cchengoran525/Shadow-Carrier/shadow_carrier_on_rockchip/world/README.md

# world_lab — [世界] 线实验记录与设计决策

> 独立实验区，不依赖/不修改工程任何现有代码。
> 收编进仓库时整体迁移为 `world/` 模块。

## 定位

世界模型 = 让决策端(HRI)知道"周围有什么、哪里能走"。
**不只是认门**——门会开、场景会变，门只是区域(region)的一个填充者。
所有接口按通用语义设计，预留扩展。

## 架构定稿：三层各管各的（2026-08-24）

| 层 | 模型/方法 | 频率 | 职责 |
|---|---|---|---|
| 快语义 | yolov8n INT8（现有 yolo_daemon） | 10-15Hz | 追人、COCO 类物体 |
| 慢语义 | **YOLO-World v2s INT8**（待部署） | **1Hz** | 开放词汇：门/冰箱/饮水机/障碍类别 |
| 几何 | OpenCV（本目录 v3 管线） | 1-2Hz | 可通行性/墙地交界/门框几何验证 |

依据（2026-08 网络调研）：
- RK3566 NPU 只有 INT8 可用（12-18FPS），FP16 掉到 3-5FPS 且 CPU 回退
- yolov8n INT8 ≈ 18FPS；YOLO-World v2s 估 4-8FPS → 只能当慢环
- NPU 预算：yolov8n 55ms×10Hz + YW 200ms×1Hz ≈ 75% 峰值，可行但 YW 不得超 1Hz
- "检测器+几何地图=语义网格"是 2025 机器人主流架构（DIV-Nav/OpenVox/OneMap），方向验证无误

### YOLO-World 部署路径（未完成）
1. PC 装 rknn-toolkit2 **2.0.0**（1.3/1.6 有报错前科）
2. 词汇表**导出时定死**（prompt-then-detect 重参数化进权重），建议词表：
   `door, doorway, refrigerator, vending machine, water dispenser, couch, chair, table, potted plant, tv, staircase, person`
3. `model_zoo/examples/yolo_world/python/convert.py` 转 v2s INT8 (rk3566)；clip_text 只支持 FP16，**离线跑一次**存文本嵌入即可
4. sftp 上板 → 先离线测速（验收线 ≥3FPS）→ 接入融合架构当慢语义环
5. 板上无外网，模型文件 PC 下载后传输

## 实验记录

### B1 门检测三轮（2026-08-24，全部板上实测）

| 轮 | 方案 | 结果 |
|---|---|---|
| v1 | 固定阈值 Canny 50/150 + Hough | ❌ 低对比度门框 0 候选 |
| v2 | 自适应 Canny(median±) + 膨胀 + 共线段合并 + 内部边缘密度 | ✅ demo 门正对/斜对均检出，但有无门槛误报 |
| v3 | + 几何先验（宽高比 0.25~1.3、门框底边须达画面 60% 高） | ✅ **回归基准 3/3 命中、0 误报，参数冻结** |

- 基准集：正对门 / 斜对门 / 走廊门（必须检出）+ 宿舍 / 卫生间（必须零误报）
- 验收脚本 `regression.py`；**改 `params.py` 任何参数必须重跑基准**
- 单帧耗时（带负载）：340~1570ms → 几何环定档 1-2Hz
- 已知边界：消失点仅走廊等强结构场景可靠（不进 grid.json）；杂乱场景 Hough 会飙到 3.5s，需限线数/降分辨率/早退（待做）
- 门检测最终角色：给 YOLO-World 的 door 检出做**几何验证**与兜底，不单独当主力

### 融合第零步（2026-08-24）

`fusion/fusion_test.py`：MJPEG 抓帧(只读) + `/api/detections`(只读) + v3 几何 → 单帧网格快照
- ✅ 机制全通：YOLO bbox 落格正确（obj:tv 对准显示器）
- 标签体系（通用槽位，预留扩展）：`free / blocked / region:<name> / obj:<class>`
- 优先级：obj > region > blocked > free
- 待做：60s 连续压测；帧与 detections 有几十毫秒错位，需量化偏差

### grid.json v1 字段草案（[世界]→[HRI] 冻结接口）

```json
{
  "ts": 0.0,
  "frame_size": [640, 480],
  "objects":  [ {"cls": "person|door|refrigerator|...", "conf": 0.0,
                 "bbox": [x1,y1,x2,y2], "cell": [r,c], "source": "yolo_world|yolov8n|hough"} ],
  "grid":     [ [{"label": "free|blocked|region:*|obj:*", "sources": [], "conf": 0.0}, ...8], ...3 ],
  "timing_ms": {"geometry": 0, "total": 0}
}
```
- `objects[]` 完全开放类别，HRI 按 cls 查询，不写死业务语义
- 待加：地面单应映射后的极坐标（8扇区×3距离环），当前 grid 是图像空间占位版

## 文件清单

| 文件 | 说明 |
|---|---|
| `params.py` | 冻结参数（改动须过回归） |
| `door_v3.py` | 门检测/几何管线（终版） |
| `regression.py` | 验收脚本（基准 8 张照片） |
| `offline_door_test.py / _v2.py` | v1/v2 历史版本（留档） |
| `fusion/fusion_test.py` | YOLO+OpenCV 单帧融合 |
| `fusion/geometry_daemon.py` | 世界快照生成（once/loop/scan，三源融合，grid.json 生产者）|
| `fusion/geometry_map.py` | 滚动地图（HIDE 数据供给，TTL 30s）|
| `fusion/polar_mapper.py` | 像素↔极坐标（射线-地面求交，显式 tilt_deg）|
| `fusion/auto_calib_pose.py` | PnP 扫掠一键标定（H(tilt)/俯角拟合）|
| `fusion/solve_desk_pose.py` / `validate_desk.py` | 单次位姿反解 / 棋盘精度验证 |
| `fusion/of_bridge.py` | 光流桥原型（YOLO 抽帧↔光流插值，录制/评测）|
| `fusion/pose_server.cc` | YOLOv8-Pose 旁路服务（派生 facing/offering，纳秒触发）|
| `fusion/lidar_guard.py` | **V2 雷达避障核**（扫描帧→安全包络+命令过滤，纯逻辑零依赖；见下节）|
| `fusion/lidar_guard_daemon.py` | 扫描文件→安全包络文件的常驻桥（`--once/--replay/--record`）|
| `fusion/test_lidar_guard.py` | 避障核离线回归（51 断言，无硬件）|
| `fusion/calib_prod.json` | **生产位姿经验标定**（Tier1b 已知距离三点：h=148mm/tilt=0.43°，距离 ≤2%）|
| `fusion/calib_pose.json` | PnP 扫掠拟合结果（地面 128~140）|
| `CALIBRATION.md` | **标定总纲**（四层触发流程/工具/验收/原则）|
| `DEPLOY_A35.md` | yolo_daemon 时间戳部署 runbook |
| `polar_mapper.py` / `selftest_polar.py` | 映射模块根副本 + 数学自检 |
| `photos/` | 基准照片 + 各轮标注图 |

## 当前状态 (2026-10-04)

> ✅ **A3.1 完成**：生产文件已全部入仓（本目录即源码备份，与板上 `~/world_lab/` 同步）：
> `geometry_daemon.py` / `polar_mapper.py` / `geometry_map.py` / `auto_calib_pose.py` / `of_bridge.py` /
> `pose_server.cc` / `calib_prod.json` / `calib_pose.json` / `CALIBRATION.md`（均在 `fusion/` 或本目录）

- **grid.json v1 已交付**（冻结接口 [世界]→[HRI]）：`objects[]{cls,conf,bearing_deg,dist_m,...}` + `grid_polar[3][8]` + `free_directions_deg` + `map{doors,free_sectors,...}`
- **三层架构合体**：yolov8n（快）+ hough（门几何）+ YOLO-World（慢语义，开放词汇，板端 NPU）
- **极坐标映射**：PnP 标定链 + 一键 `auto_calib_pose.py`；生产角 tilt=112 地面复标后**测距 ≤2%**（Tier1b 已知距离实物法，`calib_prod.json`）
- **滚动地图**：`geometry_map.py` 被动累积门/物体/自由扇区 → `/dev/shm/world_map.json`，HIDE 零延迟主路径；扫掠降兜底
- **俯仰悬案已裁定**：112=几何水平正确（桌面 116.4 系未摆平）；跟随 production 固定 112，V0.2 抬摄像头后再议工作角

## 下一步

1. ~~**[A3.1] 把板上生产文件迁入 git**~~ ✅ 完成（2026-10-04）
2. Tier4 三方距离互校（PnP vs tracker `dist_m` vs 超声），等 [云台] tracker 上机
3. 与 [HRI] 联合验证 HIDE 选点（滚动地图路径）；已问 [HRI] 是否将选点升级为"亲和度打分取最大"（见 EXCHANGE 10-04 21:00）
4. （P2，冻结后）光流桥 daemon 接口、pose 接入 geometry_daemon、调度器落地
5. IMU 消费（[云台] 探通 MPU6050 后）：yaw rate → 极坐标航向/地图一致性（已提接口需求）

## sector_score v2 审核修复（2026-10-11）

[世界] 代码审核发现并修复 6 项（`world/fusion/sector_score.py`），回归夹具 `test_sector_score.py`（13 断言，改权重/规则必须全绿）：

| # | 问题（实测证据） | 修复 |
|---|---|---|
| A | 两热点近反向时圆形均值退化（门 0°/180° → path 罚到随机扇区） | 合成向量模长 `< OPPOSITE_GUARD(0.25)` 跳过 |
| B | 全扇区被硬禁区覆盖时仍返回被 mask 的 best | `best_sector=None` + `fallback_masked=True` |
| C | CLASS_W 物体被当成"路中间"热点 → 洪泛惩罚（5 物罚 5 扇区） | path 只吃 **门+家电**；类别走独立惩罚 |
| D | `wall_back` 把"开阔地板"当"背墙"（free+wall_back 双重奖励） | 改为「近环 free + 中/远环 blocked」判定，**依赖 grid_polar**；无则不加成 |
| E | 无 margin：两个并列最优仍 confident | 暴露 `margin`（best−second），`confident` 要求 ≥0.2 |
| F | blind 加成落在 mask 扇区 | blind 跳过 masked；mask 分数按扇区去重 |

配套（生产者侧，缓解"很少 confident"的结构问题）：
- `geometry_map.py`：自由证据**按环记录**（键 `ring:sector`，近+中环），旧键（纯 sector）兼容映射为 ring 0
- `geometry_daemon.py`：把 `grid_polar` 传给打分器（背墙判定用）

新增输出字段（纯增量）：`margin` / `ranking` / `fallback_masked`。

## 10-22 修复：生产接线 + "路中间"几何（机主指派复核）

> 触发：机主质疑"HIDE 到底是远离门还是门侧？"→ 查代码发现两处**语义/接线**错误。
> **权重全部未动**（`W` 原值），只改几何算法与数据接线；14 个离线测试文件全 exit 0。

### ① 生产接线 bug：`summary()` 不带 objects → 打分器一半规则空转

`geometry_daemon` 把 `m.summary()` 喂给 `score_map()`，但旧 `summary()` 只输出
`doors/free_sectors`。于是**生产里** `objects` 恒为空 → 家电惩罚、`CLASS_W["person"]`（10-12
`hide_occupied` 的修复）、硬禁区 mask、门-家电 "路中间" **全部不生效**；单测因为手喂
`objects` 才全绿（典型"测试绿、生产空转"）。

- 修复：`geometry_map.summary()` 增 `objects[]{cls, bearing_deg, dist_m, sector, hits, age_s}`
  （纯增量；grid.json `map{}` 只加字段）

### ② "路中间"其实是角平分线，不是连线中点

旧实现取两热点 bearing 的**圆形均值**，只有两者**等距**时才等于连线中点。门通常 3~5m、
家电 1~2m → 角平分线落到两者之间的**空地**，真正被走的线（靠近远端点）没罚；而近反向对
（门↔远家电）被 `OPPOSITE_GUARD` 一刀切跳过 —— 那恰是最忙的一条路。

- 修复：`dist_valid` 且两端有 `dist_m` → **向量中点**（`x=d·sin b, y=d·cos b`）；
  距离不可信 → 退回角平分线并在 `reasons["path_bisector"]` 标注；中点距车体
  `< PATH_MID_MIN_M(0.5m)`（这条路穿过车）跳过
- 新增 reasons 键（纯增量）：`path_geo` / `path_bisector`

### ③ HIDE 落点回退"门优先"= 朝门走（`scripts/hri_state.py`，属 [HRI]）

HIDE 语义是**远离门**（门 = 交互亲和度极高 → 强惩罚），但旧回退直接把**门的方位**
当安全点 → `GOTO_SAFE <bearing>` 朝门转身+前进 ≤1.5s。

- 修复（机主直接指派跨线修改，请 [HRI] 复核）：回退顺序改为
  **打分 → 自由方向（排除门 ±45°）→ 背离门**；顺带修 `map.free_sectors`（dict）被
  `abs()` 的 TypeError
- 回归：`scripts/test_pick_safe_spot.py`（6 断言）
