cchengoran525/Shadow-Carrier/shadow_carrier_on_rockchip/deploy/c3-watchdog/README.md

# C3 USB Watchdog (免物理插拔恢复 C3)

## 背景
ESP32-C3 通过 USB-C 直连 KickPi 时, 偶发"从 USB 消失 / 枚举卡死", 表现为
网页遥控还在但指令到不了 C3、云台失声、电机无响应 —— 历史上需**手动重新插拔**。
典型触发: 舵机堵转电流冲击导致掉电/复位 (见 EXCHANGE 2026-10-03 [云台] 事故分析)。

## 能力边界 (诚实说明)
| 情况 | 本看门狗 | 说明 |
|---|---|---|
| C3 仍在 USB 上, 但软链/服务异常 (枚举卡死) | ✅ 自动 `usbreset` 恢复 | 已实测通过 |
| C3 从总线消失, 但仍供电 (枚举级) | ✅ xHCI 深度复位 (unbind/bind), 实测 1s 重枚举、相机不受影响 | 2026-10-21 验证 |
| C3 真掉电 / 无 D+ 上拉 | ❌ 只能记日志等待自行枚举 | 需可控 VBUS(GPIO/uhubctl) 或电源侧解决 |

## 文件
- `c3_watchdog.sh` —— 每 3s 检查 `303a:1001` 与 `/dev/c3_controller`; 连续 2 次异常则 `usbreset BBB/DDD` 复位, 失败则重启 `rk-control`
- `c3-watchdog.service` —— systemd 常驻 (Restart=always)

## 安装 (板端, 需 root)
```bash
sudo install -m 755 c3_watchdog.sh /usr/local/bin/c3_watchdog.sh
sudo cp c3-watchdog.service /etc/systemd/system/c3-watchdog.service
sudo systemctl daemon-reload
sudo systemctl enable --now c3-watchdog
```

## 验证 (安全: 仅删软链, 设备仍在)
```bash
sudo rm -f /dev/c3_controller     # 模拟异常
sleep 15
ls -l /dev/c3_controller          # 应已被 udev 重建
sudo tail /var/log/c3_watchdog.log
```
预期日志: `reset via usbreset 005/002 (5-1)` → `recovered (symlink present again)`。

## 备注
- 现有 udev 规则 `99-c3-usb.rules` 会在设备重新枚举时自动重启 `rk-control`, 与看门狗互补
- 若 C3 掉电型掉线反复出现: 优先解决电源(电机/舵机与 C3 分开供电、加电容), 而非换传输

## 为什么"原生 USB 老要重插"（2026-10-21 调研）

**不是 USB-C 接口的通病，是 ESP32-C3/S3 内置 USB Serial/JTAG（原生 USB）的已知行为：**

1. **C3 官方文档（USB Serial/JTAG Console → Sleep Mode）**：light sleep 时 APB/USB PHY 时钟被门控，**USB PHY 的 D+ 仍保持上拉** → 主机看不到"拔出"，可能**不会重新枚举**；官方给的恢复办法就是**物理拔插 USB**。
   <https://docs.espressif.com/projects/esp-idf/en/v5.2/esp32c3/api-guides/usb-serial-jtag-console.html>
2. **Espressif FAQ（USB）**：C3/S3 的 USB-Serial-JTAG 在芯片重启时会重新初始化；若固件不稳定/反复复位，主机会看到**每隔几秒连上又断开**。建议：手动进下载模式，或**先烧一版稳定固件走 UART**。
   <https://docs.espressif.com/projects/esp-faq/en/latest/software-framework/peripherals/usb.html>
3. **TinyUSB #2943（S3）**：S3 上电时 DP/DM 先被 mux 到 Serial-JTAG，固件再切到 OTG 时主机可能已锁在 JTAG；**中间加一个 USB hub 就能正常枚举**。
   <https://github.com/hathach/tinyusb/issues/2943>
4. **`ttyACM*` 是 MCU 本身**：复位/重启时端口必然消失再出现（`ttyUSB*` 的桥片则不会）。所以"复位就掉口"是原生 USB 的正常语义；问题在于**主机不一定重新枚举**。
5. 另有一个独立常见原因：**充电线（charge-only）只有 VBUS、没有 D+/D-** → LED 亮但 `lsusb` 里没有设备。换数据线即可。

## S3 重构建议（避免反复拔插）

按"最稳 → 次稳"排序：

1. **控制链路改用 USB-UART 桥**（CH340/CP2102/FT232，`ttyUSB*`）：桥片与 MCU 解耦，**MCU 复位不影响串口枚举**；原生 USB 只留给烧录/调试。这是机器人控制链路最稳的做法。
2. **S3 与 RK 之间加一个 USB hub**（TinyUSB #2943 的实证），并用**支持每端口断电的 hub + `uhubctl`**：看门狗即可"电源循环"端口，软件自动恢复，不用手拔。
3. 若坚持原生 USB：
   - 固件**不要 reconfig USB 引脚**、**USB 连接时不要进 light sleep**（C3 用 `CONFIG_USJ_NO_AUTO_LS_ON_CONNECTION`；保留 `CONFIG_RTC_CLOCK_BBPLL_POWER_ON_WITH_USB`）；
   - 尽早把 DP/DM mux 切到目标外设（OTG 或 JTAG），避免主机锁在 JTAG；
   - 避免运行中软件复位（看门狗复位）导致 D+ 不释放。
4. **硬件**：C3/S3 用**独立稳定 5V**（不要和电机/舵机共轨），加 470–1000µF 储能 + ESD/CC 电阻；上电顺序 **KickPi → C3 → 电机电源**。
5. **看门狗边界**：总线上完全没有设备时，`usbreset` 无目标；只能记日志/快照（本脚本已加"absent 每 60s 一次 + USB 树/dmesg 快照"）。要自动恢复，必须配合**可控 USB 电源开关/hub**。

## RK3566 板级 USB 老毛病（古早踩坑实录，2026-08-07 → 10-14）

> 结论先说：**"要反复插"不只是 C3/S3 原生 USB 的问题，RK 板这端的 USB 枚举/供电也是老病根。换 S3 不会自动修好。**

| # | 方案 | 结果 |
|---|---|---|
| 1 | RK 板载 UART `ttyS5/S7/S9` | ❌ TX 无物理信号 |
| 2 | CH340 USB-TTL | ❌ 自环通、接 C3 无信号，**OHCI 崩溃** |
| 3 | CP2102 USB-TTL | ❌ 同崩溃 |
| 4 | WiFi TCP（C3 连热点） | ❌ AP6255 beacon 对 ESP32-C3 不可见 |
| 5 | **C3 USB 直连（CDC ACM）** | ✅ 可用，但**冷启动/掉电后常不重新枚举** |

**佐证：**
- `gimbal/README.md`（2026-10-03）："**放大器=板级**：C3 掉电后 USB 不重新枚举的老毛病，把一次舵机事件放大成遥控全失效"；"**证伪实验**：换硬件后若'无咔咔却仍掉线' ⇒ **板级 USB 枚举缺陷独立存在**，需单治"。
- `README.md` 已知问题 #1："冷启动 C3 需插拔（待定位）"。
- EXCHANGE 10-14 22:07：**C3 = Bus5 = OTG/DRD；相机 = Bus7 = Host；不同控制器但共用 RK3566 USB2 PHY 与端口供电域** → C3 重枚举会掀相机；watchdog+udev 曾把 C3 重枚举放大成 rk-control 重启风暴。
- `docs/V2_CHASSIS_GIMBAL_DESIGN.md §19.5/19.6`：VBUS 跌落/线材 IR 压降（1m 28AWG ≈0.42Ω，2A 掉 0.85V）会直接导致 **USB 重新枚举**；验收线 **5V min ≥4.75V**，短粗线 ≤30cm/20–22AWG + 470–1000µF。

**给 S3 迁移的验收清单（不重复拔插）：**
1. **主机侧可控电源**：USB hub + 每端口断电（`uhubctl`）→ 看门狗可电源循环；这是对"板级枚举缺陷"最直接的软件可恢复方案。
2. **避开 OTG/DRD 口**（Bus5）或加 hub 隔离，别和相机共用 PHY/供电域。
3. **供电**：C3/S3 独立稳定 5V（不共电机轨）+ 短粗线 + 470–1000µF；上车前用 USB 电压表测 **min 5V ≥4.75V**。
4. **固件**：USB 连接时不进 light sleep、不重配 USB 引脚、尽早 mux DP/DM；避免运行中看门狗复位。
5. **保留** `c3-watchdog` + 冷启动检查单；S3 的 udev 别名与 `CDCOnBoot` 参数要重做（V2 §5 已提）。

## 已验证的软件恢复：xHCI 深度复位（2026-10-21，免拔插）

本板拓扑：**C3 = `xhci-hcd.4.auto`**（`usbdrd/fcc00000.dwc3`, bus5, OTG/DRD）；**相机 = `xhci-hcd.5.auto`**（`usbhost/fd000000.dwc3`, bus7, Host）——**不同控制器**。

```bash
# 手动深度复位（需 root）
echo xhci-hcd.4.auto > /sys/bus/platform/drivers/xhci-hcd/unbind
sleep 2
echo xhci-hcd.4.auto > /sys/bus/platform/drivers/xhci-hcd/bind
```

**实测**：unbind 后 C3 消失（相机仍在）；bind 后 **C3 1s 内重新枚举**、`/dev/ttyACM0` 回来、**相机完全不受影响**（fps 14.4 / age 10ms）。
**看门狗已集成**：C3 持续 absent **30s** 自动做一次深度复位（冷却 60s）；日志 `deep reset xHCI ...` → `recovered via xHCI deep reset`。

**边界（重要）**：深度复位只对"设备还供电、D+ 仍上拉，但主机没枚举"有效。若 C3 **真掉电/没上拉**，bind 也看不见——这时只能：
- **可控 VBUS/端口电源**（GPIO+MOSFET 或支持 `uhubctl` 的 hub）→ 看门狗断电 1s 再上电，强制重新枚举；
- 或独立 5V + 大电容/换线，减少掉电本身。

## 可控 VBUS / 端口电源（可选，治"真掉电"）

看门狗已内置 3 种后端；配置后，在 xHCI 深度复位仍无效时会自动做一次电源循环。用 systemd drop-in 配（无需改脚本）：

```bash
sudo mkdir -p /etc/systemd/system/c3-watchdog.service.d
sudo tee /etc/systemd/system/c3-watchdog.service.d/vbus.conf >/dev/null <<'EOF'
[Service]
# 三选一：
# 1) GPIO 控 MOSFET/load switch（sysfs；C3_VBUS_ACTIVE=1 高有效，0 低有效）
Environment=C3_VBUS_GPIO=123
Environment=C3_VBUS_ACTIVE=1
# 2) uhubctl 支持每端口断电的 hub
#Environment=C3_HUB_LOC=5
#Environment=C3_HUB_PORT=1
# 3) 自定义命令（命令自己完成断电/上电）
#Environment=C3_VBUS_CMD=/usr/local/bin/c3_power_cycle.sh
Environment=C3_VBUS_OFF_S=2
Environment=C3_VBUS_SETTLE_S=3
EOF
sudo systemctl daemon-reload && sudo systemctl restart c3-watchdog
```

- **GPIO 必须驱动 MOSFET/负载开关**，不要用 GPIO 直接给 C3 供电（电流不够/会烧）。
- 自检：`sudo c3_watchdog.sh --selftest-vbus` → 日志出现 `vbus cycle via ...`；正常启动日志会标 `vbus=yes/no`。
- 日志顺序：`deep reset xHCI ...` →（仍失败）`vbus cycle via ...` → `recovered via VBUS power cycle`。
