cchengoran525/Shadow-Carrier/shadow_carrier_on_rockchip/world/fusion/calib_report.md

# 相机位姿标定报告 (2023-03-02 21:33)

| tilt指令 | 光心高度mm | 真实俯角° | RMS px | 角点 |
|---|---|---|---|---|
| 128 | 98.8 | 20.00 | 1.94 | 54 |
| 132 | 95.9 | 25.57 | 1.77 | 54 |
| 136 | 93.1 | 30.85 | 1.60 | 54 |
| 140 | 90.6 | 35.47 | 1.43 | 54 |

H(cmd) = -0.6847·cmd +186.4 (残差≤0.2mm)
tilt_true(cmd) = 1.2921·cmd -145.2 (残差≤0.30°)
等效零俯角指令 = 112.4, DEG_PER_CMD = 1.292

> 换相机/换位置后重跑 auto_calib_pose.py 即可刷新本报告
