cchengoran525/Shadow-Carrier/docs/V2_LIDAR_AVOIDANCE.md

# V2 激光雷达避障设计（YDLIDAR X3 Pro / 夹层安装 / 约束层架构）

> 写于 2026-10-16。回答一个问题：**雷达到手之前，避障逻辑先怎么备好**——到手后 30 分钟能上车，
> 且不打断 demo 冻结期的任何现有行为。
>
> 关联：`V2_CHASSIS_GIMBAL_DESIGN.md` §10.5（选型）/§10.5.1（作用边界）/§13（×HIDE 亲和度）/
> §14（暗光与传感器分工）/§15.7（夹层安装决议）；`DEFERRED_WORK.md` §2（雷达 L1）；
> `V2V3_ROADMAP.md` §2 V2b（传感器全装）；`world/fusion/test_bearing_convention.py`（方位角约定权威自检）。
> **姊妹篇**：`V2_LIDAR_FOLLOW_UPGRADE.md`（把雷达从"障碍源"升级为"匿名腿航迹源"：覆写阶梯 / 人-障碍仲裁 /
> 相机盲区授权与实测协议 / 度量纪律 §8）。两篇共用 `person_legs` 与方位角约定，彼此不阻塞。

---

## 0. 定位：雷达三件事，本文只做第 ② 件

| # | 用途 | 归属 | 状态 |
|---|---|---|---|
| ① | **几何源**：门框/墙/开阔区 → grid.json 第四源 `lidar`（替换手标 grid.json） | [世界] geometry_daemon L1 | V2b，不在本文 |
| ② | **安全**：360° → **运动约束**（限速/停车/绕行提示） | 本文 | **本次备好** |
| ③ | SLAM / 建图 / 重定位 | PC 科研轨（离线） | V2 只负责**录原始帧** |

一句话边界：**避障不是"另起一个规划器"，而是给已有运动命令加一层可测的约束**。
它不决定"该不该跟、该不该让"（那是 follow / hri_state 的语义），只回答
"以这个速度朝这个方向走，会不会撞、最多能多快"。这条分界让整套东西可以离线断言，
也让 demo 期可以整体关掉（见 §7 惰性契约）。

### 0.1 本次交付物（已入仓，无硬件即可跑）

| 件 | 路径 | 说明 |
|---|---|---|
| 避障核（纯逻辑） | `world/fusion/lidar_guard.py` | 扫描帧 → 安全包络 + 命令过滤；零第三方依赖 |
| 离线回归 | `world/fusion/test_lidar_guard.py` | **56 条断言**，`python3 test_lidar_guard.py` 全绿 |
| 参数文件 | `configs/lidar_guard.json` | 装车实测只改这里，不改代码 |
| 常驻桥 | `world/fusion/lidar_guard_daemon.py` | 扫描文件 → 安全包络文件；支持 `--once/--replay/--record` |
| 命令收口 | `scripts/rk_control.py`（`uart_send` 前） | **惰性**：没有安全文件时逐字节不变；新增 `GET /safety` |
| 仿真验证 | Webots `SIM_LIDAR=1` + 场景 `lidar_sweep_block` | 几何真值 360° 扫描走**同一条**代码路径 |
| 文档 | 本文 | 含参数表、失效清单、上车三步、待办 |

**待硬件（V2a/V2b 的活）**：YDLidar-SDK aarch64 编译 + 扫描桥（写 `lidar_scan.json`）、
装车几何实测（传感器位置/柱位/平面高度/满 PWM 车速）、参数在实机上定标（§8.4）。

---

## 1. 现状与为什么单独设计

现有唯一避障路径（V1，全部保留不动）：

```text
HC-SR04(正前 ±15°, 2cm 精度) → 固件 UltrasonicSensor → MotorDriver.setObstacleDetected
   → 前向 latch 停车 + 打印 "OBS <0|1> <cm>" → rk_control 读遥测
   → _gaze_drive_loop 倒车脱离（GAZE_ENABLED=False, demo 期未启用）
```

它的能力边界：**一个方向、一个数、20cm 阈值、只看正前**。V2 的雷达带来 360° + 5–10Hz + 8m，
但直接接进去会踩三个坑，这也是本设计的三个立论：

1. **时延链必须显式**（否则"多少米该停"是拍脑袋）。扫描 10Hz（100ms）+ 环 10Hz（100ms）+
   USB/串口（~10ms）+ 固件缓启（~100ms）≈ **t_react = 0.35s**。0.6m/s 时这 0.35s 就吃掉 21cm，
   加上制动 30cm 与保留间隙 8cm → **需要 0.59m 间隙才能跑满巡航速度**。这个数必须写进代码（§4.3）。
2. **禁止双控制器抢底盘**。V1 的教训（`gaze_drive_loop` 与 follow 抢底盘 → 往右拐越拐越偏）说明：
   避障若自带一套运动律，就会和 follow 打架。本设计的解法是**约束层**：不产生新运动，
   只对"别人已经发出的命令"限速或否决。
3. **噪声不得推动整车**。雷达有飞点、玻璃穿透、镜面反射、雨雾；单帧异常必须过迟滞（§4.5），
   这条与 `hri_state` 的施密特去抖、`sector_score` 的 freeze 协议是同一套工程原则。

---

## 2. 传感几何：装在哪、看得见什么、看不见什么

### 2.1 安装（沿用 §15.7 修订版决议）

```text
上层板 z=17.5cm ─────────────────────────────────
                  ↑ 4cm
扫描平面 z≈13.5cm  ← 雷达坐在下层板小基座上（本设计的坐标系原点）
                  ↓ 8cm
下层板 z=5.5cm ──────────────────────────────────
```

- **唯一自遮挡 = 4 根铜柱**（Ø6mm @ 距传感器 17.5cm → 每根 **~2°**）。代码不写死角度，而是
  由 `pillars_xy + sensor_x/y` **自动算遮罩**（含 2° 安装余量），改安装位置只改两行配置。
- **双保险**：铜柱本身在 17.5cm，落在 `range_min_m=0.24` 的近场滤波圈内 → 回波被丢弃；
  遮罩再挡住"柱后 2° 楔形的远端盲区"。两者独立生效，任一条误配都不会漏。
- 轮子（顶 8cm）、上层板（17.5cm）、桅杆、篮子**都不在平面内** → 不需要遮。
- 实测的默认配置里遮罩为 `[[33.9,39.9],[320.1,326.1],[140.1,146.1],[213.9,219.9]]`（±36.9°、±143.1°）。

### 2.2 看得见 / 看不见（这张表就是产品说明书的"能力边界"）

| 物体 | 13.5cm 平面看得见? | 谁兜底 |
|---|---|---|
| 人腿 / 椅子腿 / 桌腿 / 箱体 / 墙 / 门框 | ✅ | — |
| **玻璃门、镜面** | ❌ 直接穿透 | 相机 door_v3 + 超声（互补矩阵主场） |
| **矮于 13.5cm 的东西**（门槛、地漏、躺倒的瓶子、地毯边） | ❌ | 超声（正前）+ 演示时避开 |
| **桌面/台面悬挑**（腿看得见、台面看不见） | ⚠️ 只见腿 | 靠"腿级聚类"保守处理 |
| 台阶**下**（负障碍：向下的落差） | ❌（单线平面原理性看不见） | 场景约束：SC 不做下台阶 |
| 动态物体（人、推车） | ✅ + `closing_mps` 提前量 | — |

**结论**：雷达不是"全知"，它是"腿部高度的 360° 轮廓"。所有失效都必须在 §6 有对应对策与降级，
而不是假装没有。

### 2.3 装车验收 3 条（上车前 10 分钟）

1. **平面水平**：倾斜会变成"远端切到上层板"——软尺量传感器座上沿，两端读数差 ≤2mm；
   或看空场扫描：远点距离环应是一个圆，不是椭圆。
2. **空场干净**：房间中央扫描，`GET /safety` 的 `sectors_m` 应只有四面墙的四个"台阶"，无近距满圈
   （近距满圈 = 平面切到板/柱没被滤掉 → 查 `range_min_m` 与 `pillars_xy`）。
3. **满 PWM 车速实测**：直行 5m 计时 → 填 `configs/lidar_guard.json` 的 `v_at_spd_max`
   （这决定"限速×0.6"到底是多快；填错只是保守/激进，不影响安全逻辑本身）。

---

## 3. 架构：三段解耦 + 一个收口

```text
 ┌── 扫描生产者(V2b, 待做) ──┐   ┌── 本设计(已备好) ──────────┐   ┌── 已有链路 ────────┐
 │ YDLidar-SDK 桥(aarch64)   │   │ lidar_guard_daemon.py      │   │ rk_control.uart_send│
 │ 读 /dev/ttyUSB0           │──▶│  lidar_guard.update()      │──▶│  _safety_filter()   │
 │ 原子写 lidar_scan.json    │   │  → lidar_safety.json       │   │  → 固件(450ms/超声) │
 └───────────────────────────┘   └────────────────────────────┘   └────────────────────┘
     可独立坏/独立重启                 纯逻辑, 可离线回放              单一收口, 惰性生效
```

### 3.1 为什么收口在 RK 的 `uart_send`，而不是固件

- 雷达挂**电子域**（充电宝 5V + USB），只有 RK 有它的数据；S3 拿不到 → 固件无法直接消费。
- `uart_send` 是所有运动命令的唯一出口（follow / hri_state / 弧线绞合 / 网页面板 / 转身动作），
  在它前面过滤 = 一处生效、无人遗漏，且**各控制器不需要知道雷达存在**。
- **固件层完全不动**：450ms 超时 + 超声 latch 仍是最后一道硬件兜底（V1 已验证，不冒回归风险）。
- 代价要写明白：**雷达只能约束"命令"，不能约束"固件自己"**。若将来要固件级雷达反射弧，
  需要新增 `LIMIT` 通道（§10 待办，V3 再谈）。

### 3.2 惰性契约（demo 冻结期的安全阀）

```text
/dev/shm/lidar_safety.json 不存在  →  过滤是直通, 现有链路行为逐字节不变
文件存在且新鲜                     →  按安全包络限速/停车
文件存在但过期 (>1.0s)             →  视为 stale: 只限速到 degrade_speed_mps(0.3), 不施加停车
过滤链自身异常(文件坏/模块缺)      →  放行原命令 + 一条节流日志, 绝不阻断控制
```

**为什么 stale 是"限速"而不是"停车"**：雷达是**增强件**，基础安全由超声（正前）+ 相机（语义）承担。
若雷达一坏整车就停，等于把雷达变成单点故障——这是产品级错误。但也不能装作没事：
`mode/ok/scan_age_s` 会进 `/safety` 与 grid.json 的 `sensors.lidar`（§14.4），
行为层可以据此降级（例如暗光模式 L2 要求 `lidar.ok=true`）。**cap 还是 stop 是可配置的**
（`degrade_action` 语义在过滤层，`degrade_speed_mps=0` 即等价于停）。

---

## 4. 核心算法（每条都有对应断言）

### 4.1 预处理（`to_robot_frame`）

原始 `(方位, 距离)` → 去掉：遮罩角（§2.1）、量程外（<0.24 / >8m）、超近自反射、
**同角去重**（单回波雷达一个方位只有一次回波；同方位双点取更近——这同时挡住了
"腿点与墙点交叠"造成的假聚类）、**飞点**（±3° 内无邻点，或与邻点中位距离差 ≥max(0.30, 0.45×中位)
且 >1.2m → 丢；近处一律保留，因为"近处误停便宜、漏停昂贵"）。稀疏帧（<100 点）不做飞点剔除。

### 4.2 净空：矩形车体 + 走廊（`clearance_dir` / `rotation_gap`）

- 车体是 **30×34cm 的矩形**，不是圆。行进方向 θ 的支撑函数直接给"沿行进半长 / 横向半宽"
  （`|cos θ|·L + |sin θ|·W` 等）——比固定半径准确，且能区分"正着走"和"横着走"。
- **四方向间隙**：只统计落在**行进走廊**（横向 ≤ 车体横半宽 + 5cm 余量）内的点，
  间隙 = 沿行进投影 − 车体沿行进半长（**从保险杠量起，不是从车心量起**）。
- **转向净空**：最近点半径 − 外接圆半径 0.227m（原地转扫掠圈）。
- 障碍"已被甩在身后"（投影 < −0.10m）不计。

### 4.3 速度律：间隙 → 速度上限（`v_from_gap`）

制动距离模型 `v·t_react + v²/(2a) ≤ gap − 8cm`（`t_react=0.35s`、`a=0.6m/s²`）的解析解：

| 障碍间隙（从保险杠算） | 允许速度 | 判定 |
|---|---|---|
| < 5cm（硬间隙 `hard_gap_m`） | 0 | **立即否决**（不等迟滞窗） |
| 0.10 m | 0.05 | blocked（低于 `v_min=0.15`） |
| 0.20 m | 0.22 | 限速 |
| 0.40 m | 0.44 | 限速 |
| **0.59 m** | **0.60** | 刚好跑满巡航（`gap_required(0.6)`） |
| ≥ 0.60 m | 0.60 | 不干预（`v_nom`；包络只限不促） |

- 恢复（解除 blocked）需间隙 ≥ `gap_required(v_nom)+0.15 = 0.74m` → 与触发线 0.59m 形成滞回带。
- **`v_nom` 只做"限"，不做"提"**：速度的期望值归 follow/HRI，雷达只给天花板。
- 参数化好处：`a` 从 0.6（舒适）调到 2.0（室内急刹）时，整张表自动收紧，不用改任何逻辑。

### 4.4 动态目标：提前量（lead compensation）

对每个簇做极坐标最近邻跟踪（贪心关联，门 10°/0.6m），EMA 求径向速度：
- 等效间隙 `gap_eff = gap − max(0, closing)·t_react`——"正在靠近的东西"提前吃掉反应距离；
- 输出 `closing_mps / dynamic`；腿级聚类（宽 5–45cm、距 0.3–5m）单独列出 `person_legs`，
  供 HRI/跟随消费（V3 的"腿级人物"能力这次已经顺手拿到）。
- **主人不是障碍**：跟随的正常收敛由 follow 的距离保持负责（目标 1.2m / 实距 <0.7m 停），
  雷达的 stop 只在"制动距离不够"时兜底（例如主人急停、或路人在中途切入）。

### 4.5 迟滞（`_hysteresis`）

- 判定 `blocked` 需**持续 0.25s**（单帧噪声不推动整车）；解除需**持续 0.4s 且间隙回到 0.74m**；
- 例外：间隙 < 5cm（硬间隙）**首帧即否决**——迟滞不能拖住碰撞保护；
- 确认窗内速度上限不放松（否则"确认"期间还能全速冲）。

### 4.6 绕行提示（`escape`）——V2 麦轮的红利位

前方受阻时给出几何最优的脱离方向：`left/right`（带**符号化 vy**，正值向右）+ 可用速度，
全是 `hold` 则"四面受阻，原地等待"。**本设计不自动执行**：提示交给行为层（follow 的横向偏置、
HRI 的 YIELD），因为"往左让还是往右让"是社交决策，不是几何决策。
（V1 差速底盘只能观测；V2 麦轮横移时这条才是可执行的。）

### 4.7 健康：三种非 ok（`mode`）

| mode | 判据 | 为什么需要 |
|---|---|---|
| `ok` | 帧新鲜且有效点 ≥20 | 正常 |
| `stale` | 帧龄 > 0.6s | SDK 进程死了/线松了 |
| **`suspect`** | 有效点 <20（帧却是新鲜的） | **安静失效**：探头被挡、起雾、镜面脏——SDK 照常出版本、照常刷时间戳，但什么也没看见。这条防止"无事发生"被当作"前方畅通" |

---

## 5. 接口契约（四个，全部纯增量）

### 5.1 扫描帧（生产者 → daemon）`/dev/shm/lidar_scan.json`

```json
{"frame_id": 4211, "ts": 10892.597,
 "points": [[0.0, 2.34], [1.2, 2.31], ...]}      // [方位角°, 距离m]
```
兼容 `{"angles":[...], "ranges":[...]}`（标准雷达输出）。**原子替换写入**（tmp + rename）。

**`ts` 约定用 `time.monotonic()`**（与 guard 内部时钟同源）。2026-10-24 修订：本节旧示例
曾写 epoch 值——guard 按 `now(monotonic)-ts` 算帧龄，epoch 帧的 `scan_age` 恒为 None，
**stale 检测静默失效**（实测踩中，雷达拔线系统仍认为数据新鲜）。guard 现已双时钟兼容
（`lidar_guard.py` update()，T11c/T11d 断言），monotonic 为约定首选，实测记录见附 D。

### 5.2 安全包络（daemon → 命令路径）`/dev/shm/lidar_safety.json`

| 字段 | 含义 |
|---|---|
| `ok/mode/scan_age_s/n_points` | 健康（§4.7） |
| `limits` | `vx_max/vx_min/vy_max/vy_min/wz_max_dps`（SI：m/s、deg/s） |
| `blocked` | `{fwd,back,left,right,rot}` 布尔（已过迟滞） |
| `gap_m` / `rot_gap_m` / `gap_required_m` | 四方向间隙、转向净空、当前速度的需求间隙 |
| `nearest` | 最近障碍（方位/距离/间隙/类别/closing/dynamic） |
| `person_legs` | 腿级行人列表（方位/距离/closing） |
| `sectors_deg` + `sector_m[24]` + `sector_n[24]` | 扇区最小距离（供可视化/调试） |
| `mask_deg` | 生效的遮罩区间（自证配置正确） |
| `escape` | 绕行提示（§4.6） |

### 5.3 命令过滤语义（`apply_to_ascii`）

| 命令 | 语义 |
|---|---|
| `MOVE F/B <spd>` | 前进/后退：对应方向 blocked → `STOP`；否则按 `vx` 包络换算成 PWM 限速 |
| `MOVE L/R <spd>` | **V1 固件语义 = 原地旋转**（坦克转向）→ 受"转向净空/`wz` 包络"约束，**不受横向走廊约束**。V2 麦轮若把左右键改成"真横移"，置 `move_lr_is_rotation=false` 即切回走廊判定（两种语义都已测） |
| `DIFF Lx Ry` | 共模（前进）按 `vx` 包络压到上限；差模（转向）按 `wz` 包络压缩；前进方向 blocked → `STOP` |
| `MEC vx vy wz` | 逐轴钳位（线上单位 cm/s、rad/s ↔ SI 在过滤层换算） |
| `STOP/PAN/TLT/TEL/*` | 一律原样放行（云台与遥测不受避障影响） |

### 5.4 grid.json 的 `sensors.lidar`（§14.4 纯增量，消费方零改动）

```json
{"lidar": {"ok": true, "age_s": 0.08, "mode": "ok", "n_points": 412}}
```
`lidar_guard.grid_sensors(env)` 直接产出该片段，交给 geometry_daemon 合入即可。

---

## 6. 失效模式与对策（逐条交底）

| 失效 | 现象 | 对策 |
|---|---|---|
| 玻璃 / 镜面 | 前方空无一人，实际是玻璃门 | 原理性无解 → 相机 door_v3 兜底；`suspect` 只覆盖"几乎无回波"，穿透时反而有回波 |
| 矮物 / 负障碍 | 完全看不见 | 超声正前兜底；场景约束（不做下台阶）|
| 探头被挡 / 雾 | 帧新鲜但几乎无点 | `suspect` → 降级限速 + `ok=false` 上报 |
| 平面倾斜 | 远端切上层板 → 远点假障碍 | 装车验收（§2.3）+ `range_min_m`；诊断看 `sector_m` 是否出现固定半径环 |
| 飞点 / 多回波 | 单点跳变 | 同角去重 + 飞点中位差滤波 + 迟滞 |
| 人群（多点簇） | 一张"人墙" | 逐簇独立判定；窄簇=腿（可绕）、宽簇=墙（只能等）；绕行提示给出方向 |
| SDK 死 / 线松 | 帧不再更新 | `stale` → 限速（cap 模式），`ok=false` 上报，health 可查 |
| 参数填错（`v_at_spd_max`） | 限速比例不对 | 只影响保守/激进，不影响安全逻辑；§2.3 第 3 条标定 |
| 雷达与超声不一致 | 一个说停一个说走 | **取更保守**（两层独立生效，天然"或"逻辑） |
| 主人站在正前 | 车被"避障"卡住不跟 | follow 的距离保持先接管（1.2m/0.7m）；雷达间隙律在 0.59m 才介入 → 不冲突 |

---

## 7. 分阶段上车（每步可回退，不押注）

| 步 | 做什么 | 验收 | 回退 |
|---|---|---|---|
| **0. 观察** | daemon `--once`/常驻跑，**不接过滤**（`/safety` 只看不拦） | 手推车绕房间，`sector_m` 与实际一致；门框/墙可辨；无固定假障碍 | 杀掉 daemon 即可 |
| **1. 限速** | 接过滤，先把 `a_brake` 调小（0.4）只做"限速" | 走廊直行跟随：靠近障碍时明显减速但不停 | `rm` 安全文件 = 直通 |
| **2. 停车** | `a_brake` 回 0.6，开硬间隙否决 | `lidar_sweep_block` 台架复现：正前 30cm 放箱 → 停车；撤走 → 恢复 | 删 `blocked` 里对应键的判定开关 |
| **3. 绕行（V2 麦轮）** | 行为层消费 `escape`：follow 加横向偏置、YIELD 走 vy | 走廊长椅：横移绕过而非停下等 | `escape` 只是提示，不消费即退回步 2 |

**demo 期（现在）**：共存方案是"daemon 不跑 = 不存在"（§3.2），V1 demo 链路零风险。

---

## 8. 验收与实验

### 8.1 离线（现在就能跑）

```bash
cd shadow_carrier_on_rockchip/world/fusion
python3 test_lidar_guard.py          # 56 断言: 迟滞/硬间隙/遮罩/近场/飞点/腿级/stale/suspect/命令语义/符号约定
python3 lidar_guard_daemon.py --replay scans.jsonl   # 回放录制的扫描帧(调参用)
```

### 8.2 仿真（互补矩阵的受控证据）

```bash
cd shadow_carrier_on_rockchip/simulation/webots
SIM_LIDAR=1 ./run_robustness.sh "lidar_sweep_block" 1
SIM_LIDAR=1 ./run_robustness.sh "baseline" 1     # 回归: 开雷达后基线仍须 PASS
```
`lidar_sweep_block` 的构造：路人站在车**正后方 0.40m**（最近点 ≈0.21m < 车体扫掠圈 0.227m）——
**正前超声完全看不见**，但原地左转会把他扫进车体扫掠圈，而车按"搜索主人/取景"的语义持续请求原地左转。
判据（注入窗口 6–26s）：超声全程 CLEAR + 雷达 `blocked.rot` 触发 + 窗口内车几乎没转。

**✅ 2026-10-16 实跑结果（realtime，1 次）**：

| 场景 | 判定 | 证据 |
|---|---|---|
| `lidar_sweep_block` | **PASS** | 窗口内 65 帧：超声全程 200cm（CLEAR）· 雷达 veto **63 帧** · 车只转 **0.0 rad** · 命令过滤 43 次（日志原文：`lidar: 原地转受阻(净空=0.01)`） |
| `baseline`（SIM_LIDAR=1） | 见下注 | 与雷达无关：同一条链在 **`SIM_LIDAR` 不传时同样 FAIL**，且**原始 HEAD + 本次声呐修正**跑基线是 **PASS** |

> ⚠️ 注：本次基线 FAIL 的根因不在这条线——工作区里同时有另一条线未提交的 `TURN_ON/GT_TURN`
> （掉头/扫掠）改动在改 `shadow_carrier.py` / `follow_controller.py` / `owner_id.py`，
> 表现为 `HIDE -> FOLLOW（主人消失, 扫掠中断）`、缺 RECEIVE。归属以那条线为准；本线的验证结论
> 用"注入窗口内的对照"取证（上表第一行），不依赖基线。
>
> 另：仿真控制器是**共享文件**，多人同时跑会写同一个 `sim_session.jsonl`（实测出现过两个会话
> 交错写入 → JSON 行被截断）。已加 `SIM_LOG=<路径>` 环境变量与解析器容错（半行跳过），
> 并行跑请各自指定 `SIM_LOG`。

### 8.3 上车三步（各 10 分钟，带卷尺）

1. **静态量尺**：把纸箱依次放在正前/左/右/后 0.3/0.5/1.0m，核对 `/safety` 的 `gap_m`（误差应 ≤3cm）。
2. **推车接近**：人推着车缓慢靠近墙，观察 `vx_max` 随间隙连续下降、0.59m 处开始限、`gap<5cm` 硬停。
3. **动态**：一人从侧面横穿车头 1m 处 → `nearest.closing_mps > 0`、`dynamic=true`、速度上限提前收紧。

### 8.4 实机参数定标（唯一需要"调"的地方）

| 参数 | 怎么定 |
|---|---|
| `v_at_spd_max` | 直行 5m 计时（§2.3-3） |
| `sensor_x/y`、`pillars_xy` | 装好后量尺；用 `mask_deg` 自证（空场扫描无假障碍） |
| `t_react_s` | 台架：从"障碍出现"到"车开始减速"的实测时延（用黑匣子时间戳） |
| `a_brake` | 舒适度 vs 保守度的旋钮：先 0.4（软），稳了再 0.6 |
| `legs_width_m/range_m` | 站人实测：正对/侧身/蹲下三种姿态的宽度分布 |

---

## 9. 已知局限与明确不做

- **不做规划**：没有 A*、没有代价地图、不做"绕到目的地"（那是 V3 局部世界 + `sector_score` 的事）。
  本文只做"约束 + 提示"。
- **不做语义**：不判断"这是主人还是路人"（相机/BLE 的事）；只给 `person_legs` 与几何事实。
- **不做 SLAM/建图**：雷达原始帧用 `--record` 落盘供 PC 科研轨离线用，机器人在线**不依赖地图**。
- **单线平面原理性局限**：只切 13.5cm 一层，见 §2.2；这是"廉价方案换来的边界"，写进能力清单而不是藏起来。
- **仿真不能演示麦轮横移**：V1 仿真底盘是差速的，`escape` 只能观测；V2a 麦轮落地后补一个横移绕行场景。

---

## 附 A：参数全表（`configs/lidar_guard.json`，均为默认值）

| 组 | 参数 | 默认 | 说明 |
|---|---|---|---|
| 几何 | `body_half_w / _l` | 0.15 / 0.17 | 30×34cm 占地 |
| | `sensor_x/y`、`sensor_yaw_deg` | 0/0/0 | 待实测 |
| | `pillars_xy`、`pillar_r_m`、`mask_margin_deg` | 4 柱 / 3mm / 2° | 遮罩自动生成 |
| | `range_min_m / range_max_m` | 0.24 / 8.0 | 近场自反射 / 实用量程 |
| 去噪 | `dedup_deg`、`spike_keep_m`、`spike_dense_n`、`min_points_ok` | 0.5°/1.2/100/20 | §4.1、§4.7 |
| 制动 | `t_react_s`、`a_brake`、`gap_margin_m` | 0.35 / 0.6 / 0.08 | §4.3 |
| | `v_nom_mps`、`v_min_mps`、`hard_gap_m`、`corridor_extra_m` | 0.6 / 0.15 / 0.05 / 0.05 | 巡航上限/无效速度/硬停/走廊余量 |
| 转向 | `wz_max_dps / wz_min_dps`、`rot_gap_full_m / _zero_m` | 90 / 5 / 0.20 / 0.05 | §4.2 |
| 迟滞 | `block_confirm_s / clear_confirm_s / resume_margin_m` | 0.25 / 0.40 / 0.15 | §4.5 |
| 降级 | `stale_timeout_s`、`degrade_speed_mps` | 0.6 / 0.30 | §3.2 |
| 行人 | `cluster_gap_deg`、`legs_width_m`、`legs_range_m`、`dynamic_mps` | 6°/(0.05,0.45)/(0.3,5.0)/0.15 | §4.4 |
| 单位 | `spd_max / v_at_spd_max`、`mec_v_units / mec_w_units` | 255 / 1.0 / 100 / 0.01745 | 线上协议 ↔ SI（§5.3） |
| 语义 | `move_lr_is_rotation` | true | `MOVE L/R` = 原地转(V1) / 真横移(V2 麦轮可置 false) |

## 附 A2：本次（2026-10-16）顺手修掉的两个 bug + 一条工程改进

| # | 位置 | 现象 | 影响 | 处理 |
|---|---|---|---|---|
| 1 | 仿真 `_ray_aabb_t` → 改 `_ray_dist_m` | 该函数返回的距离单位已是**米**，但两个调用方又乘了段长 → 距离被放大（声呐 2×），且 `tmax≤1` 把 **1m 之外的回波判成"无交"** | **安全相关**：虚拟声呐阈值 20cm 因此等价于"真机 10cm 才停"，仿真比实机宽松；且 1–2m 的墙读成"畅通" | 已修正为直接返回米并受 `seg_len` 约束；修正后基线仍 PASS（在原始 HEAD 副本上单独验证过） |
| 2 | `apply_to_ascii` 的 `MOVE L/R` | 转向包络 = 0（`rot_gap` 太小、但迟滞确认窗还没走完）时落进了"放行"分支 | 确认窗内整车仍按原速**转向**——实测让车多转了 0.32 rad、把"禁转"演示冲淡 | 补 `cap <= 0 → STOP`（T12m 断言） |
| 3 | 仿真黑匣子 | 多人/多会话同时跑同一个 world → 同一个 `sim_session.jsonl` 被两个进程交错写 → JSON 行截断、报告解析崩 | 并行跑不可用 | 新增 `SIM_LOG=<路径>`（各自指定）；`analyze_robustness.py` 跳过截断行 |

## 附 B：硬件到手后的待办（按顺序）

1. [ ] YDLidar-SDK 在 aarch64 编译（PC 编好 sftp 推板）→ 写 `lidar_scan.json` 的**扫描桥**（~60 行）
   > 2026-10-24：扫描桥的**路线 2（ROS）版**已入仓并在 PC 实测（`world/fusion/ros_scan_bridge.py`，附 D）。
   > 路线 1 的 SDK 直连仍待板子；两路线产出同一契约文件，可互换，guard/daemon/rk_control 零改动。
2. [ ] daemon 上 systemd 单元（照 `imu.service` 模式）+ 健康检查（`/safety` 的 `mode/scan_age_s`）
3. [ ] §2.3 装车验收 3 条 + §8.4 参数定标 → 更新 `configs/lidar_guard.json`
4. [ ] §8.3 上车三步；把实机数据回填本文（把"待实测"改成实测值）
5. [ ] `--record` 开一天扫楼，落盘交 PC 科研轨（为 V2b 的 SLAM 沙盒备料）
6. [ ] （V2b 后半）雷达 → grid.json 第四源 `lidar`（[世界] L1，接口见 §5.4）
7. [ ] （可选，V3）固件级 `LIMIT` 通道：让 S3 也能消费限速（雷达只连 RK，需新增遥测）

## 附 C：与 §14 暗光阶梯的接线

§14.2 的 L2（相机不可信）要求"毫米波在场 + 激光/超声安全"。本设计提供的就是那个"激光安全"格：
`mode=ok && n_points≥20` 时，避障在**无光照条件**下照常工作（雷达不受光照影响），
L2 的"慢速跟走"因此有了硬约束来源。切换质量实验（§14.5）可直接用本文的 `mode/ok` 作为传感器可用性输入。

---

## 附 D：2026-10-24 PC 科研轨首测回填（X3Pro 实机 + 路线 2 桥）

X3Pro 到手，先在 PC 科研轨（t2linux MacBookPro + Ubuntu 24.04 + ROS 2 Jazzy，`ros-jazzy-desktop`
+ `slam_toolbox` 已装）上把整条管线用真实数据跑通。机器人端（RK）一行未动——§3 三段解耦的收益兑现。

### D-1 实测一手数据（ROS 驱动 `x3pro_lidar` 节点，/dev/ttyUSB0 CP2102）

| 项 | 实测 | 与本文预设对照 |
|---|---|---|
| 帧率 | **10.0Hz**（帧间时间戳 0.100s 稳定） | ✅ 与 §1 时延链"扫描 10Hz"一致 |
| 每帧点数 | 原始 ~233，**有效 ~80-100** | ⚠️ §5.4 示例的 412 是降转速后的量级，10Hz 踩不到 |
| 飞点滤波生效性 | `spike_dense_n=100`：真实帧多数 <100 点 → 走**稀疏帧路径，飞点剔除大部分时间不生效** | ⚠️ 新发现（§4.1） |
| 量程 | range_max 8.0m；室内有效回波 0.10-4.3m | ✅ 与 `range_max_m=8.0` 一致 |
| 无效点形式 | `inf` + 0.000x 毫米级噪点 | 桥里已滤（guard 近场滤波是第二道） |
| 角度约定 | ROS 左为正（CCW）→ 桥取负 → 契约右为正 | ✅ 与 §1 / test_bearing_convention 同源 |
| TF | 驱动发布 `base_link→laser`（tf_static） | 对 guard 无关；SLAM 科研轨直接可用 |

### D-2 端到端验证（真实房间数据）

- 桥 → `lidar_guard_daemon` → `lidar_safety.json` 全链路通：`mode=ok`、~80 点、最近障碍方位/距离、
  四向间隙、24 扇区、`person_legs`（桌面杂物按 5-45cm 宽度判为腿级——桌上跑的真实表现，上车即真腿）
- stale 注入：帧停更 20.6s → `mode=stale, ok=False` ✅
- 回归：`test_lidar_guard.py` **58 passed, 0 failed**（新增 T11c/T11d 双时钟断言），
  `test_bearing_convention.py` 9 passed（其关于 `rk_control.owner_bearing` 左右正混用的结论仍开放）

### D-3 本次修掉的问题

| # | 问题 | 处理 |
|---|---|---|
| 1 | §5.1 旧示例 `ts` 为 epoch → epoch 帧 `scan_age` 恒 None，**stale 静默失效** | guard 双时钟兼容（epoch 与墙钟对齐判龄，超前墙钟不判）+ §5.1 改 monotonic + T11c/T11d |
| 2 | `--record` 默认 2Hz 只够 guard 回放调参，**SLAM 科研轨需要全速率** | 定位收窄：`--record` 只服务 guard 调参；SLAM 备料走 rosbag2（10Hz LaserScan） |

### D-4 上板前要做的决策（不阻塞装车）

- **点密度旋钮**：X3Pro 采样率 ~3K/s 固定，10Hz → ~300 点/圈，`person_legs` 每条腿只分到 3-6 点，
  宽度分类方差大（直接影响 follow 升级 §1 的输入质量）。扫描频率降到 6-7Hz → ~450-500 点/圈，
  对齐本文示例量级；代价是动态场景帧更新变慢。**装车实测后取舍**，配置在驱动侧，不在 guard。
- **生产者载体**：路线 2（ROS）已验证可用；板上走路线 1（SDK 直连）还是装 ROS 2 Humble 走路线 2，
  等 KickPi 系统镜像确认后定。倾向 SDK 直连——板上内存/CPU 紧，省 1-2GB ROS 依赖与 DDS 常驻开销。
