cchengoran525/Shadow-Carrier/docs/DEFERRED_WORK.md

# 封存工作清单 —— 雷达 & 主动分离（V2/V3 再做）

> 写于 2026-10-11。目的：把"**雷达**"与"**主动分离**"两个深水讨论**总结并隔离**，
> 不让它们污染 demo（10 月中冻结）；但结论要**存住**，并写清**解封条件**。
>
> 关联：`docs/RESEARCH_POSITIONING.md`（研究定位）、`docs/PRESENCE_MANAGEMENT_SURVEY.md`（在场管理调研）、
> `docs/V2_CHASSIS_GIMBAL_DESIGN.md`（§13 雷达×HIDE、§14 暗光/传感器分工、§5.4 云台解耦）。

---

## 0. 为什么隔离

- **demo（V1）硬节点在前**：10 月中功能冻结、10 月底展示。主动分离与雷达是 **V2/V3 的研究平台议题**，不是 demo 前置。
- 但一轮深水讨论已经发生（RESEARCH_POSITIONING + PRESENCE_MANAGEMENT_SURVEY + 各线表态）——**成果要存，工作要停**。
- 隔离原则：**demo 期只保留"能出定量证据的一件"**，其余全部封存。

---

## 1. 主动分离（Presence Management / Intentional Decoupling）

### 1.1 已形成的共识（存住）
- **母题**：从"跟人"上移到"**读世界 → 管理在场**"；FOLLOW/APPROACH/YIELD/HIDE/SEPARATE = 五种在场决策。
- **三拍**：`Pre 何时分 → During 去哪等/怎么在 → After 何时如何回`（τ/π/ρ）。
- **两型**：停等型（Stationary Yield）/ 绕行型（Parallel Traversal）。
- **负向策略/问题重述**：不解决"穿人群"，只解决"何时分、去哪等、如何回"。
- **形式化**：Intentional Decoupling；安全优先（硬约束）+ 信念驱动重捕获。
- 全部细节见 `docs/RESEARCH_POSITIONING.md` + `docs/PRESENCE_MANAGEMENT_SURVEY.md`。

### 1.2 各线表态（2026-10-11）
| 线 | 立场 | 要点 |
|---|---|---|
| [HRI] | **Pre 触发归我** | 修正："Pre v0（busy 版）**已上线**"（WAIT→HIDE→GOTO_SAFE），非"未实现"；主张 Pre=**两轴预测 + 可逆**（时间轴/空间社会轴 + 迟滞/abort/冷却） |
| [世界] | **During 归我** | 主动分离把世界模型提到**主脊**；判断 **"成败在 Pre 与 During，After 最轻"**；Pre 最易变伪需求（需可控人流场景） |
| [认主] | **认领 After，纠正"After 最轻"** | After 是规格变化（身份重建，非持续轨迹）；机主原则 L2 下重逢不自愈=产品级缺陷；提 3 条能力提案 + 3 个可验收指标 |
| [云台] | **V2 交付** | §5.4 平移-指向-航向三级解耦；立场：云台最终必须能自由运动（冻结只是 demo 权宜） |

### 1.3 隔离决定
| 项 | demo 期（现在） | 封存到 |
|---|---|---|
| **Pre 触发 v0（busy 版）** | **保留**（已上线，不新增） | — |
| Pre 人群/风险版 | ❌ | **V2/V3** |
| During 选点（sector_score v2） | **保留唯一可出定量证据的一件**：走廊实测 | — |
| 绕行型（侧向偏移跟随） | ❌ | **V2（需麦轮横移）** |
| 信念驱动重逢 / 隐式契约用户研究 | ❌ | **V3 / Phase C** |
| After 能力提案（多帧投票/画廊/重建卡） | ❌（需机主拍板） | **Phase C** |

---

## 1.4 主人离开视野：短时遮挡与持续失联分层

两类问题都表现为“相机暂时看不到主人”，但时间尺度、可用证据和安全动作不同。**短时缺失是视觉跟踪与重捕获问题；持续失联/主动分离是等待、定位与重逢问题。手机/手环在场信号不适合弥补短时视觉缺失。**

| 情况 | 典型原因 | 首要目标 | 主要信息源 |
|---|---|---|---|
| **短时视觉缺失**（数帧到短暂遮挡） | 检测抖动、路人擦身、主人被短暂挡住或贴边出画 | 不换错人、不因单帧丢检产生急促动作；尽快认回同一人 | 最近视觉轨迹、外观模板、相机/云台方向、短期运动预测 |
| **持续失联 / 主动分离** | 主人绕过墙角、离开相机视野较久、按 HIDE/SEPARATE 约定分开 | 停在安全且找得到的位置；在有定位和地图时才规划重逢 | 最后观测、机器人定位与地图；手机/手环在场或位置提示 |

### A. 短时视觉缺失：桥接检测中断，不做盲目追人

**当前实现**
- `owner_id.py` 用 HSV 外观模板、框位置和 α-β 预测关联重新出现的候选；预测主要帮助认回同一目标，候选缺失时仍返回无主人，不以预测位置授权底盘前进。
- 非连续候选需要连续 3 帧确认；与主人出画侧相反的候选需要 5 帧确认，减少擦身时锁到路人的风险。
- 丢失前 0.4 秒不触发后退；之后现有主流程会短暂后退（最长约 1.2 秒），连续丢失 2.4 秒后才明确进入停车等待/丢失停止。
- 另有基于出画方向的 BLIND/SEARCH 转向、腿带弱线索和受限扫描设计。**2026-10-20 起 `TURN_ENABLED=True`（T4 待验）；本节其余为 10-11 快照**。腿带线索只帮助维持转向，不确认主人身份，也不授权前进（腿跟 A 为例外，需显式开启且默认关）。

**设计原则**
- 短暂掉框首先保持身份连续性和方向估计；对短时预测设置很短的有效窗，置信度随时间下降。
- 预测用于候选匹配和估计短时重现位置；若后续接入云台自主搜索，可辅助指向，但不能单独授权向前移动。若要短时保持底盘运动，必须同时满足低速、前方安全证据和严格时间上限；否则停车等待重捕获。
- 重捕获需同时通过外观、位置/运动连续性和多帧确认；候选冲突时宁可停一下，也不换主人。
- 短时遮挡不读取手机 GPS；BLE/热点在场状态时间尺度太慢，且没有角度信息。

### B. 持续失联 / 主动分离：安全等待，再决定是否重逢

**当前实现**
- 手机热点路径用已登记的手机 MAC、邻居表和 ping 判断手机是否在网络上可达；手环路径扫描固定 BLE MAC，约每 40 秒扫一轮，并以最近 60 秒内见过作为“在场”。两者最终只合成 `owner_nearby()` 布尔值，不提供距离、方向或坐标。
- 跟随器连续丢失 2.4 秒后会停车；主人模板存在且热点/手环信号新鲜时标为 `wait_owner`，否则为 `lost_stop`。无线信号不会直接驱动车辆搜索。
- 主动分离已有 HIDE/WAIT 的停等思路；“信念驱动重逢”仍属于 V3 / Phase C 工作。

**V2：把 App 做成可选的失联辅助通道**
- 复用热点或 BLE 作为本地连接，增加明确的数据类型：设备心跳、最后更新时间、用户召回/确认动作，以及可选的主人位置提示。
- 位置提示至少携带坐标系、时间戳、误差范围、来源和设备标识；过期或误差过大时只作为“可能仍在附近”的线索。
- App 数据用于决定等待、提示主人或前往已知会合点；必须与 SC 自身定位和可通行地图配合，不直接转成电机指令。

**V3：实现有边界的信念驱动重逢**
- 在共同世界坐标系内融合最后视觉观测、里程计/IMU、环境地图，以及可用的手机定位或近距测距，维护主人可能位置及不确定范围。
- 仅在高置信度、可通行的范围内做有限搜索；不确定性扩大、通信失效或路线不安全时停车并等待用户重连。
- 到达后仍需视觉身份确认，多帧确认后才能恢复 FOLLOW。

**日常使用边界**
- 不额外携带专用标签的目标，可以由用户已有手机提供可选位置提示，SC 自身承担定位、地图与安全规划；近距离无线测距可作为兼容设备上的增强能力。
- 这依赖用户完成一次配对并授予 App 所需权限；手机未带在身上、App 被系统限制或位置不可用时，系统仍应安全停车等待。日常手机是辅助定位源，不能取代短时视觉跟踪，也不构成“任何情况下都能找回”的保证。

---

## 2. 雷达（YDLIDAR X3 Pro）

### 2.1 已形成的共识（存住）
- 雷达对 **demo 零贡献**（HIDE 用相机 B1 找门已交付）；真价值在建图/重定位（L2/L3）。
- **新论据（[世界] 10-11）**：`During` 的"**找得到**"本质是**可见性（visibility）**——主人回望能否看到车；**相机-only 算不了**，正是 §13 的可见性遮挡分析 → 雷达从"几何升级"升级为"**等待点质量的可测量前提**"。
- 接口红线（已定）：雷达作 `geometry_daemon` 第四源 `lidar`，**grid.json 消费方零改动**、**相机-only 仍能完整出图**。

### 2.2 隔离决定
| 项 | demo 期 | 封存到 |
|---|---|---|
| 相机-only 出图 | **保留（保底红线）** | — |
| 雷达"只买不集成" | **保留**（不集成） | — |
| 雷达**避障逻辑**（约束层：限速/停车/绕行提示） | ✅ **已提前备好**（代码+测试+仿真夹具+文档，无硬件即可跑；`docs/V2_LIDAR_AVOIDANCE.md`），但**不接线**（惰性契约：daemon 不跑=不存在） | 直接进 **V2b** |
| 雷达物理集成 + **L1 daemon**（局部几何：free / 腿级人 / 可见性） | ❌ | **V2** |
| 扫描匹配建图 / **SLAM** / 重定位 | ❌ | **移出机器人范围 → PC 科研轨**（离线、无云，吃车上日志） |

---

## 3. 同批封存的 V2 议题（并行讨论，一并存）

| 议题 | 出处 | demo 期 | 封存到 |
|---|---|---|---|
| 暗光降级阶梯 + 传感器分工（`mode`/`sensors` 字段） | V2 §14 | 只需"白天+动线"预案 | **V2** |
| 云台三级解耦（平移-指向-航向） | V2 §5.4 | 云台冻结 | **V2** |
| 相机-雷达互补受控实验 | V2 §0 / 学期计划 C7 | ❌ | **Phase C** |
| 主动分离的 RQ-τ/π/ρ 研究 | RESEARCH_POSITIONING | ❌ | **Phase C** |
| **V1 近距安全余量收口**（制动模型推导 `NEAR_STOP_M` + 载重启动阈值标定 `--stall`） | 2026-10-19 审查：`BASE_SPD` 130→220 后制动距离 ≈0.4→0.9m，偏轴 11–30° 且 <1.6m 时无停车判据 | **不做**（机主裁定：V1 只要求能动起来；已有速度门 + 正前框高门兜底） | **V2**（编码器闭环能量测速/防滑 + 雷达 `range_m` 覆盖 <1.6m 后才谈余量） |
| **无 UWB 的合作相对定位 + 无地图导航**（手机共享定位：分离点=共同原点，两段位移相减 → 相对目标 `(bearing,range)` → Bug2 绕行 / 弱地图 A* → 进视野即重锁） | 机主原始设想（2026-10-19）＋ `docs/V2_PHONE_RELATIVE_NAV.md`（锁人/世界两线拆分、接口、精度包络、验收） | ❌（demo 期不做；不建图、不做绝对定位、不给用户发 tag） | **V2**（V2a 相对估计+Bug2 纯函数离线 → V2b 手机网页被动上报 → V2c 间歇视觉修正 → V2d 弱地图 A*） |

> ⚠️ **撤回一条不可行的建议（2026-10-19）**：此前写过"让主人 ≥2m 外侧绕过"作为兜底 ——
> **现场做不到**：2.5m 走廊里墙就在机器人两侧 ±1.25m，宿舍更窄；"2.5m"是**纵向跟车距**
> （`FOLLOW_KEEP_MIN_M`），不是横向余量。真实 passby 的横向距离是 **0.8–1.5m**：
> 这个距离上"头不入画"（头在 1.66m 需 ≥2.07m 才进画面）但躯干仍可见；**腿-only 约在 <0.8m**
> 才发生。所以 passby 靠**机制扛**（转向通道保画面 + 弱线索接管腿段），不靠编排让路。

> **2026-10-19 机主裁定原话（存档）**："V1 我觉得能动起来就行了，V2 那个电机什么的才有点安全需求。"
> 因此 V1 期**不再改** `BASE_SPD`/`NEAR_STOP_M`、不跑启动阈值标定；`pivot_calib` 只保留四项
> （PWM→°/s、弧线差速、`v_at_spd_max`、IMU/θ 符号）。上面那行随 V2 一起解封。
>
> ⚠️ **2026-10-21 机主新裁决（覆盖上条的速度部分）**：车体加重后"基础力矩/速度不够"，
> 批准**重载档**：`BASE_SPD 220→245`、`MIN_SPD 120→155`、`PIVOT_PWM 190→240`、
> `MANUAL_FWD_SPD 240→255`（弧线/HRI 动作速度同步上调）。**`NEAR_STOP_M` 不动**；
> 现场用 `/test` ⑦ `/motion/config` 继续微调（立即生效、持久化 `~/hri_logs/motion_tune.json`）。
> 该重载档已上板并用于 T2/T4 实测（2026-10-21）。

---

## 4. demo 期"只做能出定量证据的一件"

- **世界（During）**：走廊实测——`sector_score v2` 的 `confident` 覆盖率 + 选中点是否"靠墙且离门锥"，最小验收=**连续 3 次 HIDE 落点正确**。
- **HRI（Pre v0）**：口径修订为"Pre v0（busy 版）已上线"；`hri_state` 把 Pre 触发**显式策略化**（trigger families: busy/affinity/crowd，各带开关+阈值，日志记 `trigger_reason`）；仿真加**分离事件标注** → 出"触发延迟/误退率"表（R7 数据集雏形）。
- **其余一切**：封存，不动。

---

## 5. 解封检查清单（到期逐条确认）
1. [ ] V1 demo 已收官（10 月底）+ 展示/套磁完成
2. [ ] V2 硬件（S3 + 编码器 + 电源 + 相机）到位
3. [ ] 雷达 X3 Pro 到手并验机（YDLidar-SDK aarch64 编译）
4. [ ] 机主对 After 能力提案拍板
5. [ ] Phase C 科研轨正式启动（选主脊 A1→B3→C1）

> 满足 1+2 即可启动 **V2 雷达 L1 + 主动分离绕行型**；满足 1+5 启动 **Phase C 研究**。

---

## 3. 认主线分版表 (V1 / V2 / V3, 2026-10-22 定稿)

> 依据：`docs/V2V3_ROADMAP.md` + 10-17 拆线裁决 + 10-22 腿跟裁定。
> 原则：**V1 只修 bug 不加能力**；V2 在拆线后只做"身份"（运动归 [运动控制]）；V3 才做多人/信念重逢。

### V1（demo，10 月底）—— 冻结范围

| 事项 | 状态 | 备注 |
|---|---|---|
| passby 换人确认门（3/5 帧 + margin） | ✅ 已合入 main | 非连续候选确认；反向更严；确认期不发布/不进 KF |
| `owner.json` 发布（HRI/运动消费） | ✅ 已上线 | 只发已确认的主人框 |
| 短时视觉缺失分层 | ✅ 已落地 | 0.4s 不后退 / 1.2s 后退搜索 / 2.4s wait |
| 腿跟 `LEG_FOLLOW_ENABLED`（默认关） | ✅ 原型 + 三条安全补丁 | 见下；**只有小场地 3 次验证通过才在 demo 开** |
| 实测 watcher | 🔲 | health_check + journal + owner.json 判读 |
| 速度阈值（BASE/MIN/NEAR_STOP） | ❄️ 冻结 | 10-19 裁决；10-21 重载档另记 |
| 画廊 / ReID / 信念重逢 | ❌ 不做 | V2/V3 |

**腿跟 L2 风险签核（认主）**：设计守底线（不发起/不写 owner.json/不进 KF/TTL 3s/±25°/单人门/OBS>35cm/默认关）；补三条后**有条件通过**：
1. `leg_travel` 累计里程上限 **0.6m**（死推，不只看时间）——已实现
2. **同屏只允许一个腿带候选**（`find_leg_band_info.n == 1`）——已实现
3. **腿带面积 0.6s 内增长 >35% → 拒绝**（疑似逼近）——已实现
验证：`test_leg_follow` 8/8；不通过则回 C（走廊 ≥1.5m）。

### V2（11 月 → 1 月，v2.0 release）

| 事项 | 归属 | 说明 |
|---|---|---|
| **认主加固：画廊（gallery）** | 认主 | 高置信样本带衰减入库，替代单一均值模板 |
| 多帧投票 | 认主 | **V1 已提前完成**，V2 沿用 |
| App 失联辅助通道 | 认主 + 基建 | 心跳/最后更新时间/召回 + 可选位置提示（带 ts/坐标系/误差）；只用于等待/提示/会合，不直连电机 |
| 停等型分离（单人 S-W-R 工程版） | HRI/世界主导 | 认主提供身份与 stale 语义 |
| `follow_controller` | **运动控制** | V2 起归运动控制，消费 `owner.json`；距离保持/编码器里程同归 |
| ReID | 认主（预研 only） | 只做 RKNN 预研/bench，不集成 |

### V3（2 月 → 8 月，纯固件）

| 事项 | 认主职责 | 验收 |
|---|---|---|
| 多目标跟踪 + **ReID**（≥2 人才触发） | 主责 | 人群中不丢主人、不误锁路人 |
| **信念驱动重逢（C1）** | 主责（与 HRI/世界协同） | 最后观测 + 里程/IMU + 局部地图 + 手机定位 → 有界搜索；不确定即停车等 |
| 到达后多帧身份确认再恢复 FOLLOW | 主责 | 复用确认门 |
| 重建卡（presence 门控自动重认主） | 主责（**需机主拍板**） | 在场信号 + 画面仅一人 + 多帧过线 |
| After 三项证据 | 主责 | T∈{10,30,60}s × 三来向；重获延迟 ≤2~3s；**误锁率 0 硬红线** |
| 隐式契约/等待点用户研究 | 配合 | 世界/HRI 主导 |

### 三处口径决议（原文档不一致处）

1. **画廊**：`V2V3_ROADMAP` 写 V2b，`DEFERRED_WORK` 曾整体划 V3 → **定为 V2**（零新模型、直接改善单人稳健）。
2. **ReID**：路线图仅在 V3b 出现 → **V2 只预研，不集成**。
3. **腿跟**：补丁后允许"demo 现场开关"；**任一次小场地验证不稳 → 回 C**。
