cchengoran525/Shadow-Carrier/docs/DEMO_PLAN.md

# Shadow Carrier — Demo 预案（剧本 / 风险 / 隐含能力 / 延展性）

> 写于 2026-10-06。配套 `simulation/webots/` 的走廊场景与 `run_demo.sh` 全剧本彩排（已端到端跑通，见文末验证记录）。
> 硬节点：**10 月底向世界模型 / 无人驾驶 / 人机交互三位老师 demo 套磁**。

---

## 1. Demo 剧本分镜（仿真已验证 ↔ 实机对应）

| # | 镜头 | 仿真对应 | 验证什么 | 实机注意 |
|---|---|---|---|---|
| 1 | 我走出宿舍门，车跟在身后 ~2.5-3m | P1 跟随（FOLLOW，车距保持） | 跟随闭环 + 弧线转向 | 走廊照明；起步前完成认主（ enroll 3s，主人穿鲜艳衣物） |
| 2 | 我到走廊尽头饮水机打水，车减速停在身后 | FOLLOW→WAIT（静止 5s） | 静止判停，不顶人 | 打水动作幅度别太大（弯腰会触发弯腰通道） |
| 3 | 20s 后车自己挪到**饮水机旁墙根**（离门 ~9m，不挡饮水机/冰箱正面） | WAIT→HIDE，sector_score 亲和度选点（分数 1.70，置信门控通过） | **"提前远离门"的选址 intelligence** | grid.json 由 geometry_daemon 实时产出；门/家电惩罚权重已冻结 |
| 4 | **有人推开宿舍门进来，沿走廊走过**（离车 ~1-1.5m，从镜头前穿过） | 路人节点入场，双人同框，owner.json 锁主 | **锁主不跟路人**（核心叙事）+ 遮挡穿越不丢主 | 实机夜景幻影率高 → demo 定白天；路人由同学扮演、按固定路线走 |
| 5 | 我打完水去隔壁冰箱拿东西 | 主人移动，HIDE 中 gaze 注视，不误唤醒 | 躲避期间的在场感知 | 冰箱开门动作别挡住自身 bbox |
| 6 | 我拿着东西回身递给它 | 持物+缓近 → **HIDE→RECEIVE（held=bottle:0.95）** | 意图识别 → 主动服务 | 递物物替：果冻/水瓶（C1 实测置信分布） |
| 7 | 车上前一点接住 | RECEIVE APPROACH，合拢到 ~0.3m（超声 20cm 急停兜底） | 逼近控制 + 安全急停 | APPROACH 限速；地面防滑 |
| 8 | 我转身走回宿舍，车掉头跟上，一路跟到门口 | WAIT 搜索转身 → 唤醒 → FOLLOW 回程（车距 1.7-3.5m） | 服务结束后的恢复跟随 | 掉头处留 ~1.5m 回转空间 |

**剧本总时长**：仿真 95s；实机预留 2.5-3 分钟（含认主与重启余量）。

## 1b. 分镜 仿真 vs 实机 现状对照（2026-10-08，统筹）

> 结论：**仿真 = 100%（剧本/逻辑/接口全绿）；实机 ≈ 70%；整体 ≈ 78%**。
> 仿真是**逻辑与接口彩排**（kinematic 无物理 + 几何真值合成检测），**不验证**控制动力学/感知噪声/时序抖动 —— 风险已收敛为「**sim→real 移植**」。

| # | 分镜 | 仿真 | 实机 | 缺口 / 动作 |
|---|---|:--:|:--:|---|
| 1 | 跟出宿舍门 ~2.5-3m | ✅ | 🟡 | FOLLOW 通；**无距离保持** → h 近距急停 + 主人步速（`dist_m` 增强非阻塞） |
| 2 | 打水静止停车 | ✅ | ✅ | A1.1 真机已验证 WAIT |
| 3 | HIDE 到墙根（sector_score） | ✅ | ❌ | **实机 HIDE 端到端未跑**（需 grid 实时 + GOTO_SAFE 动作） |
| 4 | 路人进门 → 锁主不跟 | ✅ | 🟡 | owner.json 已发；**双人真机验证待做**（@HRI 开 `owner.source=file`） |
| 5 | 冰箱取物（HIDE 中注视） | ✅ | 🟡 | 云台固定后注视未验（救援凝视=可选增强） |
| 6 | 持物缓近 → RECEIVE | ✅ | ✅ | A1.1 真机已验；**道具须换**（果冻不可检 → 袋/玩偶，C1） |
| 7 | 上前接住 ~0.3m | ✅ | ❌ | **A1.3 动作层真机**（APPROACH→`/move`）——**最大缺口** |
| 8 | 回程 FOLLOW（搜索转身） | ✅ | 🟡 | **2026-10-16 落地：跟随态原地转已实装**（`follow_controller` 转向通道 TURN/BLIND/SEARCH，走 `MOVE L/R` 真原地转）。待做：`scripts/pivot_calib.py` 实测 PWM→°/s + 走廊彩排。注：旧文写的"用底盘 `/turn`"不成立——`/turn` 是弧线转且仅手动模式（跟随态被 mode 门禁拒绝） |

**关键路径 = A1.3 动作层真机 → A1.4 全场景串跑**（不依赖任何硬件采购，10 月中冻结前可完成）。
**已有缓解**：电池/扭矩已修（10-07 满电能动）、camera 黑屏已修（udev 稳定符）、舵机风险降级为"可选增强"。

## 2. 实机移植清单（仿真→实机的差异项）

1. **owner.source 拨盘**：板上 `hri_params.json` 把 `owner.source` 从 `none` 拨到 `file`（A1.2 消费端已在仿真验证）。拨盘前后各跑一遍双人对抗。
2. **跟随车距**：仿真用地面真值做了 2.6/3.0m 车距保持；实机 follow_controller 是恒速推进（v3 原版"距离由人自行掌握"）。
   - ⚠️ **统筹裁定（10-08）**：**h 只能做"近距急停兜底"**（bbox 高度 > 阈值 → STOP/后退），**不能当测距环** —— 08-24/10-03 已两次证伪 bbox 高度测距（半身/腿部失真、近距饱和）。
   - **距离源优先级**：`[世界] dist_m`（112 角生产标定 ≤2%）> `tracker r`（云台 M2）> `h` 兜底。
   - demo 层面**不要求精确保持 2.5m**：加 h 急停 + 主人自控步速（剧本回程本就容许 1.7–3.5m）即可；`dist_m` 做单向"太近→减速"是增强、非阻塞（等 @世界 确认 FOLLOW 期 dist_m 可得性与频率）。
   - 这是实机侧唯一建议的代码改动（A2 前）。
3. **HIDE 选点**：实机由滚动地图的 free_sectors 驱动 sector_score；走廊场景需确认 geometry_daemon 在走廊里能稳定产出门/自由扇区（CALIBRATION.md 流程跑一遍）。
4. **救援凝视 / 搜索转身**：⚠️ **统筹裁定（10-08）：demo 默认不依赖云台运动** —— 舵机受损、换舵机延后到 demo 后，把 demo 正确性押在坏舵机上风险过高。实机对应改为：
   - **云台固定居中（默认）**；救援式凝视（W1）标为**可选增强**（仅当新舵机/demo 前舵机健康时开启）。
   - §1 分镜的"搜索转身"用**底盘原地转**替代（`/turn` 已就绪，IMU 闭环）。
   - 动线要求：主人主要在车前方（走廊直线），避免大幅横向出 FOV。
   - **验收动作**：Webots 跑一遍"云台冻结"版剧本，确认 8 分镜仍通过。
5. **IMU 航向保持**：走廊长直道是 IMU 航向环的用武之地（imu_daemon 已部署），demo 前验证直线 5m 偏差 <0.3m。

## 3. 风险清单与解决方向

| # | 风险 | 概率 | 现场对策 | 根治方向（回去做） |
|---|---|---|---|---|
| 1 | 夜景/逆光幻影 person，车追路人 | 高（历史数据 95/98 帧含幻影） | **demo 定白天+固定动线**；彩排一遍同机位；**暗光降级模式（L1/L2）**见 V2 §14 | ReID 替换 HSV（方向池 C1，~1 周）；低照度相机+IR 补光（V2 §10.4） |
| 2 | 路人入镜瞬间误锁 | 中 | owner.json 锁 + 2 帧确认已双层防护；路人与主人保持 >1.5m | UWB 测距（C5，¥50）给"真实距离"硬证据 |
| 3 | 走廊逆光/玻璃门反光误检 | 中 | 提前 1 天同场地彩排；灯光可控 | HSV 模板对光照敏感 → 同上 ReID |
| 4 | HIDE 后主人出视野不恢复 | 中 | 仿真已加"WAIT 搜索转身/凝视"；实机 gaze SEARCH_TIMEOUT=4s 已有 | ṙ/θ̇ 特征接入状态机（方向池 C4） |
| 4b | **递物交接（RECEIVE）在"相机真有 ±32° 视场"后起不来**（2026-10-16 仿真发现；旧绿是无限视场假框喂出来的） | **高**（剧本原样就会踩） | ✅ **HRI 侧已修**（10-18 `0d96a1b`：HIDE 不再因主人出画中断；`c6d11b8`：RECEIVE 放行"近距站定持物"），另有 `test_hri_receive_close` 回归。**剩余**：实机停驻域链路（`/dev/shm/hri_state.json` 需 HRI 常驻 → 现在板上没有该服务，`turn_only` 在实机上仍不生效）；与"近距 off-axis 安全"（10-19 速度门 + 地面测距已兜底；余量精调按机主裁定封存到 V2） | 递物段固定站位标记；彩排验收"停驻转头接人" |
| 5 | C3 冷启动不枚举（老毛病） | 高（历史） | 冷启动检查单见 `FIELD_TRIAL_PLAYBOOK.md` §4（原 `RECOVERY.md` 从未存在，已由该文档取代）+ 热备 C3 | USB watchdog 已上线（replug-free） |
| 6 | 打水弯腰误触发弯腰通道 | 中 | 台词"我去打个水"；递物物替用 C1 高置信物 | 弯腰施密特去抖+冷却已有；med 采集真实弯腰数据 |
| 7 | 长直道走歪撞墙 | 中 | IMU 航向环（IMU-gated /turn 已上线） | MPU6050 航向环参数在走廊实测标定 |
| 8 | 演示当天翻车 | — | **降级预案**：手动模式走完剧本 + 视频兜底 + 热备 C3 | — |

## 4. 视频能展现、但台词不会明说的能力

1. **0.8TOPS 上的多模型调度**：YOLO 快环 11fps + YOLO-World 开放词汇慢环 + 几何环三线同跑——画面只有"车躲到了墙根"，背后是 NPU 上三个模型的实时预算分配。
2. **标定链的精度兜底**：车停的位置"恰好"离门 9m、离饮水机 1m——背后是内参三方互证（fx=508, 方位角误差 0.08°）+ PnP 极坐标（距离误差中位 3.23%）。
3. **跨进程契约工程**：owner.json / grid.json / 串口协议四条冻结接口让四条线互不踩——视频里看不到，代码仓库门面（README+架构图）能看到。
4. **A/B 实验方法论**：救援式凝视 vs 持续追踪的对照实验（四条扰动通道归因）——面试/套磁里最稀缺的"负结果+归因+重构"素材。
5. **黑匣子全程留痕**：demo 视频同步配一张"状态转移时间轴图"（jsonl → 时间轴），把 95s 剧本变成一张可讲解的系统图——这是给老师看的第二材料。
6. **仿真-实机同构验证**：Webots 里同一套状态机/协议先跑通再上板——展示工程判断力（"什么时候该用仿真"）。

## 5. 作品延展性（demo 之后的三个方向）

- **作品集轨**：本 demo 直接产出 5 个面试故事——NPU 边缘管线调优（0.8→11fps）、单目极坐标世界快照（PnP 3.23%）、救援式凝视 A/B、锁主三层防御、HRI 黑匣子闭环。每个故事配 STAR 卡片。
- **科研轨**：走向"真世界模型"的第一步=路径记忆拓扑图（demo 动线存为节点+边，重访先验）——走廊场景天然是拓扑演示场；切口二（社交信号主动服务）的黑匣子数据从本 demo 开始持续采集。
- **专利/产品轨**：①"多信号融合用户锁定与跟随方法"（机主原则 L0-L3 即权利要求层级）；②"云台-底盘级联视野保持方法"（A/B 数据=创造性论据）；产品化试水=防丢跟随模块（购物车/行李箱），demo 视频发 B 站/小红书做零成本需求调研。

---

## 附：仿真验证记录（2026-10-06，run_demo.sh 端到端）

```
27.8  FOLLOW→WAIT   主人静止5s（打水）
48.2  WAIT→HIDE     安全点=45.0°(sector_score:1.70) → 车挪到饮水机旁墙根(离门~9m)
58.5  路人进门穿过   双人同框，锁主保持（锁定距离=主人，非更近的路人）
69.2  HIDE→RECEIVE  持物靠近 bottle:0.95 → 车上前合拢至 ~0.33m
76.2  RECEIVE→WAIT  交接完成
78.3  WAIT→FOLLOW   主人恢复移动（搜索转身+侧身唤醒）
91.5  主人到宿舍门口  车跟至身后 ~2.5m 静止等候
```

配套离线单测：owner.json 新鲜/过期/不匹配三路消费行为 + sector_scores 置信门控与门回退，全部通过。
