cchengoran525/Shadow-Carrier/docs/PACKAGING_PLAN.md

# Shadow Carrier — 三轨成果包装方案（作品集 / 科研 / 专利产品）

> 写于 2026-10-08。目的：把**同一个仓库、同一批实测数据、同一套 demo 物料**，分别包装成作品集、科研、专利产品三条轨道的可交付物，实现"一鱼多吃"、边际成本递减。
>
> 与既有文档的关系：是 `docs/REVIEW_AND_SEMESTER_PLAN.md` 第三部分（三轨初稿）的**展开与定稿**；科研轨主线严格对齐 `docs/RESEARCH_POSITIONING.md` 的"主动分离 / 四条可验收证据"；演示物料沿用 `docs/DEMO_PLAN.md`；产品/寒招沿用 `docs/V2_CHASSIS_GIMBAL_DESIGN.md §12/§13`。
>
> **本文只做包装 / 叙事 / 物料规划，不含技术开发。** 凡是需要写代码或做实验才能兑现的，都明确标为"扩展/设想"。

---

## 0. 总原则

1. **一鱼多吃**：三轨共用同一套底层资产，三轨的动作里凡标 `[复用]` 者不产生新工作量，只做重新叙事/排版；标 `[少量新增]` 者控制在数小时~数天；只有扩展清单才可能引入成规模工作。
2. **优先级 = 科研 > 专利 > 作品集**（沿用 REVIEW §3；按升学/套磁收益排序）。冲突时高优先级先占资源；但**共同前置（10 月底 demo / 一页纸 / 视频 / README 门面）三轨共用，必须先做**，它不属于任何单轨。
3. **诚实标注体系**：全文每个资产/交付物贴三级标签，凡未标注的"能做到"一律视为不存在。
   - `✅ 已实现`：真机/板上可复现，有实测或数据。
   - `🔧 半成品`：代码/仿真就绪，实机未验，或仅单点通过、全链路未串。
   - `💭 设想`：仅设计稿 / 占位 / 路线图，无实现。
4. **不营销**：报"问题重述 + 已有零件 + 明确缺口"，不报"已经能做主动分离"。仿真结果一律标注"仿真 = 逻辑/接口验证，不等于实机"。
5. **节点对齐**：10 月底 demo + 套磁（硬节点）；寒假寒招；"大四前"做出真正的搭子。

### 0.1 总时间轴

```text
2026-10 底 ────► 11 月 ────────► 12 月–1 月 ─────► 寒假 ─────► 春季学期 ────► 大四前
demo + 套磁      软著/专利/切口    技术报告/论文     寒招          Phase C 深化     真搭子 / 毕设
（硬节点）        + 博客起步        + 博客成稿        （单列）      （V2 + 证据）     （长期）
```

---

## 1. 资产盘点 × 三轨映射

> 读法：`现值` 用三级标签；`服务轨` 为 作/研/专；`复用方式` 给出"这条资产在每轨各讲成什么"。

| # | 资产 | 现值 | 一句话现状 | 服务轨 | 复用方式（一鱼多吃） |
|---|---|:--:|---|---|---|
| 1 | 仓库 / 代码 / 四线 README | ✅ | 全量代码 + 各线 README 入仓；`EXCHANGE.md` 是本地协调文件不入 git | 作/研/专 | 作品集门面；科研复现包；软著源码材料；专利实施例来源 |
| 2 | YOLO 边缘管线 v7.2 | ✅ | 0.8→11.3fps，C++ daemon + 背压 + watchdog 自愈 | 作/研/专 | 面试故事 A；科研"边缘部署"一节；软著模块 1 |
| 3 | 认主锁主 v0 + 机主原则 L0–L3 | ✅ | 实测通过；双人同色对抗待验 | 作/研/专 | 面试故事 D；专利 1（L0–L3 = 权利要求层级）；科研"先决条件" |
| 4 | HRI 状态机 + 黑匣子 jsonl | 🔧 | A1.1 真机通过；A1.3 动作层/全场景串跑未做 | 研/作 | 科研**分离事件数据集**（核心）；作品集故事 E；软著模块 3 |
| 5 | 救援式凝视 A/B（vs 持续追踪） | ✅ | 实机 A/B，定位四条扰动通道后重构 | 研/作/专 | 科研**负结果实证**一节；作品集故事 C；专利 2 创造性论据 |
| 6 | pose offering A/B | ✅ | 零误报成立 / 稳定召回不成立（单目 2D 无深度，非调参可解） | 研/作 | 科研"信号边界分析"一节；诚实自评；作品集"负结果+归因"故事 |
| 7 | 标定链 | ✅ | fx=508.2 三方互证；方位角 0.08°；PnP 3.23%；生产测距 ≤2%；门检测 3/3 零误报 | 作/研/专 | 作品集故事 B；科研"度量可信"证据；专利 3 |
| 8 | grid.json v1 + sector_score + 滚动地图 + YOLO-World 慢环 | 🔧 | 接口已交付、消费端已接；HIDE 实机端到端未跑 | 研/作/专 | 科研"During 等待点"载体；作品集故事 B；专利 4 实施例 |
| 9 | Webots 仿真 | ✅ | 8 分镜端到端跑通，复用真状态机/sector_score/owner.json；**只验逻辑/接口，不验动力学/噪声** | 研/作 | 科研"sim→real 方法学"；作品集"什么时候该用仿真"；风险兜底 |
| 10 | 相机-雷达互补实验设计 | 💭/✅ | 设计定稿（V2 §0）；硬件未购；**夜景失败数据集（95/98 帧幻影）现成** | 研 | "分离感知的前置条件"；无人驾驶/世界模型方向；受控实验 |
| 11 | safety 设计 | ✅/💭 | V1 已验证逻辑（超声 20cm 急停、固件 450ms 超时、舵机限位 15–165°+斜坡、STBY）；V2 三路隔离供电为设计 | 专/作 | 专利实施例；作品集"工程判断"；产品合规（过安检） |
| 12 | IMU 航向保持 + `/turn` | 🔧 | MPU6500@I2C3 50Hz，直行闭环上线；`/turn` 真机验证等电池 | 作/研 | 作品集"治走歪"；科研"主动重逢"的转向基础 |
| 13 | 文献雷达 8 篇 + AFFINITY 文献地图 | ✅ | Follow-Bench/SDA/EscortE/… + social costmap 文献地基 | 研 | related work 现成；套磁讲"我读过谁" |
| 14 | V2 CAD / BOM / 选型调研 | 💭 | 首版布局模型 + 硬件定案 | 专 | 产品/寒招硬件叙事；科研实验平台 |
| 15 | 相机内参标定 / tracker 极坐标 CV-KF | 🔧 | 解码 0.08°；tracker 含自测、待接时间戳 | 研/作 | 支撑证据 1/3 的空间感知底座 |

**盘点结论**：手上"真金"是 **#2/#3/#5/#7/#9/#13（已实现且可量化）** 与 **#4（半成品但数据结构最值钱）**；需要警惕的是 **#8 HIDE 实机未跑、#10 硬件未购、科研四条证据全在 `💭`**。包装不得越过这条线。

---

## 2. 三轨总览

| 轨道 | 目标受众 | 要挣的东西 | 主战场节点 |
|---|---|---|---|
| **作品集** | 求职（嵌入式 / 机器人 / CV / AI infra）、保研复试、实习面试 | 面试机会 / offer / 保研背书；"一个人 + AI agents 全栈"的稀缺叙事 | 10 月底 demo（共同前置）；寒假后春招；大三暑期实习 |
| **科研** | 世界模型 / 无人驾驶 / HRI 方向老师；未来导师；竞赛评委 | 套磁回音 → 进组/合作；技术报告/论文；推荐信；经费 | 10 月底套磁；11 月定切口；12–1 月初稿；大四前论文 |
| **专利产品** | 学校知识产权中心；大创/挑战杯/互联网+ 评委；潜在用户；寒招对象 | 专利/软著资产；竞赛经费 + 背书 + 答辩演练；产品验证；招生宣传现场 | 11 月软著；11–12 月专利+竞赛；寒假寒招 |

---

## 3. 作品集轨

### 3.1 目标受众
- **求职**：嵌入式 / 机器人 / CV 算法 / AI infra 岗，实习与校招。
- **保研复试**：需要一个"系统级能力"的证据包，而非单点算法。

### 3.2 要挣的东西
> *"一个人 + AI agents，在 0.8 TOPS 的边缘板上搭出感知—决策—执行全栈，并用 A/B 实验和量化数据说话。"*

系统级能力 > 单点算法，这是作品集里最稀缺的叙事；且**"载体（车+篮子）平庸没关系，价值全在让它不像小车的那层"**（RESEARCH §6）。

### 3.3 可交付物清单 (复用为主)

**最小可交付（保底）——不依赖任何新技术：**

| # | 交付物 | 复用度 | 内容 | 量化锚点 |
|---|---|---|---|---|
| P1 | GitHub 仓库门面化 | `[复用]` | 根 README 重写（中英双语）、架构总图、demo.gif、数据表；`.bak` 与历史遗留目录归档 | — |
| P2 | 2–3 分钟 demo 视频（中英字幕） | `[复用]` | 与 Phase B1 同一支，双用途 | 8 分镜、95s 剧本 |
| P3 | 项目一页纸（中英） | `[复用]` | 问题-方法-架构-数据-路线 | — |
| P4 | STAR 卡 ×5 | `[少量新增]` | 每个故事一张（背景/任务/行动/量化结果），面试前 10 分钟刷 | 见下表 |

**5 个面试故事（每个都是一张 STAR 卡）**：

| # | 故事 | 技术点 | 量化钩子 | 诚实标注 |
|---|---|---|---|---|
| A | NPU 边缘视觉管线 | v7.2：11.3fps、INT8、背压流水线、watchdog 自愈 | "从 0.8fps 调到 11.3fps 的 7 个版本" | ✅ 真机 |
| B | 单目极坐标世界快照 | 标定链 + PnP + 8扇区×3环 grid.json | "尺量光心高度差 9% 被废掉 → PnP 误差 3.23%；方位角 0.08°" | ✅ 标定；🔧 HIDE 实机端到端未跑 |
| C | 救援式凝视控制 | 四态滞回 + 底盘绞合弧线 | "持续追踪上线当天翻车，A/B 定位四条扰动通道，重构后稳定" | ✅ 真机 A/B |
| D | 认主系统 | 多信号融合 + α-β 跟踪器 + 机主原则 L0-L3 | "跟错桌子事故的完整搜查 → 三层防御" | ✅ v0 实测；🔧 双人同色待验 |
| E | HRI 行为状态机 + 黑匣子 | 五态机 + 自运动门控 + 施密特去抖 + jsonl 留痕 | "假数据自测 → 实机黑匣子 → 调参闭环" | 🔧 A1.1 通过；动作层未串 |

**扩展清单（可扩性，非保底）：**

| # | 交付物 | 复用度 | 说明 |
|---|---|---|---|
| P5 | 技术博客 5–6 篇 | `[少量新增]` | 一坑一文："现象→搜查→方案→量化收益"，发知乎/掘金/个人站 |
| P6 | A/B 实验报告单独成文 | `[复用+少量新增]` | 凝视翻车→救援式完整对照，负结果内容在技术社区极受欢迎 |
| P7 | Web Dashboard | `[新增]` | 实时 grid 俯视图 + 状态机时间轴 + 黑匣子回放（黑匣子 jsonl 已有，缺前端）——顺带补前端技能面 |
| P8 | ROS2 移植对比版 | `[新增]` | 同功能 ROS2 节点化 vs 裸机服务化对比，展示"什么时候不该用 ROS" |

### 3.4 时间线
- **10 月底前**：只做共同前置（P1/P2/P3）。
- **11 月**：博客起步（先发 A/B 与管线两篇）。
- **12 月–1 月**：5 篇成稿 + 视频精剪 + STAR 卡定稿。
- **寒假**：寒招现场素材回流（照片/短视频）。
- **大四前**：仓库常青维护，按新成果补故事。

### 3.5 所需证据
- demo 视频；**"跟随鲁棒性"数据表**（丢主次数/恢复时长/干预次数，来自 A2 联测）；世界线度量（0.08°/≤2%/3.23%/3/3）；黑匣子状态转移时间轴图；A/B 对照数据。
- **必须逐项标注真机 vs 仿真**（Webots 只验逻辑/接口）。

### 3.6 风险与诚实边界
| 风险 | 预案 |
|---|---|
| 实机 demo 翻车 | 以视频 + 仿真 + 数据表兜底；现场降级为手动模式走剧本（DEMO_PLAN §3） |
| 把仿真当实机宣传 | 全篇标注保真度边界（DEMO_PLAN §1b） |
| 作品集易被抄 | 接受——护城河在科研轨（B 身份），作品集只证明系统能力，不指望独占 |
| 时间被科研/专利挤占 | 作品集排在最低优先级；保底只保 P1–P4 |

---

## 4. 科研轨（主线：主动分离 / Separation–Wait–Reunion）

### 4.1 目标受众
- 三位套磁老师：**世界模型 / 无人驾驶 / HRI** 方向（10 月底）。
- 未来导师、竞赛评委。

### 4.2 要挣的东西
套磁回音 → 进组/合作；1 篇技术报告或论文初稿；推荐信；经费；以及**"大四前真搭子"的研究内核**（唯一护城河）。

### 4.3 主线叙述（必须收窄，不泛谈）

> **一句话**：SC 用**"主动分离"这一负向策略**，把"动态人群中鲁棒跟随"（难、卷、容易输）**重述**为"伴随机器人的**分离事件管理**"（可做、少人做、能赢）。

- 别人的题：*如何在全动态人群里鲁棒跟随？* → 我们的题：*伴随机器人如何管理分离事件？*
- **全部研究内容 = 三个"时机"问题**：**Pre** 何时分（唯一新零件）、**During** 何处等（复用 HIDE/affinity）、**After** 何时回（复用认主+跟随）。
- **两根柱子**：世界模型（等待参照系）+ 认主锁主/跟随（负责"回来"）；柱子在手时，新做的只有 **Pre 触发判据**。
- **不是回避科学，是换一个能赢的提问方式**（RESEARCH §2）。文献对标（RESEARCH §8b）：Follow-Bench / SDA / EscortE / GUIDER / arxiv 1909.06087 / social yield / legibility。
- **差异点一句话**：*把"退避/让开"从失败处理提升为一等公民行为，并用它替代"穿越人群"的难题。*

### 4.4 与四条可验收证据逐条对齐

> 只有拿到其中**至少两条**，才配得上"研究装置"（RESEARCH §7、§9）。现状：四条均为 `💭`——这是 SC 与 gita 的分界线，也是包装里最不能含糊的地方。

| 证据 | 现状 | 最小可争取版本（保底，尽量不依赖新硬件） | 扩展版本 | 数据/物料来源 |
|---|:--:|---|---|---|
| **① 真·预判分离**（连续风险值 + 提前 3–5s 预警，有数据） | 💭 | 用**黑匣子回放 + Webots 合成人群**做"离线风险值曲线"的正/反例论证（不依赖新硬件） | 在线连续风险值 + 预警提前量/ROC 实测 | 黑匣子 jsonl / Webots（可合成人群密度）/ grid.json 扇区占用 |
| **② 等待契约用户研究**（车选的点符合人的直觉） | 💭 | 小样本（个位数 N）视频偏好对比：**模型选点 vs 人直觉选点** | N≥15 受试者 × M 轮，量化吻合度与个体差异 | sector_score + AFFINITY 文献 + Webots/实机选点 |
| **③ 主动重逢**（车主动走向你的手机位置，非原地等） | 💭 | 借**手机热点 MAC 定位（已有）+ 底盘**，在 Webots/仿真里演示"主动走向主人位置" | 实机主动重逢（IMU 航向 + 定位输入） | 认主热点定位 / Webots / `/turn` IMU 航向 |
| **④ 隐形的证明**（用户报告"我不需要想它在哪"） | 💭 | 定性访谈 / 自述（**承认实验室证不了长期**） | 长期田野研究 | 用户研究报告 |

### 4.5 可交付物清单

**最小可交付（保底）——纯写作型，不依赖任何新实验，科研不成也不至于零产出：**

| # | 交付物 | 复用度 | 内容 |
|---|---|---|---|
| R1 | **中/英技术报告 1 篇** | `[复用+写作]` | 正式定义 S-W-R：状态机、**分离事件分类法（severity taxonomy）**、related work 对标表、四证据路线图、已有系统度量 |
| R2 | Position / Statement 一页 | `[复用]` | 套磁用；"问题重述"论述 + 诚实自评 |
| R3 | A/B 负结果实证章节 | `[复用]` | 救援式凝视 vs 持续追踪（四扰动通道归因）——现成 empirical study 素材 |
| R4 | 信号边界分析章节 | `[复用]` | pose offering：零误报成立 / 稳定召回不成立（单目 2D 无深度，非调参可解）——罕见的高质量负结果 |
| R5 | 评测协议草案 | `[少量新增]` | 把 S-W-R 行为映射进 **Follow-Bench** 指标（目标可见率/平滑度/舒适度） |

**扩展清单（任一落地即 workshop/会议级素材）：**

| # | 交付物 | 复用度 | 说明 |
|---|---|---|---|
| R6 | 证据 ①②③ 任一落地 | `[新增/实验]` | 见 §4.4；最小版本优先 |
| R7 | 分离事件数据集 | `[新增]` | 黑匣子持续累积 + Webots 合成，配基线 |
| R8 | 相机-雷达互补受控实验 | `[新增/硬件]` | **作为"分离感知的前置条件"**：何时视觉失效雷达补位、何时雷达失效（玻璃/高物）视觉补位；夜景幻影现成数据集 |
| R9 | 与实验室合作的传感器升级对照 | `[外部]` | 借深度相机/S3 平台；Follow-Bench 完整 benchmark |

### 4.6 时间线
- **10 月底**：带 demo + R2 + 一页纸套磁三位老师。
- **11 月**：按套磁反馈定切口（1–2 个），首选证据 ① 的离线版本。
- **11–12 月**：竞赛本子（顺路）+ 数据采集。
- **12 月–1 月**：R1 技术报告/论文初稿；证据 ② 小样本若可行则做。
- **寒假**：寒招（与科研解耦，不抢资源）。
- **春季**：Phase C 深化（V2 + 证据 ③），套磁跟进。
- **大四前**：论文/毕设成型。

### 4.7 所需证据
见 §4.4；另：系统度量三件（距离误差中位 3.23%、方位角 0.08°、门检测 3/3）、A/B 对照数据、黑匣子 jsonl、Webots 端到端记录、夜景失败数据集、文献对标表。

### 4.8 风险与诚实边界
| 风险 | 预案 / 诚实交代 |
|---|---|
| **用户研究最耗时间、最可能做不完**（唯一差异化点也最吃力） | 降级：小样本视频偏好 + 定性访谈；保底：只写协议与设计，不承诺结论 |
| 主动分离尚未实现 | 用"问题重述 + 已有零件 + 明确缺口"撑；**严禁**说"已经能做主动分离"（RESEARCH §1/§9） |
| 真·世界模型缺失（当前是"世界理解快照"） | 主动交代 snapshot ≠ world model；拓扑路径记忆为下一步 |
| 方法内核不前沿（MPC/卡尔曼/costmap/BLE 皆成熟工具） | 定位差异在 **problem reframing**，不在方法先进度 |
| 套磁无回音 | 12 月初第二轮回访（附 demo 视频链接）；寒假前整理完整技术报告再投一轮 |
| 学期课业挤压 | Phase C 全部可裁；保底 R1–R5 纯写作，可碎片时间完成 |

---

## 5. 专利产品轨

### 5.1 目标受众
学校知识产权中心；大创 / 挑战杯 / 互联网+ 评委；潜在用户；寒招对象（高中母校/学生）。

### 5.2 要挣的东西
专利/软著资产；竞赛经费 + 背书 + 答辩演练；产品验证；寒招现场（**最硬的招生素材是本人和这台车**）。

### 5.3 可交付物清单

**第一步 · 软著（保底，1–2 个月下证，几乎零成本）：**

| # | 名称 | 素材 | 复用度 |
|---|---|---|---|
| S1 | 购物陪伴机器人控制系统软件 V1.0 | rk_control + C3 固件 | `[复用]` |
| S2 | 基于视觉的用户识别与跟随控制软件 | owner_id + follow_controller | `[复用]` |
| S3 | 机器人环境理解与行为决策软件 | hri_state + geometry_daemon/grid | `[复用]` |

**第二步 · 发明专利（方法类，1–3 年周期，尽早占坑）：**

| # | 交底书候选 | 权利要求/创造性论据来源 | 现状 |
|---|---|---|---|
| S4 | 一种基于多信号融合的移动机器人用户锁定与跟随方法 | **机主原则 L0–L3 本身就是权利要求层级结构** | ✅ 实现支撑 |
| S5 | 一种云台-底盘级联的移动机器人视野保持方法 | 救援式（冻结+边缘保持+定向扩展搜索+底盘绞合弧线）；**A/B 实验证明必要性 = 创造性论据** | ✅ 实现支撑 |
| S6 | 一种单目云台极坐标环境快照生成方法（可选） | 标定链 + PnP + grid.json | 🔧 半成品 |
| **S7** | **一种伴随机器人主动分离—等待—重逢控制方法（旗舰·新增）** | **三个时机判据 + 复用映射**（Pre 触发 / During 查图选点 / After 复用认主+跟随） | 💭 设计为主；**交底书须如实界定实施边界** |

> ⚠️ **S7 诚实红线**：主动分离的 `During/After` 有可复用实现，`Pre` 触发目前是设计/部分实现。交底书写成"方法 + 可实施性说明"，**不得声称已完整实现**；保护的是**设计构思**（占坑），实施边界如实描述本身就是可专利性的一部分。

**第三步 · 产品化探索（扩展，不设硬指标）：**

| # | 方向 | 复用度 | 说明 |
|---|---|---|---|
| S8 | **寒招任务**（主任务=载物助手，展示=副产品） | `[复用 V2 设计]` | V2 形态 + 20h 续航 + 过安检；优先级见下 |
| S9 | 防丢跟随模块概念 | `[设想]` | C3→S3（编码器+里程计）+ UWB 标签；购物车/行李箱/宠物 |
| S10 | 场景泛化 | `[设想]` | 校园快递代取 / 实验室巡检 / 导盲伴随——"认主+世界+HRI"三件套换场景 |
| S11 | 最小商业验证 | `[复用+少量新增]` | demo 视频发 B站/小红书，看自然流量与评论需求（零成本需求调研） |

**寒招优先级**（V2 §12.6，直接沿用）：① FOLLOW 稳定 + 人群过滤 + 超声急停 > ② WAIT/BESIDE 守物料（owner_id 锁定 = **防盗叙事**）> ③ HIDE/世界模型/雷达（寒招后）> ④ 柜台 LED 呼吸（彩蛋）。

### 5.4 时间线
- **10 月底前**：只做共同前置。
- **11 月第 1 周**：软著 S1–S3 递交。
- **11 月内**：专利交底书（S4/S5 + 旗舰 S7）→ 走学校知识产权中心递交。
- **11–12 月**：竞赛本子；S6 视情况补。
- **12 月**：V2 整机 + 续航模式（S8 前置）。
- **寒假前**：V2 形态就绪，寒招。

### 5.5 所需证据
代码 + 文档（软著）；A/B 数据 + 机主原则（专利创造性）；safety 实测（实施例）；V2 BOM/CAD（产品）；寒招现场反馈（需求）。

### 5.6 风险与诚实边界
| 风险 | 预案 |
|---|---|
| 发明专利周期 1–3 年 | 尽早占坑；**软著兜底**；专利与软著不冲突，可同时办 |
| 旗舰 S7 实施边界过度声称 | 如实写"Pre 为设计/部分实现，During/After 有可复用实现" |
| 产品/寒招与科研抢资源 | **红线：寒招单列，不与科研轨抢资源**（V2 §0）；载物助手是主任务 |
| 过安检合规 | 动力电池 ≤100Wh（6Ah/72Wh 或 8Ah/96Wh）、充电宝 3C 认证 ≤20000mAh（V2 §10.2） |
| 竞赛本子耗时 | 项目现成，主要写本子；收益=经费+背书+答辩演练，建议 11–12 月报下一批 |

---

## 6. 三轨协同排期

| 时点 | 作品集 | 科研 | 专利产品 | 复用自 |
|---|---|---|---|---|
| **10 月底前** | P1/P2/P3（共同前置） | R2 + 一页纸 + 套磁 | 共同前置 | demo 物料一鱼三吃 |
| **11 月第 1 周** | — | 按反馈定切口 | 软著 S1–S3 递交 | 代码+文档现成 |
| **11 月内** | 博客起步 | 采集 + 切口细化 | 专利交底书（含旗舰 S7）→ 递交 | A/B 数据 + 机主原则 |
| **11–12 月** | 博客系列 | 竞赛本子 + 数据 | 竞赛本子 | demo 数据表 |
| **12 月–1 月** | 5 篇成稿 + 视频精剪 | R1 技术报告/论文初稿 | V2 整机 + 续航 | 黑匣子 + 踩坑史 |
| **寒假** | 寒招素材回流 | 寒招（解耦，不抢资源） | 寒招 V2 形态（S8） | V2 设计 |
| **春季学期** | 仓库常青维护 | Phase C 深化（证据 ③ + 相机-雷达） | 产品试探 S9–S11 | V2 平台 |
| **大四前** | 持续补故事 | 论文/毕设成型 | 防丢模块概念 | 全部 |

**冲突裁决**：科研 > 专利 > 作品集；共同前置（10 月底）不可裁；Phase C 遇课业压力全部可裁（REVIEW §2.4）。

---

## 7. 诚实边界总表（一页看全）

> 本表是套磁/答辩时主动交代边界的底稿，也是防止对外材料吹过头的自查表。

### ✅ 已实现（可对外报）
- YOLO 边缘管线 0.8→11.3fps（背压 + watchdog）。
- 认主锁主 v0（实测通过）+ 机主原则 L0–L3 定稿。
- 救援式凝视 A/B（实机对照，四扰动通道归因）。
- pose offering A/B（零误报成立 / 稳定召回不成立）。
- 标定链：fx=508 三方互证、方位角 0.08°、PnP 3.23%、生产测距 ≤2%、门检测 3/3 零误报。
- Webots 8 分镜端到端（**仅逻辑/接口**）。
- V1 safety 逻辑（超声 20cm、固件 450ms 超时、舵机限位/斜坡）。
- 文献雷达 + affinity 文献地图。

### 🔧 半成品（可讲设计，慎报"已实现"）
- HRI 动作层 / 全场景串跑（A1.3/A1.4 未做）；HIDE 实机端到端未跑。
- grid.json v1 + sector_score（接口已交付，实机 HIDE 未验）。
- `/turn` 真机验证（等电池/扭矩）。
- tracker 时间戳接入、YOLO-World 嵌入缓存。
- V2 CAD/BOM 为设计稿。

### 💭 设想（**只能讲方向，不能讲能力**）
- **主动分离（Pre 触发）**——全项目唯一新零件，未实现。
- **四条可验收证据**（预判/用户研究/主动重逢/隐形）——**一条未做**。
- 真·世界模型（当前只是"世界理解快照"，缺记忆与动力学）。
- 相机-雷达互补实验（硬件未购）、V2 平台、UWB、ReID。
- 防丢模块、场景泛化、商业验证。
- "让用户忘记是机器人"——需长期田野，**实验室证不了**。

---

## 8. 维护约定

- 每完成一个交付物，在本文件对应行打 ✅ 并注日期。
- 每当 `docs/RESEARCH_POSITIONING.md` 的"四条证据"有一条落地，同步在本文件 §4.4 打 ✅。
- 三轨方向/优先级变更，写入 `shadow_carrier_on_rockchip/EXCHANGE.md`（跨线协调）与本文件顶部。
- 与 REVIEW §3、RESEARCH、DEMO_PLAN、V2 的引用若冲突，以本文档为准并回改上游文档。
