cchengoran525/Shadow-Carrier/docs/REVIEW_AND_SEMESTER_PLAN.md

# Shadow Carrier — 项目全量盘点与秋季学期路线（2026-09 → 2027-01）

> 写于 2026-08-29，基于本地仓库（commit `dbc1a2d`）+ 板上实况 + EXCHANGE 全部账目的全量重读。
>
> **唯一硬节点：10 月底 demo 收官，向世界模型/无人驾驶方向与人机交互方向的老师展示套磁。**
> 其余不锁死时间，按依赖推进。

---

# 第一部分：项目全量盘点

## 1.1 项目定位与愿景

**Shadow Carrier（影子搬运者）**：主动式购物陪伴机器人。不遥控、不跟路人——认得主、看得懂主人意图、知道周围哪里能走，在购物动线上主动提供"躲让—迎接—接物"服务。

**Demo 场景（一句话）**：跟主人到饮水机 → 主人打水（静止）→ 车躲到门边等候 → 主人去冰箱取物 → 持物缓近 → 车迎上接过果冻 → 跟主人回去。

**技术叙事三层**（对老师讲述的主线）：

| 层 | 内容 | 对应学术方向 |
|---|---|---|
| 感知 | NPU YOLO 快环 + OpenCV 几何环 + 极坐标世界快照（grid.json）+ YOLO-World 开放词汇慢环 | 世界模型 / 边缘感知 |
| 决策 | 认主锁主（模板+跟踪器+在场信号）+ HRI 行为状态机（持物/弯腰/靠近速度→意图） | 人机交互 / 主动服务 |
| 执行 | 差速弧线跟随 + 救援式凝视云台 + 超声波避障 | 机器人控制 / 无人驾驶全栈 |

诚实定位（答辩防线）：当前产物是**"世界理解快照"（perception snapshot）**，不是严格意义的"世界模型"（缺记忆与动力学）；通往真世界模型的第一步是路径记忆（拓扑图），已在路线图占位。

## 1.2 硬件与系统架构

```
┌─ KickPi RK3566 (4×A55, 0.8TOPS NPU, WiFi热点AP6255) ─────────────┐
│  video_stream_v7 (8080): YOLOv8n INT8 ~11-13fps + MJPEG推流      │
│  rk_control (80): 网页遥控/跟随/云台 + USB CDC → C3              │
│  [世界] geometry_daemon: OpenCV几何1-2Hz + YOLO-World 1Hz 慢环    │
│  [HRI] hri_state: 行为状态机 + 黑匣子jsonl                        │
└────────────────USB CDC (/dev/ttyACM0, 全双工)──────────────────┘
┌─ ESP32-C3 Super Mini (运动控制器) ──────────────────────────────┐
│  TB6612 双TT电机 (MOVE/DIFF) + 超声波 (OBS遥测)                  │
│  LEDC 50Hz 直驱双舵机云台 (PAN/TLT 命令, 指令角即真实角)          │
│  引脚账本: 13 GPIO 已用11, 空闲 GPIO10/21 (预留给 MPU6050 I2C)   │
└────────────────────────────────────────────────────────────────┘
```

关键标定资产（已冻结）：相机内参 fx=508.2/cx=292.7/cy=276.6/k1=-0.295/k2=0.085（三方互证，方位角误差 0.08°）；TILT_LEVEL_CMD=112、PAN_FORWARD_CMD=90.58；机位离地约 10cm。

## 1.3 各线完成度

### ① 认主锁主 — 🟢 demo 级
- **已就绪**：HSV+体态模板打分（enroll 3s 采样）+ α-β 跟踪器门控关联 + BLE 手环/AP 热点手机双路在场心跳 + wait_owner（丢主原地等，不乱跑）。
- **机主原则 L0-L3 定稿**（08-28）：YOLO person 唯一候选入口 → 模板只是偏好层 → 失配=丢主=wait/lost（**绝不跟路人**）→ 在场信号只影响丢失终态；认主失败×2 拒绝进入跟随。
- **首轮实测 6 连修**：幻影人过滤（CONF_MIN=0.5+框高≥70px）、错锁逃逸、bbox 测距证伪回滚恒速。
- **待办**：双人同色对抗验证；ReID 替换 HSV（演进路线①，约 1 天）；UWB（¥50，答辩亮点）。

### ② HRI 智慧算法 — 🔴 唯一红灯（骨架就绪、实机未跑）
- **已就绪**：五态状态机 v0.1（FOLLOW/WAIT/HIDE/RECEIVE/YIELD）过假数据全链路自测；自运动门控（车动时不采信 bbox 位移）；弯腰施密特去抖+冷却+再武装；持物判定（HOLD_CLASSES+IoU 重叠+置信度地板）；黑匣子 jsonl 日志；HIDE 已对接 grid.json 消费（门优先→自由方向）。
- **缺口**：C1 手持物实测未跑（定 RECEIVE 物清单）；owner_score 真接口未接（现用 conf 降级）；动作层未对接（APPROACH/BACK_OFF/GOTO_SAFE 没映射到 /move）；全场景实机串跑 0 次。

### ③ 世界模型 — 🟢 demo 级（grid.json v1 已交付）
- **已就绪**：门检测 v3（回归基准 3/3 命中 0 误报，参数冻结）；极坐标映射（PnP 标定，成对距离误差中位 3.23%）；geometry_daemon（once/loop/scan 三模式）；**grid.json v1 冻结接口**（objects 带真实方位/米数 + 8扇区×3环 + free_directions）；scan 扫掠拼接实测（pan 45/90/135 三帧覆盖 ±67°，约 7s）；一键重标定 auto_calib_pose.py；**YOLO-World v2s 板端 NPU 跑通**（开放词汇，饮水机检出 94.4%，沙箱 runtime 不动系统库）。
- **缺口**：geometry_daemon 等生产者代码**只在板上未入 git**；相邻扇区去重；60s 压测；YOLO-World 嵌入缓存（现每次启动约 3 分钟编码）；"door" 查询词调优。

### ④ 云台坐标解码 — 🟢 超预期完成（原定 demo 不需要）
- **已就绪**：C3 直驱 v0.5（PAN/TLT+网页拖拽+/gimbal）；内参三方互证锁定；方位角解码 0.08°（state/decoder.py）；极坐标 CV-KF tracker（M2，含假数据自测）；**W1 救援式凝视实机定案**（A/B 实验：云台持续追踪是扰动源→重构为"95% 冻结+边缘保持 24°+定向扩展搜索"）；底盘绞合弧线转向（arxiv 1909.06087 同款架构）。
- **实测教训四通道**（gimbal/README）：新旧信号混叠/误差吃光猛扑/幻影乱摆/暂停揉面——已全部入档。
- **缺口**：W1.5 目标源统一（gaze 消费 follow 锁定框）；W2 tracker 接时间戳（前置：yolo_daemon 加 ts）；MPU6050 航向环立项未购件（¥5，治"走歪"根基）。

### 固件/基建 — 🟢
- C3 固件：BLE 批次作废（AP6255 免 root 可用）；OBS 超声波遥测已编译**待烧录**（攒批中）；MPU6050 命令若采购则同批。
- 基建：systemd 三服务稳定；串口 owner 方案落定（凝视并入 rk_control，mode 互锁仲裁）；flock owner 守护已做；EXCHANGE.md 协作机制运转中（本地文件，gitignore）。

## 1.4 冻结接口（跨线契约）

| 接口 | 生产者→消费者 | 状态 |
|---|---|---|
| `/api/detections` | video_stream → ①②③ | 稳定，格式不变 |
| `owner_score(person)->float` | ①→② | 冻结，HRI 未接真实现 |
| `grid.json` v1 | ③→② | **已交付**（板上），HRI 消费端已写好 |
| 串口协议 | rk_control→C3 | MOVE/STOP/DIFF/PAN/TLT/OBS（待烧录） |

## 1.5 资产清单与仓库偏差

- **本地 git（origin/main `dbc1a2d`）**：全量代码 + 各线 README + 论文雷达（8 篇精选）。
- **仅在板上、未入 git** ⚠️：`~/world_lab/` 的 geometry_daemon.py / polar_mapper.py / auto_calib_pose.py / solve_desk_pose.py / validate_desk.py / calib_pose.json / yolo_world 全套（转换产物+demo）；`~/hri_logs/`。**grid.json 的生产者不在仓里 = 冻结接口无源码备份，最高优先收编项。**
- **仓库卫生债**：`shadow_carrier_on_rockchip.bak/`（旧版整包备份）、`DistributedRobot_*/`（历史架构遗产）占空间可归档；config/settings.yaml 仍是占位（代码不读它）；根 README 部分章节（踩坑记录）是 08-07 历史。

## 1.6 已知风险/债务登记

| # | 风险 | 影响 | 缓解 |
|---|---|---|---|
| 1 | C3 冷启动不枚举（老毛病） | demo 翻车 | 冷启动检查清单写进 RECOVERY（待建） |
| 2 | 宿舍夜景幻影 person 率高 | 追幻影/乱摆 | demo 定白天+固定路线；根治靠 owner 模板质量/ReID/里程计 |
| 3 | 底盘开环走歪 | 弧线不准、HIDE 到位率 | MPU6050（¥5）+ 固件攒批 |
| 4 | 板上无外网 | 部署慢 | PC 转换+sftp 流程已固化 |
| 5 | 板子时钟不可信 | 排障误导 | 一律以现象不以时间为准（云台线已记录） |
| 6 | HRI 实机进度 = 0 | **卡 demo 主线** | 本路线 Phase A 第一优先 |
| 7 | 串口多消费者 | 偶发抢占 | 已缓解（flock+mode 互锁），MVP 不再动 |

---

# 第二部分：秋季学期路线（2026-09 → 2027-01）

## 2.0 硬节点倒排

```
09月初 ────────► 10月中 ────────► 10月下 ────────► 10月底(硬)
 Phase A        功能冻结         排练+物料         展示+套磁
 演示冲刺        (feature freeze)  拍摄+一页纸       (三位老师)
```

**原则：10 月中功能冻结后不再加新能力，只修 bug 和排练。**

## 2.1 粗颗粒度：三阶段

| 阶段 | 时间 | 主题 | 出口判据 |
|---|---|---|---|
| **A 演示冲刺** | 09-01 → 10月中 | 把"四线能力"装配成"一个场景跑通" | demo 场景全程无人工干预跑通 ≥3 次，黑匣子全程留痕 |
| **B 包装与展示** | 10月中 → 10月底 | 物料+说辞+工程保障 | 视频/一页纸/现场 demo 就绪，完成 3 位老师套磁 |
| **C 研究深化** | 11月 → 1月 | 按套磁反馈定向深化，产出研究性成果 | 技术报告或论文初稿 1 篇 + 开源仓库门面 |

## 2.2 细颗粒度任务清单

### Phase A：演示冲刺（依赖序，非时间序）

**A1 HRI 实机联调**（第一优先，demo 主线；全部在板上，依赖板子开机）

| # | 任务 | 验收 | 依赖 |
|---|---|---|---|
| A1.1 | C1 手持物实测：果冻/水瓶/香蕉/背包各 30s 对镜头采样（c1_handheld_test.py） | 每类置信度分布表 → 定 RECEIVE 物清单（台词随之定） | 板上电 |
| A1.2 | owner_score 真接口接入 hri_state（替换 conf 降级） | 双人场景选人正确 | 无 |
| A1.3 | 动作层对接：APPROACH→`MOVE F` 低速+超声 20cm 急停；BACK_OFF/YIELD→`MOVE B` 限速；HIDE→按 grid.json 方位转+走+停 | 每个动作实测可触发、可中止 | OBS 遥测烧录（与 A4 同批）或纯视觉距离 |
| A1.4 | 全场景串跑：跟→静止 5s→HIDE（吃 grid.json）→持物缓近→RECEIVE→YIELD→恢复 | 场景剧本完整走通，黑匣子 jsonl 全程记录 | A1.1-1.3 |

**A2 全栈联测**（认主+救援凝视+弧线+超声四层同跑，[认主]线已排）

- 判据沿用 W1 验收：死角占比 <10% 且不出现疯狂偏航；记录"人出 FOV"改善前后对比（黑匣子+录屏）。
- 产出：一张"跟随鲁棒性"数据表（丢主次数/恢复时长/干预次数）——**这是给老师的核心证据材料**。

**A3 世界线收尾**

| # | 任务 | 说明 |
|---|---|---|
| A3.1 | **geometry_daemon/polar_mapper/auto_calib_pose/calib_pose.json 入 git**（最高优先收编，冻结接口无源码备份） | sftp 拉板 → 清洗 → commit |
| A3.2 | scan 中断协议：与 HRI 约定"扫掠可被主人移动中断，云台谁复位"（EXCHANGE 08-28 开放问题） | 一页约定写进 world/README |
| A3.3 | 相邻扇区同类去重 + 60s 压测 | 质量项，不阻塞 demo |
| A3.4 | YOLO-World 嵌入缓存（80×512 npy） | 启动 3min→秒开，demo 体验项 |
| A3.5 | yolo_daemon 加时间戳（W2 前置，顺手） | 10min 级 |

**A4（可选，强烈建议）MPU6050 航向环**

- 采购（¥5，国产兼容片够用）→ 接 GPIO10/21 → 固件改动与 OBS 遥测**攒一批烧录**（一次拔插）→ 100Hz PID 内环 + `HDG <deg>` 遥测。
- 验收：直线 5m 偏差 <0.3m；弧线指令角速度误差 <20%。
- 若 10 月初未到货/不稳：放弃不硬上（GAZE_ENABLED=False 同理，可一键回退）。

**A5 demo 冻结清单（10月中）**

- 场景道具定版：果冻（或 C1 结论替换物）、主人穿鲜艳色衣物（模板质量）、固定路线（饮水机-门-冰箱三点位）。
- 环境：白天固定时段、灯光可控、地面无高反光。
- RECOVERY.md：冷启动检查单（C3 枚举/三服务/相机/手环未绑定/手机连热点）、3 分钟内恢复流程。
- 一键启动脚本：开机 → 三服务自检 → 进跟随模式。

### Phase B：包装与展示（10月中 → 10月底）

**B1 演示物料**

- 排练剧本（含失败重试台词）；多机位拍摄 demo 全程；黑匣子数据可视化（状态转移时间轴图）；2-3 分钟剪辑视频。

**B2 学术物料**

- 项目一页纸（中英双语）：问题-方法-架构图-数据表-路线图。
- 数据表素材来自 A2（跟随鲁棒性）+ 世界线（距离误差 3.23%/检出率）+ 方位角 0.08°。
- 仓库门面：根 README 重写（当前混杂 08-07 踩坑史）、图床、demo.gif。

**B3 套磁三线说辞**（每线一段 3 分钟叙事 + 对应演示桥段）

| 老师 | 叙事钩子 | 演示桥段 | 关联工作 |
|---|---|---|---|
| 世界模型 | "从感知快照到世界模型"：极坐标网格+开放词汇是第一步，路径记忆拓扑图是下一步规划 | HIDE 躲门边（吃 grid.json）+ YOLO-World 检出饮水机 | OneMap/DIV-Nav 类语义网格；诚实交代 snapshot≠world model |
| 无人驾驶 | 边缘端全栈：0.8TOPS 上多模型调度（YOLO 快环+YW 慢环+几何环）+ 单目测距 + 底盘-云台统一控制 | 跟随+弧线转向+超声波避障 | arxiv 1909.06087 同款架构；后续里程计+统一控制器 |
| 人机交互 | 主动式陪伴：从社交信号（持物/弯腰/靠近速度）推断意图，行为状态机输出服务动作 | 持果冻缓近→RECEIVE 迎上；空手快近→YIELD 让路 | SDA（社会动力学跟随）、EscortE、Event-Driven Proactive Assistance |

**B4 现场工程保障**：热备 C3（预烧同版固件）、备用电池、演示失败降级预案（手动模式走完剧本+视频兜底）。

### Phase C：研究深化（11月 → 1月，方向池按套磁反馈选 1-2 个深做）

| # | 方向 | 内容 | 量级 | 服务于 |
|---|---|---|---|---|
| C1 | ReID 认主升级 | OSNet-x0.25 转 RKNN 替换 HSV（歧义触发：≥2 人才算） | ~1 周 | 认主鲁棒性/夜景幻影根治 |
| C2 | 里程计+统一控制器 | MPU6050 DMP 航向积分（若 A4 已做）→ 底盘-云台统一控制器（论文同款）；或迁移 ESP32-S3 上编码器 | 3-4 周 | 走直/弧线精度/坐标解码闭环 |
| C3 | 路径记忆（拓扑图） | demo 动线存为拓扑节点+边，重访时先验引导 → "真世界模型"叙事落地 | 3-4 周 | 世界模型方向深化、套磁后续 |
| C4 | HRI 行为特征 | tracker ṙ/θ̇ 输出接入状态机；YIELD 智能化（让路方向选 free 扇区） | 1-2 周 | HRI 方向深化 |
| C5 | UWB 测距 | DWM3000（¥50）挂 C3，±10cm@10Hz，真实距离喂跟随/RECEIVE | 2-3 周 | 答辩亮点/产品化 |
| C6 | 论文化 | Follow-Bench 框架下量化本系统 + 技术报告/论文初稿（中文会议或 workshop） | 4-6 周 | 学期产出目标 |
| C7 | **V2 平台 × 相机-雷达互补** | V2 硬件补全（分相 V2a/b/c）作为实验台；同平台同场景受控光照，量化"结构感知/低光/玻璃语义/地图锚定"互补矩阵；雷达扫描匹配给滚动地图锚定 → 世界模型"有记忆的度量地图" | 6-8 周 | 无人驾驶（传感器融合/边缘）+ 世界模型（语义网格几何底座）双方向；详见 `V2_CHASSIS_GIMBAL_DESIGN.md §0` |

> **C7 定位（2026-10-08）**：V2 **不是 demo**，是 demo 之后的硬件补全 + 世界模型/HRI 探索平台。相机-雷达互补矩阵是**同平台受控实验**（非文献综述），低光失败数据集（宿舍夜景幻影）现成。红线：V2 上车前世界模型保持相机-only 可跑；雷达 L2/L3 不占 demo 工期；寒招单列不与科研抢资源。

**学期末产出目标**：① 1 篇技术报告或论文初稿；② 开源仓库门面（README+文档+demo 视频）；③ 与至少 1 位老师建立持续联系；④ 系统级升级 1-2 项（从方向池）。

## 2.3 执行原则

1. **依赖优先于日历**：A1 未动则 A2 无从谈起；A3.1（入仓）随时可做且应立即做。
2. **每周节奏建议**（业余时间）：周中 2 次 × 2h 板上联调（A1/A2 迭代），周末 1 次 3h 长联调或物料制作；PC 端任务（A3.1、B2）通勤/碎片时间可做。
3. **固件攒批原则**继续：OBS 遥测 + MPU6050（若采购）合一次烧录。
4. **机主原则/云台所有权规则/冻结接口**等跨线契约继续走 EXCHANGE.md；每周末收工写账。
5. **10 月中功能冻结是铁律**：冻结后 Phase C 方向池只能做与 demo 解耦的独立分支。

## 2.4 风险预案

| 风险 | 预案 |
|---|---|
| HRI 联调超期（最大概率） | 削场景：RECEIVE 用"持物+按键确认"半自动兜底；HIDE 退手动安全点（原降级路径仍有效） |
| 幻影/光照翻车 | demo 定白天+固定动线+主人鲜艳衣物；提前一天同场地彩排 |
| 板子/C3 现场抽风 | RECOVERY.md+热备 C3+视频兜底 |
| 套磁无回音 | 12 月初第二轮回访（附 demo 视频链接）；寒假前整理完整技术报告再投一轮 |
| 学期课业挤压 | Phase C 全部可裁；Phase A/B 不可裁 |

---

# 第三部分：成果包装三轨（作品集 / 科研 / 专利产品）

> 设计原则：**一鱼三吃**。同一个代码库、同一批实测数据、同一套 demo 物料，三条轨道各自包装，边际成本递减。三轨不冲突，冲突时优先级 = 科研 > 专利 > 作品集（按升学/套磁收益排序）。

## 3.1 作品集轨道

**受众**：求职（嵌入式 / 机器人 / CV 算法 / AI infra）、保研复试、实习面试。
**核心卖点**：*"一个人 + AI agents，在 0.8TOPS 的边缘板上搭出感知—决策—执行全栈，并用 A/B 实验和量化数据说话。"* ——系统级能力 > 单点算法，这是作品集里最稀缺的叙事。

### 拆成 5 个可独立展示的"作品"（每个都是一个面试故事）

| # | 作品 | 技术点 | 故事钩子（踩坑→方案→数据） |
|---|---|---|---|
| A | NPU 边缘视觉管线 | v7.2：11fps、INT8、背压流水线、watchdog 自愈 | "从 0.8fps 调到 11fps 的 7 个版本" |
| B | 单目极坐标世界快照 | 标定链（三方互证 fx=508）+ PnP + 8扇区×3环 grid.json | "尺量光心高度差 9% 被我废掉了，改 PnP 误差降到 3.23%" |
| C | 救援式凝视控制 | 四态滞回状态机 + 底盘绞合弧线 | "云台自动追踪上线当天翻车，A/B 实验定位四条扰动通道，重构为救援式后稳定" |
| D | 认主系统 | 多信号融合 + α-β 跟踪器 + 机主原则 L0-L3 | "跟错桌子事故的完整搜查记录 → 三层防御设计" |
| E | HRI 行为状态机 + 黑匣子 | 五态机 + 自运动门控 + 施密特去抖 + jsonl 全程留痕 | "假数据自测→实机黑匣子→调参闭环" |

### 产出物清单

1. **GitHub 仓库门面化**：根 README 重写（中英双语）、架构总图、demo.gif、数据表；`.bak` 和历史遗留目录归档。
2. **技术博客 5-6 篇**（一作一坑）：每篇"现象→搜查→方案→量化收益"，发知乎/掘金/个人站——面试官最容易触达的入口。
3. **2-3 分钟中英字幕 demo 视频**（与 Phase B1 同一支，双用途）。
4. **面试兵器库**：每个作品一张 STAR 卡片（背景/任务/行动/量化结果），面试前 10 分钟刷一遍。

### 拓展方向（可扩性）

- **Web Dashboard**：实时 grid 俯视图 + 状态机时间轴 + 黑匣子回放（黑匣子 jsonl 已有，缺的只是前端）——顺便补前端技能面。
- **ROS2 移植对比版**：同一功能 ROS2 节点化 vs 裸机服务化对比，展示"什么时候不该用 ROS"的工程判断。
- **A/B 实验报告**：凝视翻车→救援式的完整对照实验单独成文，这类"负结果+归因+重构"内容在技术社区极受欢迎。

## 3.2 科研轨道

**受众**：世界模型 / 无人驾驶 / HRI 方向老师（10 月底套磁对象），未来导师。

### 已在手却被低估的研究素材

- **完整 A/B 对照实验**（凝视持续追踪 vs 救援式，四条扰动通道归因）——现成的 empirical study 素材。
- **黑匣子 jsonl**：HRI 状态转移全程结构化数据，持续积累就是小数据集。
- **系统度量三件**：距离误差中位 3.23%、方位角 0.08°、门检测回归 3/3 零误报。
- **论文对标已建**：Follow-Bench / SDA / EscortE / arxiv 1909.06087（同款架构先行者）。

### 三个研究切口（由小到大，按老师反馈选）

| 切口 | 量级 | 题目方向 | 依赖 |
|---|---|---|---|
| 一（快，workshop 级） | 2-4 周 | "0.8TOPS 边缘端快慢环语义感知架构"：YOLO 快环 + YOLO-World 慢环 + 几何环的调度/延迟预算/网格质量 | 已有素材 90%，补延迟实测表 |
| 二（中，会议级） | 1-2 月 | "基于单目社交信号的主动式服务行为推断"：持物/弯腰/靠近速度 → 五态行为，收 N 人×M 轮黑匣子数据做小数据集+基线，对标 SDA/EscortE | A1 联调后持续采集 |
| 三（大，长线） | 学期+ | "从感知快照到拓扑世界模型的伴随机器人导航"：路径记忆+重访先验（与 Phase C3 同一件事的研究包装版） | 套磁反馈确认方向 |

### 路径与竞赛通道

- 路径：10 月底带 demo 套磁 → 11 月按反馈定切口 → 12 月-1 月技术报告/论文初稿。
- **竞赛顺路投一个**（大创 / 挑战杯 / 互联网+）：项目现成，主要是写本子；收益=经费+背书+答辩演练。建议 11-12 月报下一批大创或挑战杯校赛。
- 拓展：与实验室合作后可借深度相机/S3 平台做传感器升级对照；Follow-Bench 框架下做完整 benchmark。

## 3.3 专利产品轨道

**先易后难三步走**，软著兜底、发明占坑、产品试探。

### 第一步：软著（1-2 个月下证，几乎零成本，立刻可做）

按模块申请 2-3 件，代码已有，主要工作是文档（说明书+源码前后 30 页）：

1. "购物陪伴机器人控制系统软件 V1.0"（rk_control + C3 固件）
2. "基于视觉的用户识别与跟随控制软件"（owner_id + follow_controller）
3. "机器人环境理解与行为决策软件"（hri_state + geometry_daemon/grid）

### 第二步：发明专利（方法类，1-3 年周期，尽早占坑）

两个交底书候选（实测教训和 A/B 数据就是权利要求的现成论据）：

1. **"一种基于多信号融合的移动机器人用户锁定与跟随方法"**——模板打分+跟踪器门控+在场心跳+机主原则层级（L0-L3 本身就是权利要求层级结构）。
2. **"一种云台-底盘级联的移动机器人视野保持方法"**——救援式：冻结+边缘保持+定向扩展搜索+底盘绞合弧线（A/B 实验证明其必要性=创造性论证）。
3. （可选第三件）"一种单目云台极坐标环境快照生成方法"。

流程：11 月写交底书 → 走学校知识产权中心（费用通常可减免）→ 12 月前递交。

### 第三步：产品化探索（可选投入，不设硬指标）

- **硬件升级线**：C3→ESP32-S3（编码器+里程计，引脚账本已论证）+ UWB 标签 → "防丢跟随模块"概念（购物车/行李箱/宠物）。
- **场景泛化**：校园快递代取 / 实验室巡检 / 导盲伴随——同一套"认主+世界+HRI"三件套换场景。
- **最小商业验证**：demo 视频发 B 站/小红书，看自然流量与评论需求（零成本需求调研）。

### 拓展方向

- 专利族：认主 / 凝视 / 快照三方法各配"方法+装置"独立权利要求，随产品迭代持续分案。
- 产品与科研互喂：切口二的数据集 → 产品体验报告；产品场景 → 科研 problem set。

## 3.4 三轨协同与排期嵌入

| 时点 | 三轨动作 | 复用自 |
|---|---|---|
| 10 月底前 | 只做共同前置：demo 视频 / 一页纸 / README 门面（Phase B2） | demo 物料一鱼三吃 |
| 11 月第 1 周 | 软著申请递交（3 件） | 代码+文档现成 |
| 11 月内 | 专利交底书 ×2 → 递交 | A/B 实验数据 + 机主原则设计 |
| 11-12 月 | 套磁反馈定科研切口；竞赛本子 | demo 数据表 |
| 12 月-1 月 | 技术报告/论文初稿 + 博客系列 5 篇成稿 | 黑匣子数据 + 踩坑史 |

---

## 附：本文档维护约定

- 每完成一个细颗粒任务，在对应行打 ✅ 并注日期；方向变更写 EXCHANGE。
- Phase A 结束（功能冻结）时出 v2 版：记录实际偏差与 Phase B/C 调整。
