cchengoran525/Shadow-Carrier/docs/DEMO_VIDEO/VIDEO2_VISION_STORYBOARD.md

# 视频 2 — 愿景片「逛街搭子」分镜（简笔画风格）

> 定位：面向**完整产品愿景**的情绪片，回答"这东西最终是什么样、和用户是什么关系"。
> 时长目标 **1'35"–1'45"**，16:9（可选 9:16 竖版供小红书/B 站需求调研，见 README 产品轨）。
> 全片**零功能术语、零 UI、零数据**——能力全部用行为演出来，字幕只写人的话。

---

## 1. 叙事弧（三幕）

1. **问题与登场**（镜 1–3）：拎满双手的狼狈 → 一句愿景 → 俯视开场，人与车一起上路。
2. **同行（能力潜台词）**（镜 4–11）：开门、路人、奶茶、人群分离、接物——每个场景背后是一项能力，但**不说破**。
3. **零负担与落版**（镜 12–14）：主人双手插兜回扣开场 → 路径"走"出名字 → README 引言收尾。

---

## 2. 风格指南

| 项 | 规格 |
|---|---|
| 画布 / 帧率 | 1920×1080；手绘 12fps（输出 24fps，"一拍二"） |
| 色板 | 纸底 `#FAF6EF` / 墨线 `#2F2A26` / **唯一强调色琥珀橙 `#F59E42`**——只给 SC 的眼灯、路径线、交接点 |
| 线条 | 等宽 3–4px 圆头；全程轻微 **boiling 抖动**（±1px、2 帧循环），营造"活的铅稿"感 |
| 转场 | 纸张擦除 / 线条解体重组；不用叠化（除镜 12 呼应开场那一次） |
| 字体 | 手写感中文：站酷快乐体或霞鹜文楷（均可商用免费） |
| SC 角色设定 | 圆角方盒车身 + 两点眼灯 + 两轮 + 顶部浅托盘 + **侧面小挂钩**；无脸，**眼灯是全片唯一"表情系统"**：常亮=跟随 / 转向=注视主人 / 弯弧=开心 / 变浅=待机让行 |
| 主人设定 | 线稿小人（性别中性），固定发型+背包做识别锚点；身高 ≈ 5.5× 车高 |
| 音乐 | 85–95 BPM 轻钢琴 + 口哨/尤克里里；音效：铅笔沙沙、灯"叮"、取餐铃、纸页翻动 |

---

## 3. 分镜表（14 镜）

| 镜 | 时间 | 景别/机位 | 画面 | 动效细节 | 声音 | 隐含能力（只给你看，不进字幕） |
|---|---|---|---|---|---|---|
| 1 | 0:00–0:06 | 特写 | 纸面上铅笔线画出**一只拎满购物袋的手**，指节发白 | 线条 draw-on 生长 | 铅笔沙沙 + 轻钢琴起 | 开场=痛点 |
| 2 | 0:06–0:12 | 中景 | 线条散开重组，画出 SC 轮廓，两点眼灯点亮（橙色，全片第一次强调色） | draw-on + 灯光晕 + 「叮」 | 「叮」 | 手写一行：「如果逛街时，有人替你拿着？」 |
| 3 | 0:12–0:20 | **正俯视**（上帝机位，纸面匀速上滚） | 主人与 SC 从画面**下缘入画**，一前一后往前走，身后路径虚线被"走"出来 | 路径虚线 draw-on 追随脚步 | 轮毂轻响 | 跟随 + 路径可视化 |
| 4 | 0:20–0:27 | 俯视→侧面 | 前方一扇门被推开，SC **减速贴边**，等门全开、主人先过，再侧身通过 | SC 速度用脚下小箭头长短表达；门开合与 SC 减速有先后节拍 | 纸页翻动转场 | 窄口通行 / 动态路径选择 |
| 5 | 0:27–0:35 | 俯视 | 一位路人横穿路线，SC 平滑让出一条**弧线**，绕过后再回到主人侧后 | 弧线以橙色高亮一瞬后淡去 | — | 动态避障 + 路径重规划（V1 已有 sector_score 直觉） |
| 6 | 0:35–0:46 | 中景 | 奶茶店窗口：主人转身**回头**拿奶茶；SC 停住，**两点眼灯转向主人**；主人顺手把奶茶袋挂上 SC 侧钩，眼灯弯成两道小弧 | 眼灯旋转+弯弧=全片唯一"表情"；挂钩处冒一颗小星花 | 取餐铃「叮咚」 | **隐式交互**（README 核心洞察：身体语言即接口）+ 挂钩载物（呼应引言"顺手把外套挂上去了"） |
| 7 | 0:46–0:58 | 俯视→侧 | **核心镜头**：一小簇人（3–4 个线稿小人）迎面走来；主人从中间穿过；SC 提前减速、**主动分离**滑向路边**一盏灯柱旁**停住，眼灯变浅（待机）；人群过后，眼灯先"看"一眼主人方向，再跟上去 | 人与 SC 之间的连线淡出；SC 停点处灯柱高亮一瞬；重逢时连线重新淡入 | 音乐**留一个空拍**（分离的呼吸感），人散后节奏回拍 | **Proactive Separation（V2/V3 在研）**+ 等点可发现性（灯柱=implicit contract 的视觉替身：你不用找它，你自然知道它在哪） |
| 8 | 0:58–1:04 | 俯视 | SC 平稳加速回到主人身后，两者步频重新同步 | 连线淡入 | 节奏回拍 | After 重逢（信念驱动重捕获，V3 议题，演不解释） |
| 9 | 1:04–1:07 | 小图拼贴 | SC 提前绕开一滩**水洼**（俯视小图） | — | 水滴音 | 感知安全性 |
| 10 | 1:07–1:12 | 小图拼贴 | 一个小朋友跑过，SC 减速停半步让行；前方有台阶，SC 放慢 | 速度箭头变短 | 童声笑声(远) | Proxemics 社交距离 / 地形谨慎 |
| 11 | 1:12–1:24 | 中景→推近 | SC 渐慢（它"知道"要到了）；主人提着购物袋**刚好从商店门里出来**；镜头推近，主人笑了笑把袋子递过去，SC 小步迎上，主人放好、轻拍车顶 | 半拍慢动作；交接点橙色高亮 | 音乐扬起 | RECEIVE 意图识别→主动上前（V1 已验证的能力，愿景里原样出现） |
| 12 | 1:24–1:30 | 正俯视（回扣镜 3） | 继续往前走；主人**双手插兜**（奶茶挂在车上） | 与镜 1 那只拎满的手**叠化**对照 | — | 零负担 = 产品承诺 |
| 13 | 1:30–1:38 | 俯视定格 | 走过的路径逐渐显现出手写体 **「Shadow Carrier · 逛街搭子」** | 文字沿路径 draw-on，铅笔收笔 | 收笔沙沙 | 片名落版 |
| 14 | 1:38–1:42 | 落版 | 白底 logo + 引言：*"不知道啥时候来的，我顺手把外套挂上去了。"* | 淡入 | 尾音 | README 品牌声线原句 |

---

## 4. 隐含能力 ↔ 真实规划对照（防吹牛底账）

套磁时老师若问"愿景片里哪些做出来了"，这张表就是你的回答底稿：

| 场景 | 背后能力 | 状态 |
|---|---|---|
| 镜 3/5 跟随与绕行 | FOLLOW + 路径重规划 | V1 已有（sector_score 亲和度已上线） |
| 镜 4 窄口贴边 | 动态路径 / 社会让行 | V1 部分 / V2 绕行型（需麦轮） |
| 镜 6 挂奶茶 | 隐式交互（README 核心洞察） | RECEIVE 持物识别已真机验证 |
| 镜 7 人群分离 | **Proactive Separation**（Pre/During/After） | V2/V3 封存在研（DEFERRED_WORK.md）——愿景片的灵魂正好是下一步的研究主脊 |
| 镜 8 重逢 | 信念驱动重捕获 | V3 / Phase C 议题 |
| 镜 9–10 安全细节 | 感知与社交距离 | 工程持续项 |

> 这正是这片子的高级之处：**愿景即 roadmap**。它不是幻想片，是研究计划的预告片——跟老师聊的时候每一镜都有实证路线可指。

---

## 5. 制作管线（三条路，推荐组合拳）

| 管线 | 做法 | 优劣 | 用在哪 |
|---|---|---|---|
| **A. AI 图生视频（主力）** | 每镜先做**首帧**（MJ/即梦/Krea 出线稿图）→ Kling / 即梦 / Veo / Runway 图生视频 5–10s → 剪映合成 | 快、量大；一致性靠首帧+参考图锁 | 镜 3–8、11–13 的"行走/分离/接物" |
| **B. 手绘逐帧（点睛）** | Procreate 12fps 逐帧，或 AE shape layer | 质量最高、最费工 | **眼灯表情、连线淡入淡出、小星花**——这几个 AI 做不准，手绘 30 帧搞定 |
| **C. 代码动画（兜底+预演）** | SVG/Canvas 或 Python 绘帧 → ffmpeg 合成 | 全可控、零成本，适合规则运动 | 路径 draw-on、文字落版（镜 13）、**先出 animatic 验证节奏** |

**推荐组合**：先用 C 出整条 animatic（含音轨节拍点）→ 定稿节奏 → A 管线逐镜生成 → 关键表情用 B 修 → 剪映/PR 合成。纸上纹理统一在后期叠一层（混合模式"正片叠底"），能把 AI 素材的"塑料感"压回手绘感。

### AI 一致性三招
1. **角色设定图先行**：主人和 SC 各出一张三视图定稿，之后每镜生成时都作为参考图垫底（MJ `--cref` / Kling 参考图 / 即梦主体一致性）。
2. **风格词尾缀固定**：每条 prompt 结尾粘同一段风格串（见 §6 模板）。
3. **一镜一判定**：AI 每镜生成 3–5 候选，只挑线稿风格稳的；线稿黑白简单场景，AI 出错率远低于彩色写实，这是选简笔画风的工程红利。

---

## 6. AI 提示词模板

### 首帧图 prompt（MJ / 即梦 / Krea）
```
minimalist black-ink line drawing on warm white paper, hand-drawn sketch
animation keyframe, [场景描述], a small rounded cart robot with two dot eyes
and a side hook, thin clean ink lines, no shading, no color fill, subtle
paper texture, consistent character design --ar 16:9 --style raw
```
负向词：`color, 3D render, realistic, detailed background, text, watermark`

### 图生视频 motion prompt（Kling / Veo / Runway）
```
Hand-drawn 2D animation, lines slightly wobbling (boiling line effect),
[运动描述：the cart follows the person smoothly forward / the cart glides
aside and stops beside the lamppost], camera slowly tracks, gentle motion,
12fps feel, white paper background stays static
```

### 分镜示例（挑 4 个最难镜头）
| 镜 | 场景描述段（填入模板） |
|---|---|
| 3 | top-down view of a pedestrian street drawn in thin ink lines, a person walking forward followed by a small rounded cart robot, a dashed path line trailing behind them |
| 7 | the cart robot glides aside to a lamppost and stops while a small group of sketched pedestrians walks past the owner, overhead view |
| 11 | close-up: the smiling owner hands a shopping bag down to the small cart robot which has rolled slightly forward |
| 13 | the dashed path behind them curves into handwritten letters "Shadow Carrier" |

### 角色一致性设定图 prompt
```
character design sheet, minimalist ink line drawing: (1) a small rounded
cart robot with two amber dot eyes, side hook, two wheels, front/back/top
views; (2) a young person with a backpack, front/side view; warm white
paper background, clean thin lines --ar 16:9
```

---

## 7. 交付规格

同视频 1：ProRes 母版 + H.264 发布版 + SRT；封面帧用镜 7（人群分离，全片最有故事性的画面）。
