cchengoran525/Shadow-Carrier/shadow_carrier_on_rockchip/state/calib/chessboard_screen.png

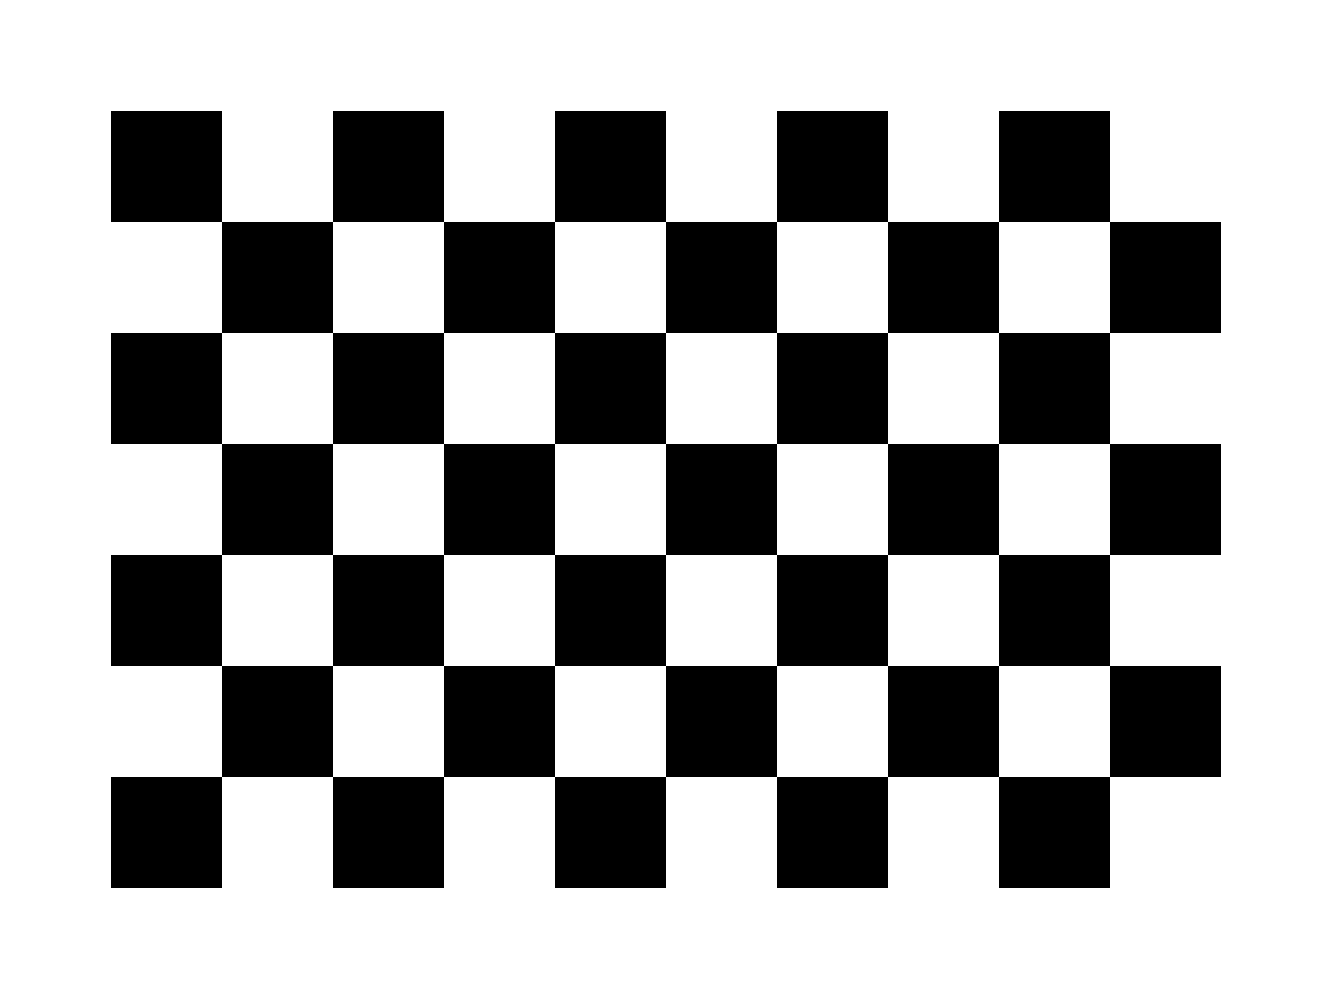
shadow_carrier_on_rockchip/state/calib/chessboard_screen.png
