cchengoran525/Shadow-Carrier/(list of files, cad)

Other CAD files:
cad/SC_V2_layout.f3d
