cchengoran525/Shadow-Carrier/shadow_carrier_on_rockchip/scripts/test_panel.html

🧪 ShadowCarrier 测试台 T0b · T4 · 健康 ?

手动 跟随 ■ 急停

fps - age - C3 - OBS - HRI - ← 视频/遥控

跟随 标定 健康 调参

### 场景录制（T2 / T3 / T4 / T6 / T7）

● 开始录制 ■ 停止并分析

idle

自动项：锁定率 / 最长缺失 / 换主 / 命令停止 / OBS；净空与转向朝人看视频+卷尺。

最近录制文件

（点击刷新）

刷新列表

视频预览（占带宽，默认收起）

### 链路 / 手动 / 认主

T0 链路 T8 手动 T1 enroll 停止

idle

T0 = PING→F→STOP→L→STOP；T8 = F/B/L/R/STOP 各 0.4s。仅手动模式，真跑前会二次确认。

### 原地转（手动）

90° 180° -30° 符号

deg speed 执行

idle

判据：角度误差 ≤10°、重复性 ±5°；记起始/结束 yaw + 耗时 + 地面实际角度。

### 健康快照

刷新

点击刷新

### 日志（保留 200 个 / 30 天）

刷新日志列表

加载中...

### 速度 / 力矩（重载档）

BASE 巡航

MIN 内轮

PIVOT 原地转

MANUAL 手动

阻尼 K

转向增益

应用 恢复默认（重载档） 读取

值域 0–255；立即生效并持久化到 ~/hri_logs/motion_tune.json。

### 通道开关

转向通道 T2 基线：关 T4 passby：开

腿跟 关（默认） 开（需验证）

腿跟：仅最近强锁 3s 内、仅 1 人、腿带 ±25°、OBS>35cm、dist≥0.7m 才维持慢速前进；默认关。

原始 JSON

加载中...
