cchengoran525/Shadow-Carrier/docs/FIELD_TEST_PLAN.md

# 实地测试与 demo 录制方案（FIELD TEST PLAN）

> 写于 2026-10-20（HEAD `7b4ddc5`）。距 10-31 demo **11 天**。
> 用途：把"能跑"变成**可验收、可复现、可拍**。每个场景一张卡：布置 → 步骤 → 成功标准 → 失败/中止 → 记录。
> 配套：`DEMO_PLAN.md`（8 分镜）、`ARCHITECTURE.md`（接口）、`COORDINATION_REVIEW.md`（缺口）。
> 阈值来自代码实测常量（2026-10-21 重载档）：`BASE_SPD=245`、`MIN_SPD=155`、`PIVOT_PWM=240`、`MANUAL_FWD_SPD=255`、`NEAR_STOP_M=0.7`、`LOST_TIMEOUT_S=2.4`、认主 `3s/~12 样本`、HRI `static_need 5s / hide_after 20s`；现场用 `/motion/config` 微调。

---

## 0. 使用方式

1. **先 P0 后 P1**：P0 不过，不往下走；P1 依赖 HRI/动作层接线。
2. **每天开场先跑 T0**（链路 smoke），FAIL 就先修链路。
3. **每个场景至少 3 次**；记"3/3、2/3"而不是"感觉可以"。
4. 失败也记录：失败帧、日志、现场照片——失败数据是 demo 视频的 B-roll 和套磁素材。

---

## 1. 前置条件（当天开场 Checklist）

### 1.1 硬件
- [ ] **C3 插回**：`/dev/ttyACM0` 或 `/dev/serial/by-id/...` 在位；`PING`/`OBS` 有回显
- [ ] 相机 `/dev/camera0` → `video*`；USB 供电、autosuspend 关闭
- [ ] 电池满电（或热备电池）；载物盒固定、不晃
- [ ] 云台**冻结居中**（demo 默认）
- [ ] 卷尺、地标胶带、秒表、手机/运动相机、备用存储

### 1.2 软件 / 服务
- [ ] `health_check.sh`：**FAIL=0**（允许 WARN：手机未连热点）
- [ ] `rk-control` / `video-stream` / `imu` / `c3-watchdog` / `ap-hotspot` active
- [ ] `/api/detections`：fps ≥10，age <200ms
- [ ] `imu.json`：age <1s，quality ≥0.8
- [ ] 认主 enroll：`samples ≥8`（3s / 约 12 采样）
- [ ] P1：`hri_state --live` 常驻；`geometry_daemon` 常驻；`/dev/shm/hri_state.json` 新鲜
- [ ] P1：`grid.json` 新鲜；动作桥（action → `/move`）已接

### 1.3 场地
- [ ] 白天 / 均匀光（避免逆光、玻璃门反光）
- [ ] 走廊净宽 ≥1.5m；地面干燥、无门槛
- [ ] 地面标记：起点 / 5m / 10m / 转弯点 / 等待点 / 横向 0.8·1.2·1.5m
- [ ] 安全员 1 名；路人演员 1 名；清场

### 1.4 安全
- [ ] 急停方式：手动 `STOP` / 断电 / 直接抱走
- [ ] 速度上限：跟随 BASE 220（≈0.86 m/s）、手动 240（≈0.94 m/s）；demo 不加速
- [ ] 最小间距：正前 0.7m（真实距离）/ 框高 400（仅正前 100px）；侧向 ≥0.6m
- [ ] C3 watchdog、camera-usb-fix 已开

---

## 2. 统一度量口径（避免"各说各话"）

| 指标 | 定义 | 怎么量 |
|---|---|---|
| 人车距离 | 车体前缘到人脚的地面距离 | 地面胶带 + `range_from_box` 日志 + 视频抽帧三方交叉 |
| 车速 | 5m 平均速度 | 秒表 ×3 / 视频时间戳 |
| 主人在画面 | 该帧存在主人 bbox | `owner.json` 或 `/api/detections` 抽帧 |
| 锁定正确 | bbox 与主人真值 IoU ≥0.3 | 人工标注 + `owner.json` 回放 |
| 横向净空 | 车体最外沿到人的最小距离 | 卷尺（静态标记）+ 视频 |
| 事件时刻 | 状态切换/停/转/丢 | `hri_logs/*.jsonl` + `journalctl -u rk-control` |
| 转向速率 | 原地转 °/s | T0b 实测（3 次取均值） |
| 遮挡时长 | 主人 bbox 连续缺失时长 | 视频逐帧 + dets 时间戳 |

**判定原则**：**视频能看见 + 日志能对上 + 卷尺能量到**，三者至少两项一致才算过。

---

## 3. 场景矩阵

### T0 · 链路 smoke（P0，5 min）
**布置**：车放起点，人站正前 2m。
**步骤**：依次发 `PING` / `MOVE F 120` / `STOP` / `MOVE L 120` / `STOP`；看 `/api/detections`、`imu.json`、`health_check.sh`。
**成功标准**
- health_check **FAIL=0**；
- 四个动作都有物理响应，`STOP` 在 0.5s 内停；
- dets fps ≥10、age <200ms；IMU age <1s。
**失败/中止**：C3 不枚举、相机黑屏、服务不 active → 先修链路，不进入后续场景。

### T0b · 原地转标定（P0，10 min）
**布置**：空旷平地，地面贴 0°/90°/180° 参考线。
**步骤**：`/turn_pivot`（或 `MOVE L/R` 定时）转 90°、180° 各 3 次；秒表 + 视频量角度。
**成功标准**
- 实测角速度与 `PIVOT_RATE_DPS=174` 偏差 ≤15%；
- 90°/180° 角度误差 ≤10°；同向重复性 ±5°；
- 若超差：更新 `PIVOT_RATE_DPS`，并记入 EXCHANGE。
**记录**：每次的角度、耗时、PWM、电池电压。

### T1 · 认主 enroll（P0，5 min）
**布置**：主人穿**鲜艳上衣**，站 1.5–2m，正对相机；路人站画面外。
**步骤**：启动跟随 → 3s enroll → 主人左右移动 2m → 路人入画 3s → 主人出画 3s 再回。
**成功标准**
- `[owner] enroll samples ≥8`；
- `owner.json` 在 5s 内出现，score ≥`SCORE_MIN(0.40)`；
- 路人入画 3s **不写 owner.json、不触发换主**；
- 主人出画 3s 回来后 **≤3s 重锁**。
**失败/中止**：`samples=0` 或 `largest-fallback` → 换更鲜艳衣服/靠近/调光，重录模板。

### T2 · 直线跟随（P0，10 min）
**布置**：10m 直道，地面每 1m 标记；主人背对车走。
**步骤**：手动模式先跑 5m ×3 记基线；再切跟随，主人以 **0.8–1.0 m/s** 走 10m。
**成功标准**
- 平均车速 **≥0.8× 手动基线**；
- **无停顿 >1.5s**（除主人停）；
- 人车距离维持 **1.7–3.5m**（视频/测距）；
- 5m 横向偏差 **≤0.3m**；
- 不丢锁、不撞墙。
**记录**：手动/跟随各 3 次的时间、距离曲线、丢锁次数。

### T3 · 转弯跟随（P0，10 min）
**布置**：L 型 90° 弯 + U 型 180° 掉头，转角留 ≥1.5m 回转空间。
**步骤**：主人正常步速过弯；车跟随。
**成功标准**
- 过弯全程主人 bbox 在画面 **≥90% 帧**；
- 若出画：**≤3s 重捕获**，不原地打转 >6s（`PIVOT_TIMEOUT_S`）；
- 不擦墙、不撞障碍；
- 方向反转 ≤3 次/5s（`REVERSAL_MAX`）。
**记录**：过弯耗时、出画时长、重捕获方式（TURN/BLIND/SEARCH）。

### T4 · passby 擦身（P0，核心，20 min）
**布置**：走廊宽 ≥1.5m；主人从车**正前**走向车侧再走到车后；横向 0.8 / 1.2 / 1.5m 三档；步速 0.6（慢）/ 0.9（正常）两档。
**步骤**：每档 ×2 次（左/右各一次）；记录车是否转、转到多少、是否停。
**成功标准**
- 主人可见期间**不出现 >1.0s 的停住**；
- 主人 bbox 在画面 **≥90% 帧**，最长连续缺失 **≤0.5s**；
- 车会朝主人侧转（θ 符号正确），**不反向**；
- 最小横向净空 **≥0.6m**；
- 全程**不换主**（路人/主人身份不串）；
- 若丢人：**≤2.4s** 进入 wait_owner，不盲目前冲。
**失败/中止**：转 30° 就停、反向转、贴人 <0.6m、换主 → 立即 STOP，记录帧号。
**记录**：三档 × 两速 × 左右 = 12 条；每条记"停住次数/最长停顿/出画时长/净空/是否换主"。

### T5 · 双人 / 路人干扰（P0，10 min）
> **2026-10-20 机主裁定：双人场景经常出现且稳定，暂跳过专项验收**（不阻塞 P0）；
> 现场自然出现时只记录，不专门组织。恢复条件：passby/HIDE 稳定后，或换人门逻辑有改动。
**布置**：主人与路人同框；路人从车与人之间横穿，或比主人更靠近车 3s。
**步骤**：路人横穿 3 次；路人站到主人前面 3s；两人交错走。
**成功标准**
- 锁定主人 **≥95% 帧**；**0 次换主**；
- 路人更近时**不锁路人**（换人确认门生效）；
- 若误锁：**≤2s** 恢复主人。
**记录**：每次的 owner.json bbox 与两人真值对照。

### T6 · 静止 / 停等（P0，10 min）
**布置**：主人走 5m 后停下 5s，再走。
**步骤**：正常跟随 → 主人停 → 5s → 主人走。
**成功标准**
- 主人停后 **≤1.5s** 车停；
- 停住后位移 **<0.1m**（不顶人、不蠕行）；
- 人车距离 **≥1.2m**（`near_dist_m`）；
- 主人再走 **≤1s** 恢复跟随。
**记录**：停车延迟、停后位移、恢复延迟。

### T7 · 遮挡 / 丢人（P0，10 min）
**布置**：柱子/门框/拐角；主人躲 3s；另一次主人直接出画 5s。
**步骤**：遮挡 3s → 出现；出画 5s → 回来。
**成功标准**
- 遮挡期：车不胡乱加速，**前冲 <0.3m**；
- 出现后 **≤3s 重捕获**；
- 出画 5s：**≤2.4s** 进入 `wait_owner/lost_stop`，**不持续前进**；
- 全程不撞障碍。
**记录**：进入 wait 的时间、重捕获时间、期间位移。

### T8 · 手动兜底（P0，10 min）
**布置**：10m 直道 + 90° 弯；手机/网页遥控。
**步骤**：F/B/L/R 各 3s；直线 5m；跟随中一键切手动。
**成功标准**
- 手动 F/B 能带动载物盒（不堵转）；
- 5m 直线偏差 **≤0.3m**（IMU 航向保持）；
- `STOP` 0.5s 内停；
- 跟随→手动接管 **≤1s**，不失控。
**记录**：电流/电压（如有）、直线偏差、接管延迟。

### T9 · HIDE 选点（P1，需 world+HRI+动作层，20 min）
**布置**：走廊 + 门 + 饮水机/冰箱；车在主人身后 2m。
**步骤**：主人静止 20s（`hide_after_s`）→ WAIT→HIDE → 车自行挪到墙根；重复 3 次。
**成功标准**
- **3/3** 触发 WAIT→HIDE；
- 落点靠墙、**不挡门/不挡家电正面**（离门中心 ≥1m）；
- 落点主人回望**可见**（或至少在选中扇区）；
- 全程不撞、不卡死；到达后 `parked=True`。
**失败/中止**：grid 陈旧 / 动作层未接 → 标记 P1 未就绪，不阻塞 P0。

### T10 · RECEIVE 递物（P1，需 HRI+动作层，15 min）
**布置**：主人在 HIDE 车旁，持**水瓶/玩偶**（不用果冻）缓近。
**步骤**：持物靠近 → 车 APPROACH → 合拢 → 停。
**成功标准**
- **3/3** 进入 RECEIVE；
- 最终间距 **0.3–0.5m**，不撞人；
- 交接后 `receive_exit_s(0.8s)` 退出，回 WAIT；
- 超声 20cm 急停不被误触发（或触发后能恢复）。
**记录**：触发距离、最终间距、误触发次数。

### T11 · 全流程 8 分镜（P0 目标，P1 依赖，40 min/次）
**布置**：按 `DEMO_PLAN.md` 动线；安全员 + 路人 + 递物演员。
**步骤**：完整 8 分镜连跑，不中途救场。
**成功标准**
- **连续 3 次**不救场完成；
- 总时长 **≤3 min**；
- 每个分镜达到其单项标准（见 §4）；
- 黑匣子 jsonl 完整；视频可剪。
**失败/中止**：任一 P0 分镜失败 → 记录失败点，回到对应单项场景复训。

### T12 · 故障注入（P1，10 min）
**步骤**：拔/插 C3；拔/插相机；重启 rk-control；切手动。
**成功标准**
- C3 watchdog **≤10s** 恢复；
- 相机自愈 **≤5s** 恢复出图；
- 服务重启后 HTTP/串口恢复；
- 任意时刻手动接管有效。
**记录**：恢复时间、是否需人工二次插拔。

---

## 4. 8 分镜 × 测试场景 × 验收

| # | 分镜 | 依赖场景 | 单项通过标准 |
|---|---|---|---|
| 1 | 跟出宿舍门 ~2.5–3m | T1/T2 | 10m 不丢、无停顿 >1.5s、距离 1.7–3.5m |
| 2 | 打水静止停车 | T6 | ≤1.5s 停、停后位移 <0.1m、≥1.2m |
| 3 | HIDE 到墙根 | T9 | 3/3 落点靠墙不挡门、可见 |
| 4 | 路人进门 → 锁主不跟 | T4/T5 | 0 换主、主人 ≥95% 帧、净空 ≥0.6m |
| 5 | 冰箱取物（HIDE 中注视） | T9（云台冻结版） | 主人出画不断状态、不误唤醒 |
| 6 | 持物缓近 → RECEIVE | T10 | 3/3 触发、0.3–0.5m 停 |
| 7 | 上前接住 ~0.3m | T10 | 不撞、超声兜底、可退出 |
| 8 | 回程 FOLLOW（搜索转身） | T3/T7 | ≤3s 重捕获、方向正确、不撞 |

> **当前实机可覆盖**：1/2/4/6/8 的跟随部分 + 手动兜底；**3/5/7 依赖 HRI/世界/动作层**（P1）。

---

## 5. demo 视频录制方案

### 5.1 器材与参数
- 主机位：手机/微单，**1080p60**，固定白平衡；副机位：运动相机（跟拍/低角度）。
- 收声：环境声即可；**不要现场加音乐**（后期配）。
- 光线：白天均匀光；避免窗户逆光；必要时补一盏柔光。
- 存储：每镜 3 条 take；拍完立刻备份。

### 5.2 机位（文字版）
```
        [门]
         │
   ┌─────┴─────┐
   │  走廊      │   A: 主人 POV（回头看车）
   │            │   B: 第三人称侧后方（看车+人）
   │   C: 固定广角（看 HIDE/等待点）   │
   │   D: 低角度贴地（看轮子/转向）     │
   └────────────┘
```
- **A 主人 POV**：手持，回头拍车（分镜 1/8）。
- **B 第三人称**：侧后方 2–3m，拍人车关系（分镜 2/4/6）。
- **C 固定广角**：拍 HIDE 选点/等待（分镜 3/5）。
- **D 低角度**：拍转向/轮速/接物（分镜 7，B-roll）。

### 5.3 分镜拍摄表

| # | 镜头 | 机位 | 时长 | 关键动作 | 备选 |
|---|---|---|---|---|---|
| 1 | 跟出宿舍门 | A + B | 8–10s | 主人出门，车跟 2.5–3m | 手动跟拍 |
| 2 | 打水停车 | B + C | 6–8s | 主人停 5s，车减速停 | 固定机位 |
| 3 | HIDE 挪到墙根 | C | 10–12s | 车自行挪到墙根 | 后期加速 |
| 4 | 路人擦身 | B + 低角度 | 8–10s | 路人横穿，车锁主不跟 | 慢动作回放 |
| 5 | 冰箱取物 | C | 6–8s | 主人出画，车不误唤醒 | 固定 |
| 6 | 持物靠近 | B | 6–8s | 主人拿水瓶走近 | 近景 |
| 7 | 上前接住 | D + B | 6–8s | 车 APPROACH 到 0.3–0.5m | 慢动作 |
| 8 | 回程跟随 | A + B | 10–12s | 车掉头跟上到门口 | 跟拍 |

### 5.4 拍摄顺序（按场景批量，不按剧本顺序）
1. 先拍 **B-roll**（车体/传感器/屏幕/轮子/标定/启动）——不依赖演出。
2. 再拍 **T4 passby**（最难的先拍，状态好）。
3. 再拍 **T2/T3/T6/T7**（跟随素材）。
4. 最后拍 **T9/T10**（若已接线）。
5. 每条 take 记"场景 ID + take 号 + 结果"，避免后期找不到。

### 5.5 失败重拍规则
- 单镜 **3 条 take**；取最好一条。
- 出现安全事件（贴近 <0.5m、撞、换主）→ 立即停，重来，不剪进去。
- 真跑不通的镜头 → **手动模式补拍** + 字幕标注"手动兜底"，不假装自主。

### 5.6 隐私与安全
- 路人演员知情同意；不拍无关人员正脸。
- 拍摄时安全员全程在车侧 1m 内，手放急停。
- 不在楼梯/坡道/湿滑地面拍摄。

---

## 6. 记录表模板

| 日期 | 场景 | 第几次 | 结果 | 关键指标 | 视频 | 日志 | 备注 |
|---|---|---|---|---|---|---|---|
| 10-20 | T4-1.2m-慢-左 | 1/3 | ✅ | 停 0 次 / 出画 0.2s / 净空 1.15m | IMG_001 | rk-control | — |
| 10-20 | T4-0.8m-正常-右 | 1/3 | ❌ | 停 1.2s / 净空 0.55m | IMG_002 | hri_logs | 需收紧速度门 |

**每条必须能回答**：过了吗？哪条标准没过？下次改什么？

---

## 7. 执行顺序（10-20 → 10-31）

| 日期 | 场景 | 目标 |
|---|---|---|
| 10-20 | T0 / T0b / T1 / T8 | 链路 + 认主 + 手动兜底 |
| 10-21 | T2 / T3 / T6 / T7 | 跟随基本盘 |
| 10-22 | **T4 passby**（三档×两速） | 核心叙事 |
| 10-23 | T5 双人 + T12 故障注入 | 锁主 + 恢复 |
| 10-24/25 | P1 接线：hri_state / geometry / 动作桥；T9/T10 | 行为层 |
| 10-26/27 | T11 全流程 ×3 | 连演 |
| 10-28/29 | 视频拍摄（§5） | 素材 |
| 10-30/31 | buffer + 一页纸 | 套磁 |

---

## 8. 一句话判定

**P0 全过 = 可以拍 demo；T11 3/3 = 可以邀请老师看现场。**
任何"看起来可以但没记数据"的，一律按未过处理。

---

## 9. 角色分工（Sprint-1，2026-10-20/21）

| 线 | 负责场景 | 交付 / 验收 |
|---|---|---|
| **[基建]** | T0 / T12 | 板端同步、`hri-state`/`geometry` 单元、C3 链路、`health_check` FAIL=0 |
| **[运动控制]** | T0b / T2 / T3 / **T4** / T8 | 原地转标定、passby 三档×两速、跟随、手动兜底 |
| **[认主]** | T1 / T5 | enroll ≥8 样本、passby 换人门（**双人专项暂跳过**，机主 10-20 裁定） |
| **[HRI]** | T6 / T9 / T10 | 五态、动作输出、黑匣子日志 |
| **[世界]** | T9 | `grid.json` 新鲜、`sector_scores.confident`、HIDE 落点 |
| **[云台]** | T0 / T1 | IMU 零偏/质量、bearing 符号、云台冻结 |
| **[统筹]** | T11 | 合并门、日程、demo 范围裁决 |

> 回执写 `EXCHANGE.md`；验收记录用 §6 表；未过项必须写"下次改什么"。

---

## 10. HRI 实地补充清单（可与 T 系列并行）

> 阈值来自 `scripts/hri_params.json`：**静止 5s → WAIT**；再 **20s → HIDE**；持物近距 **1.2m → RECEIVE**；
> 快速靠近 **0.8 m/s → YIELD**；RECEIVE 持续后退 **0.8s** 或停滞 **2s** → 退出；主人丢失 **2s** → WAIT。
> 动作由 `rk_control` 的动作桥执行（`APPROACH / BACK_OFF / GOTO_SAFE`），**只在 `mode=follow` 生效**。

| ID | 场景 | 前置 | 步骤 | 成功标准 |
|---|---|---|---|---|
| **H1** | 服务健康 | — | 看 `/tmp/hri_state.log` / `hri_state.json` | 文件 **age <1s**；`state` 随场景变化；`--owner-source file` 生效 |
| **H2** | WAIT（静止 5s） | T1 成功 | 跟随中主人站定 5s → 再走 | **≤5.5s** 进 WAIT；主人移动 **>0.4m** 后 **≤1s** 回 FOLLOW |
| **H3** | HIDE 触发（静止 20s） | H2 + grid 新鲜 | 继续站定到 20s | 进 HIDE；`action=GOTO_SAFE <bearing>`；`parked=true`；`grid.json` age <60s |
| **H4** | GOTO_SAFE 执行 | H3 | 观察车转向+前移（≤1.5s） | 转向**朝安全方位**、不反向；不撞；到位停；**3/3** |
| **H5** | RECEIVE 触发 | 车在 WAIT/HIDE | 主人持水瓶/玩偶，正前方 **1.2–1.5m** 缓近 | **≤1s** 进 RECEIVE；`action=APPROACH` |
| **H6** | APPROACH 执行 | H5 | 车向前合拢 | 最终 **0.3–0.5m** 停；不撞；OBS ≤35cm 能中止 |
| **H7** | RECEIVE 退出 | H6 | 主人持续后退 0.8s；或原地不动 2s | 回 WAIT；冷却 **6s** 内不重复触发 |
| **H8** | YIELD / BACK_OFF | 车在 WAIT/HIDE | 主人以 **>0.8 m/s** 快速靠近 | 进 YIELD；`action=BACK_OFF`；车后退 **0.6s** 后停 |
| **H9** | 丢人/中途中止 | RECEIVE 中 | 主人出画 2s；或按 `/stop` | RECEIVE→WAIT；车立即停；不继续前冲 |

### 10.1 与 T 系列的合并跑法（一次布场，按这个顺序）

```
T0 链路 → T0b 原地转 → T1 认主 → T8 手动
        ↓
T2 直线 → T3 转弯
        ↓
T6 静止（同时验 H2：WAIT）
        ↓
T9 HIDE（同时验 H3+H4：20s → GOTO_SAFE）
        ↓
T10 RECEIVE（同时验 H5+H6+H7：持物 → APPROACH → 退出）
        ↓
T4 passby（核心，8~12 条）+ H9（出画/急停）
        ↓
T7 遮挡 + H8（快速靠近 → BACK_OFF）
        ↓
T11 八分镜全串
```

### 10.2 注意事项
- **所有 HRI 动作只在 `mode=follow`**；manual 下不消费，别在 manual 里等它动。
- **先 T1 enroll**：`owner.source=file` 时没有 `owner.json`，HRI 不会触发任何状态。
- **HIDE 前看 grid**：`~/world_lab/fusion/grid.json` 的 `ts` <60s；停驻后 `geometry-parked.timer` 会刷新。
- **GOTO_SAFE 首次必看方向**：`bearing` 右正 → 车应右转；反了改 `HRI_BEARING_TO_YAW_SIGN`。
- **HIDE 中主人出画不中断**（设计如此）；RECEIVE 中出画 2s 才回 WAIT。
- 动作桥是有界脉冲：APPROACH ≤3s、BACK_OFF 0.6s、GOTO_SAFE 转向 ≤3s + 前进 ≤1.5s；异常先 `/stop`。

---

## 11. 变更后的实地运行顺序（T + R，2026-10-25）

> **R 系列 = 改动后的“健全性/回归”检查**（Regression/Robustness），不替代 T 系列功能验收；
> T 系列判据不变。本节回答：**10-25 这批改动之后，实地按什么顺序跑、哪些必须重跑。**
>
> 10-25 改动：`SIM_TURN=0` 真正关转向、`/turn` TOCTOU 锁、imu 重零 dt、`/gimbal` NaN 拒收、
> `BACK_SPD` 假键摘除、`uart_reader` 10ms 防自旋、旧推流脚本弃用横幅。
> 麦轮 S3 是 V2 预写，**不影响 V1 实地**。

### 11.1 变更 → 受影响测试

| 变更 | 影响 | 必须重跑/新增 |
|---|---|---|
| `SIM_TURN=0` 真关转向 | **仅 Webots**；实机不受影响 | **R6**（PC 侧 off 臂） |
| `/turn` TOCTOU 锁 | 手动原地转的并发/占位逻辑 | **T0b** + **R2** |
| imu 重零弃一拍 + 重采 dt | 跟随启动后的航向连续性 | **T2 开头** + **R5** |
| `/gimbal` NaN 拒收 | 云台指令安全（demo 期云台冻结，但面板可发） | **R3** |
| `BACK_SPD` 假键摘除 | `/motion/config` 页面/持久化 | **R1** |
| `uart_reader` 10ms 退避 | C3 掉线/OBS 延迟（活口几乎不变） | **R4** + T4/T10 的 OBS 段 |
| 旧推流弃用横幅 | 无行为影响 | 不需要 |

### 11.2 R 系列（实地健全性，新增）

| ID | 场景 | 步骤 | 成功标准 | 时机 |
|---|---|---|---|---|
| **R0** | 离线回归门 | 跑 `scripts/test_*.py` + `world/fusion/test_*.py` | **17/17 PASS**（含 glue G/H/I/J） | 出发前 |
| **R1** | 板端基线 | `health_check`；`/healthz`；`/motion/config` GET | FAIL=0；`uart.fail=0`；`obs_guard_veto` 字段在；**无 `BACK_SPD`** | 到场先做 |
| **R2** | `/turn` 锁 | manual 下连续两次 POST `/turn` | 第二次 **busy**；只一个 worker；完成后 `active=false` | T0 后 |
| **R3** | `/gimbal` NaN | POST `{"pan": NaN}`；再 `{"pan": NaN, "tilt": 100}` | 前者 **400 无 PAN**；后者只发 TLT；`/gimbal/center` 正常 | T0 后 |
| **R4** | uart 死 fd / 防自旋 | 跟随时拔 C3 再插；看 `/healthz.uart.fail`、日志、CPU | fail 增长 + `[UART] send FAIL`；**CPU 不 100% 自旋**；车 ≤450ms 自停；重启 rk-control 恢复 | 收工前/故障注入 |
| **R5** | imu 重零航向 | 启动跟随（触发重零），记重零前后 yaw | 航向**不阶跳**（<5°）；T2 开头直行稳定 | T1 后 |
| **R6** | Webots `SIM_TURN=0` | PC：`SIM_TURN=0 ./run_passby.sh`，对照 `SIM_TURN=1` | off 臂**真的没有转向通道**；A/B 两臂行为可区分 | PC，可并行 |
| **R7** | 回退演练 | `/stop` → `/mode/manual` → 手动 F/B → C3 拔插 | 接管 **≤1s**；车停；链路可恢复 | 收工前 |

### 11.3 推荐顺序（一次布场）

```
出发前：R0 离线回归
到场：  R1 基线
        T0 链路 smoke
        R2 /turn 锁 + R3 NaN + R5 imu 重零（快速健全性）
        T0b 原地转（锁改动后必重跑）
        T1 认主
        T2 直线（imu 改动后重点看开头）
        T3 转弯 / T6 静止 / T7 丢人
        T4 passby（核心）
        T9 HIDE / T10 RECEIVE（P1）
        T11 八分镜
收工：  R4 uart 拔插 + R7 回退
PC：    R6 SIM_TURN=0 off 臂（可与实地并行）
```

### 11.4 中止线（R 系列）

- R0 有 FAIL → 不上车；
- R1 FAIL≠0 → 先修链路；
- R2 出现**两个 worker** 或第二次不 busy → 停止手动转，查 `turn_lock`；
- R3 出现 `PAN nan` 被钳到限位 → 停云台，查 `_clamp_pose`；
- R4 CPU 自旋或车不停 → 立即 `/stop` + 重启 rk-control；
- R5 航向阶跳 >5° → 不跑 T2/T4，先查 imu 重零；
- R6 off 臂仍有转向 → A/B 数据作废，先修 `SIM_TURN`。

### 11.5 一句话

**T 系列照旧，但 T0b/T2 必须重跑；R0–R7 是这批改动的“体检”，R0/R1 不过就不上车。**
