cchengoran525/Shadow-Carrier/wifi/C3_WiFi_Controller/UltrasonicSensor.h

#ifndef ULTRASONIC_SENSOR_H
#define ULTRASONIC_SENSOR_H

#include <Arduino.h>

class UltrasonicSensor {
 public:
  void begin();
  void update();
  bool isObstacleDetected() const;
  int lastDistanceCm() const;

 private:
  int measureDistanceCm();

  uint32_t lastSampleMs_ = 0;
  int lastDistanceCm_ = -1;
  uint8_t clearSampleCount_ = 0;
  bool obstacleDetected_ = false;
  uint32_t lastObstacleLockMs_ = 0;
};

void initUltrasonicSensor(UltrasonicSensor &sensor);

#endif
