cchengoran525/Shadow-Carrier/shadow_carrier_on_rockchip/scripts/video_stream_fast.py

#!/usr/bin/env python3
"""video_stream_fast.py - yolo_daemon常驻进程高速推流

⚠️⚠️ 已弃用/不可用(2026-10-25 标注, 优化审查§7.3-6) ⚠️⚠️
本脚本以 stdout=PIPE 读 yolo_daemon 的 JSON, 而 yolo_daemon v3 起把 stdout 重定向到
/dev/null(丢弃 rknn 库调试打印)、JSON 改走 stderr —— 协议已对不上: readline 恒 EOF,
恒返回 {"error":"parse"}, 推流黑屏。请改用现役 video_stream_v7.py。计划 demo 后移入 legacy/。
"""
import sys
print("[DEPRECATED] video_stream_fast.py 与现行 yolo_daemon 协议不兼容(JSON 走 stderr 而非"
      " stdout), 恒无检测结果; 现役脚本 = video_stream_v7.py", file=sys.stderr)
import cv2, subprocess, os, time, threading, json, socketserver
from http.server import HTTPServer, BaseHTTPRequestHandler

CAMERA_ID = 10
WIDTH, HEIGHT = 1280, 720
YOLO_DAEMON = "/home/kickpi/shadow_carrier_on_rockchip/perception/yolo_daemon"
MODEL = "/home/kickpi/shopping_car_vision/rknn_model_zoo/examples/yolov8/cpp/build/model/yolov8.rknn"
YOLO_CWD = "/home/kickpi/shopping_car_vision/rknn_model_zoo/examples/yolov8/cpp/build"
TEMP_IMAGE = "/tmp/yolo_frame.jpg"
JPEG_QUALITY = 75

latest_jpeg = None
latest_dets = []
fps = 0.0
frame_count = 0
lock = threading.Lock()
daemon = None


def start_daemon():
    global daemon
    daemon = subprocess.Popen(
        [YOLO_DAEMON, MODEL], cwd=YOLO_CWD,
        stdin=subprocess.PIPE, stdout=subprocess.PIPE,
        stderr=subprocess.DEVNULL, text=True, bufsize=1
    )


def infer(path):
    daemon.stdin.write(path + '\n')
    daemon.stdin.flush()
    line = daemon.stdout.readline()
    try:
        return json.loads(line)
    except:
        return {"error": "parse"}


def stream_loop(cam_id):
    global latest_jpeg, latest_dets, fps, frame_count

    cap = cv2.VideoCapture(cam_id, cv2.CAP_V4L2)
    cap.set(cv2.CAP_PROP_FOURCC, cv2.VideoWriter_fourcc(*'MJPG'))
    cap.set(cv2.CAP_PROP_FRAME_WIDTH, WIDTH)
    cap.set(cv2.CAP_PROP_FRAME_HEIGHT, HEIGHT)
    if not cap.isOpened():
        print(f"FATAL: cam /dev/video{cam_id}")
        return
    print(f"Cam: {int(cap.get(3))}x{int(cap.get(4))}")

    ftimes = []
    while True:
        t0 = time.time()
        ret, frame = cap.read()
        if not ret: time.sleep(0.01); continue

        cv2.imwrite(TEMP_IMAGE, frame, [cv2.IMWRITE_JPEG_QUALITY, JPEG_QUALITY])
        result = infer(TEMP_IMAGE)

        if "error" not in result:
            latest_dets = result.get("det", [])
            out_path = os.path.join(YOLO_CWD, "out.png")
            if os.path.exists(out_path):
                annotated = cv2.imread(out_path)
                if annotated is not None:
                    annotated = cv2.resize(annotated, (WIDTH, HEIGHT))
                    _, jpeg = cv2.imencode('.jpg', annotated, [cv2.IMWRITE_JPEG_QUALITY, JPEG_QUALITY])
                    with lock:
                        latest_jpeg = jpeg.tobytes()
                        frame_count += 1

        now = time.time()
        ftimes.append(now)
        ftimes = [t for t in ftimes if t > now - 5]
        if len(ftimes) >= 2:
            fps = len(ftimes) / (ftimes[-1] - ftimes[0])


class Handler(BaseHTTPRequestHandler):
    def log_message(self, *a): pass

    def do_GET(self):
        if self.path in ('/', '/stream'):
            self.send_response(200)
            self.send_header('Content-Type', 'multipart/x-mixed-replace; boundary=frame')
            self.send_header('Cache-Control', 'no-cache')
            self.end_headers()
            last = b''
            try:
                while True:
                    with lock: jpeg = latest_jpeg
                    if jpeg and jpeg != last:
                        self.wfile.write(b'--frame\r\nContent-Type: image/jpeg\r\n')
                        self.wfile.write(f'Content-Length: {len(jpeg)}\r\n\r\n'.encode())
                        self.wfile.write(jpeg); self.wfile.write(b'\r\n')
                        last = jpeg
                    time.sleep(0.02)
            except: pass

        elif self.path == '/api/detections':
            self.send_response(200)
            self.send_header('Content-Type', 'application/json')
            self.send_header('Access-Control-Allow-Origin', '*')
            self.end_headers()
            with lock:
                self.wfile.write(json.dumps({"fps": round(fps,1), "frames": frame_count, "detections": latest_dets}).encode())

        elif self.path == '/viewer':
            html = r'''<!DOCTYPE html><html><head><meta charset="utf-8"><title>ShadowCarrier</title>
<style>*{margin:0;padding:0}body{background:#111;color:#fff;font-family:monospace;display:flex;height:100vh}
.v{flex:1;display:flex;align-items:center;justify-content:center}.v img{max-width:100%;max-height:100vh}
.p{width:320px;background:#1a1a1a;padding:20px;overflow-y:auto}h2{color:#0f0}.fps{color:#ff0;font-size:20px}
.d{background:#222;padding:10px;margin:8px 0;border-radius:6px;border-left:4px solid #0ff}
.d .c{font-size:18px;font-weight:bold}.d .n{color:#0f0}.d .o{color:#888;font-size:12px}
</style></head><body><div class="v"><img src="/stream"></div><div class="p">
<h2>ShadowCarrier</h2><div class="fps" id="f">FPS: --</div><div id="x">...</div></div>
<script>setInterval(async()=>{try{const r=await fetch('/api/detections');const d=await r.json();
f.textContent='FPS: '+d.fps+' | '+d.frames+' frames';
if(d.detections&&d.detections.length){x.innerHTML=d.detections.map(dd=>
`<div class="d"><span class="c">${dd.c}</span> <span class="n">${(dd.p*100).toFixed(0)}%</span>
<div class="o">[${dd.x1},${dd.y1}]→[${dd.x2},${dd.y2}]</div></div>`).join('');}
else{x.textContent='no detections';}}catch(e){}},500);</script></body></html>'''
            self.send_response(200)
            self.send_header('Content-Type', 'text/html; charset=utf-8')
            self.end_headers()
            self.wfile.write(html.encode())
        else:
            self.send_response(302); self.send_header('Location', '/viewer'); self.end_headers()


class Threaded(socketserver.ThreadingMixIn, HTTPServer):
    allow_reuse_address = True; daemon_threads = True


def main():
    import argparse
    p = argparse.ArgumentParser()
    p.add_argument('--port', type=int, default=8080)
    p.add_argument('--camera', type=int, default=CAMERA_ID)
    args = p.parse_args()

    print("Starting yolo_daemon...")
    start_daemon()
    time.sleep(0.5)
    print(f"Camera /dev/video{args.camera}...")
    threading.Thread(target=stream_loop, args=(args.camera,), daemon=True).start()
    time.sleep(2)
    print(f"Ready: http://192.168.137.190:{args.port}/viewer")
    httpd = Threaded(('0.0.0.0', args.port), Handler)
    try:
        httpd.serve_forever()
    except KeyboardInterrupt:
        pass
    finally:
        httpd.shutdown()
        if daemon: daemon.stdin.close(); daemon.terminate()


if __name__ == '__main__':
    main()
