cchengoran525/Shadow-Carrier/(commit log)

2026-07-04 Add distributed robot v0.2 Arduino firmware
2026-07-04 Add S3 AP mode and C3 motor driver
2026-08-04 Harden obstacle stop and motor standby behavior
2026-08-04 Add KickPi vision brain + update README
    - shadow_carrier_on_rockchip/: RK3566 vision brain (YOLO NPU pipeline ~11FPS, crash-recovering watchdog, memory-disk frames)
    - gimbal/: 2-axis servo pan/tilt following largest person (software PWM)
    - communication/: C3 UART protocol spec (KickPi replaces S3 gateway, C3 untouched)
    - README: add v0.3 KickPi Vision Brain section
    [gimbal_follow.py, settings.yaml, video_stream.py, video_stream_fast.py]
2026-08-06 v0.3: WiFi TCP replaces UART, Rockchip USB debugging documented
    - communication: RK3566 UART TX dead (0 bytes), CH340/CP2102 USB crashes -> WiFi TCP solution
    - communication/C3_WiFi_Controller.ino: new C3 firmware connecting KickPi hotspot, TCP:8888
    - scripts/rk_control.py: v2 TCP client replacing UART serial
    - All USB-Host debugging and wiring findings documented
    [C3_WiFi_Controller.ino, gimbal_follow.py, rk_control.py, settings.yaml, video_stream.py, video_stream_fast.py]
2026-08-06 v0.4: USB direct connect (final), cleanup, docs
    - communication/C3_USB_Controller.ino: C3 USB CDC firmware
    - communication/README.md: updated with final USB solution + pitfall log
    - scripts/rk_control.py: v3 pure Python UART, /dev/serial/by-id path
    - scripts: removed old v3-v6 video_stream, repro, WiFi test files
    - README: simplified, reflects USB final architecture
    - Failed approaches documented: RK UART, CH340, CP2102, WiFi TCP
    [C3_USB_Controller.ino, C3_WiFi_Controller.ino, gimbal_follow.py, rk_control.py, settings.yaml, video_stream.py]
2026-08-06 Final state: USB solution stable, document 5 next steps
    - README: updated with next 5 tasks (ultrasonic bug, latency, mode switch, follow, gimbal)
    - perception/README: condensed with latency note
    - All services persistent: ap-hotspot, rk-control, video-stream
    - USB order: camera first, C3 second
2026-08-07 2026-08-07: ultrasonic fix, latency optimization, web mode switch, follow control research
    - Ultrasonic bug fixed: sensor timeout force-clear + 5s safety net
    - Latency: 1280->640, Q75->50, V4L2 BUFFERSIZE=1
    - Web: remote/follow mode toggle UI, /move variable-speed endpoint
    - CDCOnBoot=cdc pitfall documented (biggest time-sink)
    - USB CDC deadlock fix: uart_reader drain thread
    - Follow control test (failed with oscillation), research recorded
    - Cold boot race condition documented (C3 power sequencing)
    [C3_USB_Controller.ino, CommandParser.cpp, CommandParser.h, Config.h, MotorDriver.cpp, MotorDriver.h, Protocol.h, UltrasonicSensor.cpp]
2026-08-07 research: visual following control study (Go2 P-controller, IBVS, 5-layer anti-oscillation)
    - Unitree Go2 follow_controller analysis (P-only, deadband, proportional speed)
    - IBVS simplified pixel-to-velocity formula
    - Mini Pupper ROS2 + RVPF-YOLO references
    - 5-layer anti-oscillation pipeline documented
    - First test failure analysis
2026-08-09 feat: differential steering follow v3 (DIFF command + arc following)
2026-08-09 docs: MVP->Demo roadmap, 4 directions (lock-owner, world-understanding, receive, gimbal)
    Direction 1: BLE + HSV + posture fusion for owner locking (no model training)
    Direction 3: YOLO+OpenCV pipeline, door/wall/ground detection for HIDE behavior
    Direction 4: item awareness + RECEIVE approach behavior
    Direction 2: gimbal coordinate transform (deferred)
2026-08-22 feat(gimbal): C3 direct-drive 2-axis gimbal (v0.5)
    - firmware: PAN/TLT commands, LEDC 50Hz hardware PWM, direction/pulse calibration constants
    - restore DIFF-capable deps accidentally overwritten from communication/ copies
    - consolidate: communication/ now docs-only, canonical sketch in C3_USB_Controller/
    - rk_control.py v5: web drag-pad gimbal control + /gimbal API, absolute angles
    - gimbal_follow.py v2: serial-based person following (no GPIO PWM)
    - docs: gimbal README rewritten (RK3566 pinout investigation, wiring, calibration)
2026-08-24 feat(world): world module from board world_lab (B1 door detection)
    - adaptive Canny + Hough door detection v3, frozen params.py
    - regression.py acceptance baseline (3/3 doors, 0 false positives)
    - fusion prototype: grid_snapshot.json producer
2026-08-24 fix(owner): harden owner lock after first live test
    - owner_id: float coercion for daemon JSON, phantom-person filter
    (CONF_MIN=0.50 + MIN_BOX_H=70), saturation-adaptive color weight,
    soft gate penalty (0.5 -> 0.15)
    - follow_controller: low-score streak escape (tracker reset ~3s),
    coast on miss, reuse hardened _fetch_detections
    - decision/README.md: first live-test log (6-bug fix history, lessons,
    next steps ranked by follow-retention impact)
    - main README: roadmap table update (manual gimbal done, BLE heartbeat)
    [follow_controller.py, owner_id.py]
2026-08-25 feat(owner): wifi hotspot presence signal (band -> phone evolution)
    - owner_id: PHONE_MAC neighbor-table + ping check (AP6255 AP mode lacks
    iw station dump), dual presence signal owner_nearby() = BLE band OR hotspot
    - follow_controller: wait_owner now gates on owner_nearby()
    - decision/README: band->phone options A/B/C, plan A deployed+verified
    (iPhone8 fixed-per-SSID random MAC)
    [follow_controller.py, owner_id.py]
2026-08-25 feat(hri): behavior state machine v0.1 + handheld detection probe
    - hri_state.py: FOLLOW/WAIT/HIDE/RECEIVE/YIELD skeleton, consumes
    /api/detections + owner_score frozen interface; self-motion gating;
    bend/posture debounce with schmitt thresholds; --live and --fake modes
    - c1_handheld_test.py: C1 confidence distribution sampler for held objects
    - gen_fake_hri.py + fake_script.jsonl: scripted scenarios for offline
    state-machine validation
2026-08-27 feat(state): camera intrinsics tri-validated + M1 bearing decode (gimbal line)
    - state/calib: capture/calibrate/pan_sweep(rotate-sweep self-calib)/solve_geom tools
    - lock FX=508.2 FY=492.7 CX=292.7 CY=276.6 K1=-0.295 K2=0.085 (board scan vs chessboard vs desk-truth agree)
    - geometry consts: TILT_LEVEL_CMD=112, PAN_FORWARD_CMD=90.58, mirror convention documented
    - decoder.py pixel->bearing with undistortion + mirror handling
    - note: C3 firmware batch consumed for PAN/TLT command set + DIFF restore (see EXCHANGE.md log)
2026-08-27 docs(gimbal): gaze controller v3 design — state machine, chassis coupling, reverse info flow
2026-08-27 feat(state): polar CV-KF tracker (M2) + fake-data selftest PASS
    - state [theta, theta_dot, r, r_dot] with timestamp-based OOSM updates
    - soft/hard chi-square gates: continuous-track outliers rejected whole-frame,
    long-gap re-detection hard-resets (age-conditional)
    - quality=exp(-age/1.2) for gaze state machine consumption
    - selftest: 20s scenario w/ dropout(3s)+outlier(+18deg)+latency(0.25s)
    PASS: bearing RMS 1.66deg, range RMS 0.137m, coast 4.79deg
2026-08-28 fix(follow): restore person-class filter in largest-fallback (regression from e5e3d3c rewrite)
    [follow_controller.py]
2026-08-28 feat(follow): gimbal-decoupled steering via world bearing + gaze v2 edge-keeper + US telemetry
    - follow_controller: optional bearing_fn -> steering error from world bearing
    (immune to gimbal edge-keeping error capping); person filter kept
    - gaze.py v2: cascade edge-keeper per owner design (keep-in-view only,
    no auto-centering); supersedes takeover-style W3 coupling (thrash + INVERT sign trap)
    - rk_control: gaze thread publishes owner world bearing; escape-only drive loop
    - firmware: OBS telemetry line (compiled, flash pending next C3 unplug)
    [C3_USB_Controller.ino, follow_controller.py, rk_control.py]
2026-08-28 fix(owner): refuse low-saturation owner templates (desk-incident guard)
    gray/white template from low-mount camera matched any gray object (laptop,
    sofa, door) and follow drove into the desk. Now enroll refuses sat_energy
    < SAT_LOW and falls back to largest-person following (person-filtered).
    [owner_id.py]
2026-08-28 fix(owner): enroll gate threshold 55 (sat=40/48 templates caused desk-chase)
    [owner_id.py]
2026-08-28 fix(follow): owner template is preference, not veto
    per owner principle: YOLO person is the sole prior; owner template only
    selects WHICH person. Template mismatch no longer stops follow (fell through
    to person-filtered largest). Aspect filter reverted (HRI territory).
    [follow_controller.py]
2026-08-28 tune(gaze): rescue-only mode — KEEP_EDGE 12->24deg, rate 18->10 (A/B proven: continuous pan destabilizes follow)
    Four destabilization channels identified via gimbal on/off A/B test:
    A) stale-u x fresh-pan mixing in bearing_fn, B) error-eating until lurch,
    C) phantom-driven pan swings, D) follow pause thrash.
    Rescue-only: pan frozen ~95% of time, fires only near true frame exit.
    GAZE_ENABLED flag kept for instant fallback to gimbal-frozen follow.
    [rk_control.py]
2026-08-28 feat(gaze): directional expanding search — remembers exit side, sweeps 10->45deg toward it
2026-08-28 docs(gimbal): MPU6050 heading-loop plan — principle, wiring, limits, pin budget
2026-08-29 feat(owner): owner-principle L0-L3 finalized — enroll-fail refuses follow, largest-fallback removed
    [follow_controller.py, owner_id.py, rk_control.py]
2026-09-03 docs: add three-track packaging plan (portfolio / research / patent+product) with extensible roadmaps
2026-10-03 feat(hri): geometry-independent params layer + class-agnostic in-hand detection
    - hri_params.json: single source of truth; physical-first (shoulder-width distance,
    aspect-ratio bend), pixel fallback, scale-invariant ratios; camera section only
    needs refresh after recalibration -> no logic rewrite when camera height changes
    - fix 3 coupling bugs: height-derived distance misread bend as approach/recede;
    near-range clipping corrupted aspect baseline (freeze posture when clipped);
    RECEIVE timeout starved during valid approach (progress-based + exit cooldown)
    - held-object channel: named classes first, then class-agnostic relation rule
    (any non-person box overlapping owner upper body, a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
    [c1_handheld_test.py, gen_fake_hri.py, hri_state.py]
2026-10-03 feat(sim): Webots desktop simulation + opt-in detector injection for follow controller
    - simulation/webots/: world + supervisor controller reusing real scripts/
    (FollowController + HRIStateMachine) without RK3566/C3 hardware
    - follow_controller: person_provider kwarg (default None) — sim injects
    detections, real robot keeps the owner_id enrollment path unchanged;
    drop top-level cv2 import (no residual usage)
    - grid path flows through the params layer (paths.grid_json) instead of
    the removed hri_state.GRID_JSON constant
    - docs: sim section in both READMEs; gitignore GraphFlow local artifacts
2026-10-03 docs: V2 chassis-gimbal design notes
2026-10-03 feat(firmware): ESP32-C3 WiFi controller (ASCII protocol, TB6612, ultrasonic)
2026-10-03 fix(hri): ungate approach rate from ego-motion; sim camera focal from Webots
    - RECEIVE drives the robot itself, so ego-motion gating was suppressing the very
    progress signal it needs -> state exited as 'stalled' after 2s while still
    approaching. Approach rate (width-derived) is now computed ungated; entry
    signals (static/bend/offering) stay gated. Affects real hardware too.
    - webots sim: derive camera.focal_px from the actual Camera node FOV/width so
    metric distance/speed thresholds hold in simulation instead of using the
    physical board's 508px calibration
    - drop dead K (height-derived) after switching to shoulder-width distance
    [hri_state.py]
2026-10-03 fix(firmware): sync WiFi C3 variant to authoritative sources + add sync guard
    The wifi/C3_WiFi_Controller shared sources were a pre-DIFF snapshot (~08-09),
    missing DIFF differential command + ultrasonic obstacle latch; flashing it would
    regress arc-following and the latch safety net. Sync all 8 shared .h/.cpp from
    C3_USB_Controller (only the .ino transport differs now).
    Add tools/check_firmware_sync.sh: byte-compares shared sources, exits 1 on
    divergence, --fix auto-syncs. Arduino requires per-sketch source copies, so this
    mechanical guard prevents the fork-from-stale again (08-27 lesson).
    Also note in the .ino: WiFi is an experimental transport (needs rk_control TCP
    client; do NOT build w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
    [C3_WiFi_Controller.ino, CommandParser.cpp, Config.h, MotorDriver.cpp, MotorDriver.h, Protocol.h, UltrasonicSensor.cpp, UltrasonicSensor.h]
2026-10-03 feat(sim): jsonl black box for Webots sessions
    Log every HRI tick (state/action/dist/v/held/bend + detected labels + sonar) and
    every transition to sim_session.jsonl next to the controller, same schema family
    as the board black box. The repo lives on the Windows disk, so runs launched from
    Webots (Windows) are readable from WSL for offline analysis without copy-paste.
2026-10-03 feat(sim): headless autotest mode + demo-scene landmarks
    - SIM_AUTOTEST=1: controller scripts the OWNER/OFFER_OBJECT nodes through a
    timeline (static->slow approach w/ object->recede->fast approach->static/HIDE
    ->object approach->disappear), ignores keyboard, logs jsonl, auto-quits.
    Enables running the sim without a human (headless/software-GL).
    - world: add demo-scene landmarks (water dispenser, refrigerator, counter) plus
    richer grid snapshot (objects now carry bearing/dist for each landmark) so the
    simulated world matches the demo route (dispenser -> door -> fridge -> handover).
    - sim params: override shoulder_width_m=0.62 to match the simulated person width
    so width-derived d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
2026-10-03 fix(hri): real-machine first-run fixes + gimbal center ramp
    hri_state:
    - held object: require BOTH upper-body overlap and area < 0.3x owner (kills chair/
    potted-plant/suitcase false positives); add held_min_hits arming + latch window
    - static: require low approach speed too (head-on walk looked 'static' before)
    - velocity: raw speed for spike detection (YIELD), EMA smoothed for slow/recede
    - RECEIVE exit: require sustained recede (receive_exit_s) instead of one noisy frame
    - bend: separate bend_near_dist_m=2.5 (the 1.2m near gate was unreachable: close
    range always clips -> posture disabled; self-contradictory)
    rk_control:
    - gimbal centre button now ramps (reuse drag path) instead of one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
    [gen_fake_hri.py, hri_state.py, rk_control.py]
2026-10-03 chore: pin *.bat to CRLF via .gitattributes
2026-10-03 fix(sim): drop --batch in autotest launcher (batch disables rendering -> empty recognition)
    The 88s autotest ran end-to-end but every frame had dets=[] because Webots
    --batch mode disables 3D rendering, so the camera supplied no images and object
    recognition returned nothing. Run with a window (default GUI) instead; the
    autotest still ignores the keyboard and quits by itself.
2026-10-03 chore(sim): log recognition count + owner pos + robot orientation per frame
    Diagnose why real runs report zero detections: distinguish 'camera looking the
    wrong way' from 'owner not moving' / 'recognition disabled' from the jsonl alone.
2026-10-03 chore(sim): log raw detection boxes; overwrite jsonl per run
    Sessions were appended and mixed; open the log with 'w'. Log each detection's
    raw pixel bbox so the next run shows why the width-derived distance is stuck
    (~0.57m => person bbox ~637px, i.e. nearly full frame).
2026-10-03 feat(sim): autotest observe-only by default (freeze chassis)
    User observation: the constant-speed follower (no distance hold) drove the robot
    right up against the static owner, so every frame showed a full-frame person and
    HRI never left FOLLOW; when the owner vanished the robot drove off and tunnelled
    through a wall. For HRI logic validation the chassis must stay put: autotest now
    skips follower.tick()/_drive_to_safe_target and records HRI action intents only.
    Set SIM_AUTOTEST_MOTION=1 to re-enable motion for later action-layer tests.
    Also surfaces a real product issue (missing follow distance-hold + thin-wall
    tunnelling) worth logging to [认主]/[统筹].
2026-10-03 feat(sim): geometric ground-truth detector for autotest
    Webots object recognition missed the owner at 2.5m (only fired when the robot was
    ~0.5m away), so autotest saw no person and HRI stayed in FOLLOW. Add a geometric
    detector (SIM_GEOM_DET, on by default in autotest): synthesise person/bottle bboxes
    from node 3D positions with the pinhole model (focal from camera FOV). Deterministic
    and correctly scaled; recognition remains the default outside autotest.
2026-10-03 fix(sim): anchor robot during observe-mode autotest; utf-8 logs
    Physics drift pushed the robot onto the owner even with no commands, so the
    geometric detector's depth fell below the 0.3m minimum and detections vanished.
    Pin the robot at its start pose every step in observe mode. Also write the jsonl
    as UTF-8 (Windows default cp936 broke reading).
2026-10-03 fix(sim): geometric detector uses assumed camera origin (decouple from physics)
    Teleporting the robot every step destabilised its physics (sank through the
    floor), so detections came and went. In observe mode the camera is conceptually
    at the origin; compute depth from the owner's z alone. Robust regardless of the
    robot's physical drift.
2026-10-03 fix(hri): owner-lost during RECEIVE/YIELD returns to WAIT
    feed() returned early on a missing owner, so a state that expects the owner to
    leave (RECEIVE) could stay stuck forever when the owner vanished. Mirror the
    existing HIDE abort: after owner_lost_abort_s, RECEIVE/YIELD -> WAIT ('owner
    left'). Found by the Webots autotest full-scenario run.
    [hri_state.py]
2026-10-03 sim: stabilise physics + isolated action-layer run
    - basicTimeStep 32 -> 8 (light-body contact was unstable; robot sank/drifted)
    - floor 8x8 -> 16x16 (no falling off the edge during tests)
    - skip FollowController entirely in autotest so only HRI actions drive (isolates
    the A1.3 action layer from the constant-speed follower)
    - log robot pose per frame (physics monitoring)
    - add run_autotest_motion.bat (SIM_AUTOTEST_MOTION=1) for the action-layer test
2026-10-03 sim: stable physics + working GOTO_SAFE; stop tracking temp wbproj
    - world: gimbal stages have no boundingObject (they self-collided with the body);
    body box narrowed/lifted into the wheel-top..gimbal-bottom gap; floor 16x16;
    add a low-friction rear caster (3-point support kills the slow drift)
    - controller: fix GOTO_SAFE guard (drive target was skipped) and swap the turn
    sign (robot spun in place instead of driving at the door)
    - stop tracking worlds/._autotest.wbproj (temp file Webots creates for the
    autotest world copy); gitignore it
2026-10-03 fix(gimbal): servo-safety hardening — kill large jumps everywhere
    Incident: manual center -> servo stall/current spike -> C3 de-enumerated from
    USB (uart:false, no Espressif) -> remote dead + clicking stopped until replug.
    - gaze.py: replace _wrap180 misuse on servo command angle with _clamp_pan
    (wrap could emit -145 -> clamped 0 -> full-speed slam); limits 15..165
    - rk_control: gimbal_send limits + tracks last pose; gimbal_ramp_to/
    gimbal_center_ramp (stepwise); all remaining direct jumps removed
    (/gimbal/center endpoint, gaze start/exit); gaze PAN writes via gimbal_send
    - firmware batch TODO: servoInit ramp + pulse 600-2400us
    [rk_control.py]
2026-10-03 feat(deploy): C3 USB watchdog (replug-free recovery) + freeze WiFi variant
    - deploy/c3-watchdog: script + systemd unit + README. Every 3s checks 303a:1001
    and /dev/c3_controller; after 2 misses issues 'usbreset BBB/DDD' (falls back to
    restarting rk-control). Verified on board: removing the udev symlink triggered a
    reset and it re-enumerated automatically.
    - Scope documented honestly: fixes enumeration-stuck (device still on USB); power
    loss still needs hardware (separate supply / bulk cap).
    - wifi/C3_WiFi_Controller: mark frozen / do-not-flash per owner decision (WiFi
    transport dropped; incident root cause was servo stall current, not the link).
    [C3_WiFi_Controller.ino]
2026-10-03 docs: sync READMEs with 10-03 evening results (ground recalib@112, A3.5 ts, rolling map, C3 watchdog, servo hardening, Webots sim)
2026-10-04 feat(imu): MPU heading-rate reader on KickPi I2C3 (zero-dep ioctl, 50Hz)
    - scripts/imu_daemon.py: raw I2C via /dev/i2c-3 ioctl (no smbus/deps), wakes
    MPU (0x70=MPU6500-class clone), bias calib 2s, EMA + leaky yaw integration,
    writes /dev/shm/imu.json {yaw_rate_dps,yaw_deg,gyro_raw,quality}
    - scripts/imu_start.sh helper; measured noise floor 0.06 dps, 4s drift 0.08deg
    - EXCHANGE: probe success logged; firmware batch MPU item cancelled (chip on RK)
    [imu_daemon.py]
2026-10-04 docs(gimbal): MPU section rewritten to as-built — KickPi I2C3 wiring (pin16/18), 0x70 clone, sign convention CCW-positive, reader/interface
2026-10-04 chore(world): A3.1 migrate production files into git (geometry_daemon/map/polar_mapper/calib_prod/pose_server/CALIBRATION)
2026-10-04 fix(imu): pure integration (YAW_LEAK=1.0) — leak made absolute-heading tests decay (92.5->-29.6 explained); drift bounded by bias calib, long-term needs re-zero
    [imu_daemon.py]
2026-10-04 feat(follow): IMU heading-hold in straight segments + imu.service autostart
    - follow_controller: optional yaw_rate_fn (default None = unchanged); in the
    straight deadband branch correct drift: left += k*yr, right -= k*yr
    (yr>0=CCW/left drift -> steer right). k=2.0 speed-units/dps, cap ±12
    - rk_control: _get_yaw_rate() reads /dev/shm/imu.json with 0.5s freshness gate
    (stale/missing -> None -> open-loop fallback, safe)
    - scripts/imu.service: systemd autostart for imu_daemon (enabled+active on board)
    - scripts/test_heading_hold.py: sign selftest PASS (0/±5/None cases)
    [follow_controller.py, rk_control.py, test_heading_hold.py]
2026-10-04 feat(world/pose): calibrated offering rule (2/3 elbow-extension-wrist), P/N datasets, clean-frame lesson
2026-10-04 fix(hri): real-machine RECEIVE works — side-carried bags, owner continuity, v clamp
    Real A1.1 runs with a shopping bag revealed three issues, all fixed:
    - held-object region was upper-55% only, so a bag carried at the side (the
    realistic shopping case) never counted. Named classes (handbag/backpack/
    suitcase/teddy bear/...) now match anywhere inside the owner box (area<=0.6x);
    the class-agnostic channel stays strict (upper 45%, area<=0.3x) so scene
    objects (chair/potted plant) are still rejected.
    - two person detections caused owner flicker -> width/centre jumps -> absurd
    approach speeds (6-8 m/s) and YIELD flapping. Owner pick now prefers the
    candidate nearest the previous own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
    [hri_state.py]
2026-10-04 fix(hri): A1.1 passed — disable generic channel, 2-frame YIELD confirm
    Final real-machine acceptance: FOLLOW->WAIT->RECEIVE(handbag)->WAIT->RECEIVE
    (handbag)->WAIT->YIELD(1.48)->WAIT, zero scene false positives, single YIELD.
    - disable the class-agnostic held channel (it fired on bird/cell phone); the
    curated class list (bag/teddy/bottle/cup/food/handbag/backpack/suitcase) covers
    the demo props and is far more predictable.
    - YIELD now needs raw speed >= threshold for >=2 consecutive ticks AND smoothed
    speed >= 0.6x threshold, killing single-frame width-noise spikes.
    - owner continuity pick + +-2.5 m/s clamp (from previous commit).
    Verified with the shopping bag at three carried posit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
    [hri_state.py]
2026-10-04 feat(hri): A1.2 owner-lock consumer (cross-process owner box)
    The frozen interface owner_score(person)->float was never implemented; owner_id.py
    exposes OwnerProfile.score_box/select_target with an in-memory profile, so a
    separate HRI process cannot see it.
    Add an 'owner' source: source=file reads /dev/shm/owner.json = {ts,bbox} (writer
    = [认主]/rk_control follow path) and matches the detection whose bbox overlaps it
    (IoU>=0.2, ts<1s); stale/missing -> fall back to highest-confidence person (current
    behaviour). Default source=none: zero change until the writer ships.
    Unit-tested: with a fresh owner box the lower-confidence true owner is picked even
    when a higher-confidence bystander is p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
    [hri_state.py]
2026-10-04 feat(gimbal): /turn heading-closed-loop endpoint (IMU-gated) + side-torque diagnostic script
2026-10-04 test(world/pose): offering validation datasets v1/v2 from board runs
2026-10-04 docs: main README roadmap + battery/torque known-issue + IMU heading-hold; decision README IMU note
2026-10-05 feat(sim): dual-person owner-lock (HRI A1.2) + sector_scores HIDE validation in Webots
    - world: add DEF PASSERBY (blue, distinct recognitionColors) for dual-person scenes
    - controller: geom detector gains lateral pinhole projection so two persons'
    boxes actually separate; simulated follow publishes owner.json {ts,bbox}
    mirroring follow_controller._publish_owner (0.2s rate limit, atomic replace);
    HRI consumes it via the unmodified owner.source=file path; grid snapshot now
    embeds real sector_score.score_map output; passerby keyboard controls
    (arrow keys / P); frame log keeps boxes as [label,bbox] list + ownerbox +
    passerby; restore observe-mode robot pin (b5a0d78) - macOS physics s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
2026-10-06 feat(sim): corridor demo scenario end-to-end + docs/DEMO_PLAN.md
    - world: dorm corridor (dorm door / end water dispenser / next-door fridge /
    bench); chassis is now kinematic (no physics node) - macOS solver injected
    ghost forces into the stationary/spinning body (creep, launches, arc
    anomalies); controller integrates differential-drive kinematics from the
    C3-style commands, protocol semantics unchanged
    - controller: sim-only follow keep-distance (~2.6-3.0m, ground-truth gated,
    active STOP brake); owner.json lock publishing moved to the main loop
    (mirrors the real follow process); geom detector uses true body pose +
    lateral pinhole projection, min depth 0.15 for close handover;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
2026-10-07 feat(world): HIDE 亲和度打分五条增量规则 (CLASS_W/硬禁区/门状态/朝向锥/时段)
    - CLASS_W: 类别→权重表 (驻留预测/易碎/商场类), YOLO-World 开放词汇即接口面
    - HARD_MASK_CLASSES: 硬禁区剔除出 best 候选 (安全=硬约束, 社交=软分数)
    - DOOR_STATE_W: 门状态化 ajar>closed>open (打分对象=不可预测性)
    - persons[].facing_deg 朝向锥 (gaze/blind) 与 hour_bucket 时段桶
    - 新字段缺席时与旧版逐字节一致, legacy 输入三组对比 PASS
2026-10-07 docs(world): 雷达×HIDE 亲和度打分场 §13 + 文献地图与逛街场景扩展 §13.7
    - §13: 雷达逐条喂饱打分场的规则对照/架构提升/执行闭环/边界/研究点/集成方式
    - §13.7: 增量规则入码记录 + 指针到新文档
    - AFFINITY_SCORE_LITERATURE.md: 计算先例(Sisbot T-RO 2007/Mead&Mataric 2016/
    Rios-Martinez IJSR 2015)+HRI 民族志(Forlizzi&DiSalvo/Kuno CHI 2007)+
    人类学理论(Hall/Goffman/Altman/Kendon/Hillier/Alexander)
    - 逛街场景: 商铺界面/硬禁区/动线/时段四组打分点 + 规则迁移洞察
2026-10-07 chore: V2 布局 CAD 源文件入仓 + 忽略 .graphflow/ 本地状态
    [SC_V2_layout.f3d]
2026-10-07 fix(camera): stable /dev/camera0 udev symlink + --camera accepts device path; rk_control video URL uses location.hostname
    [rk_control.py]
2026-10-07 docs(demo): 统筹裁定 — gimbal fixed by default (servo deferred), h as emergency-stop only, distance-source priority
2026-10-07 docs(v2): positioning as post-demo research platform + camera-vs-lidar controlled experiment; add Phase C7 to semester plan
2026-10-10 docs(packaging): three-track packaging plan (portfolio / research / patent-product)
2026-10-10 fix(hri): lower approach_slow_mps 0.15 -> 0.06 (handover too slow to pass)
    Windows Webots demo runs showed the handover reaching HIDE->RECEIVE never fired:
    held=bottle was present but the width-derived smoothed approach speed read
    ~0.14 m/s, just under the 0.15 slow-approach floor, so 'slow' stayed false.
    Lower the floor to 0.06 m/s. Verified: 3/3 Windows demo runs now go
    FOLLOW->WAIT->HIDE->RECEIVE->WAIT->FOLLOW with session_end ~98-100s.
    [hri_state.py]
2026-10-10 docs(v2): §14 dark-mode degradation ladder + sensor division of labor (safety/presence/coarse-localization vs identity/semantics)
2026-10-10 docs: add V2/V3 development roadmap (V2 = full hardware + release; V3 = firmware-only local world + multi-person; no SLAM/cloud, SLAM moved to PC track)
2026-10-11 feat(sim): robustness suite — 6 scenarios + phantom injection, fix dead sonar & occlusion-blind detection
    - 虚拟声呐: Webots sonar 设备在本世界失效(1923帧恒200, 自测直冲端墙无读数),
    改几何真值 5 射线(±10°)求交, 超声急停行为首次可在仿真验证
    - 几何真值检测加高度感知遮挡: 路人横穿真正挡住主人框, owner lock 首次被考验;
    0.5m 长椅挡声呐但不挡 1.66m 视线
    - SIM_SCENARIO 七场景: baseline/cross2/occlude/bench_block/hide_occupied/
    handoff_cross/phantom(幻影注入, 复刻宿舍夜景 95/98 帧失败模式)
    - run_robustness.sh + analyze_robustness.py: realtime 逐场景自动判定, 6 场景 5 PASS
    - 三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
2026-10-12 fix(hri): phantom-proof owner selection (freeze on stale lock + centre match)
    Root cause (per 统筹 10-12, sim §18.5): when owner.json went stale, _pick_owner
    fell back to the highest-conf person, so injected phantom persons got adopted and
    polluted sm_cx/sm_w/approach_mps -> static timer reset -> no HIDE/RECEIVE. This is
    the sim reproduction of the dorm night phantom failure.
    Fixes:
    - source=file: if the owner lock is missing/stale, adopt NOBODY (return None) for
    every state -- 'rather not move than pick the wrong person' (机主原则 L2). The
    conf fallback is now only used for non-file sources.
    - lock matching switched from IoU to nearest-centre (<=140px): lock and detection
    boxe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
2026-10-12 test(sim): move SPOT_B to a different sector for hide_occupied (per 世界 plan 1)
    SPOT_B (1.05,-3.6) sat only 14.8deg from HIDE_SPOT at the HIDE decision pose
    (same 45deg sector), so a sector-level scorer could never switch away from the
    occupied spot. Move it to the far left-wall corner (-1.15,-5.5): ~51deg from
    HIDE_SPOT, 2.46m away, clear of fridge/doors. NOTE: the v6 run still did not pass
    - HIDE fell back to the door heuristic (116.76deg) => sector_scores was not
    confident with the new spot; also HIDE aborted on owner-lost. Handed back to 世界.
2026-10-12 test(world): corridor repro regression (T14/T14b) — free spot sharing sector with appliances is correctly refused
2026-10-12 test(sim): SPOT_B -> (-1.2,-4.14) sector7 clean; hide_occupied PASS
    世界 root-caused the v6 failure: my (-1.15,-5.5) spot sat in the same sector as the
    water dispenser/fridge (both ~-16 to +4 deg, sector 0) so the scorer correctly
    refused it. Their suggested (-1.64,-3.87) is outside the corridor walls (|x|>1.4);
    adapted to (-1.2,-4.14): bearing ~-30deg -> sector 7 (no door/appliance), 1.94m
    from the robot, clear of the fridge, sightline to the owner OK.
    Windows: hide_occupied PASS (HIDE sector_score 1.00, parks 1.99m from the occupied
    spot). Full suite now 8/8 PASS.
2026-10-14 feat(follow): bounded backup-to-search when owner lost (chassis backs up a little to re-find, not gimbal-only)
2026-10-14 fix(gaze/follow): disable gaze for demo (single steering controller; bearing_fn was never wired) + damp backup-on-lost flicker
2026-10-14 audit(world): bearing sign-chain audit (mismatched left/right-positive conventions) + offline convention test + health_check (age/fps/restarts)
2026-10-14 fix(infra): self-healing video pipeline (camera USB dropout) + dnsmasq DNS self-loop; add health_check.sh
    Problem 1 (vision pipeline instability -> no detections):
    - Root cause: USB camera (0c45:6366) had power/control=auto (autosuspend 2s) and
    re-enumerated ~every 5min (dmesg: usb 7-1 disconnect/reconnect, node drift
    video10/11/12). The producer's VideoCapture kept a deleted /dev/videoN fd, so
    cap.read() blocked forever -> producer stopped feeding -> daemon went silent ->
    consumer blocked on stderr readline -> watchdog thrashed restarts every ~6s
    (restarts 22+, <defunct> zombie) -> detections dead (age 120s+).
    - Fix: configs/99-shadowcarrier-camera.rules adds ATTR{power/control}="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
2026-10-14 feat(world): perf_probe.py — RK3566 NPU/CPU/IO attribution probe (dominant-bottleneck verdict)
2026-10-14 fix(infra): camera-usb-fix poller service (keep camera power/control=on) + health/README
    udev ATTR{power/control}=on works on an explicit udev add trigger but not on the
    deauth/re-auth (re-enumerate) path; RUN+/usbcore.autosuspend=-1 are likewise
    unreliable there. Add deploy/camera-usb-fix/ (root poller, same pattern as
    deploy/c3-watchdog/): scans USB every 2s and writes power/control=on for
    0c45:6366 whenever it reverts to auto. Verified: after a forced re-enumerate,
    power/control is back to on within 1s and the video pipeline recovers
    (restarts stays 1).
    - health_check.sh: include camera-usb-fix in service list.
    - configs/99-shadowcarrier-camera.rules: clean best-effort rule (symlink + AT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
2026-10-14 perf(follow): control loop 2.5->10Hz, BASE 100->130/MIN 60->80/ARC_SLOW 70->90; tick-constants -> dt-timed (rate-agnostic, protects Webots 0.3s cadence); EMA dt-normalized; dist_fn injection point; r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
2026-10-14 fix(imu): re-zero stability gate (统筹10-14审查) + drop dead owner_bearing (world audit) + sign-contract docs
    - imu_daemon: 重零块加 if stds[2] < STAB_MAX_RAW 才采用(车在动时拒绝, 保留旧零偏)
    - rk_control: 删除 owner_bearing/bearing_fn 解耦死代码(混'左正/右正'约定, 最高差41°;
    统筹裁定'接线或删'→删; 注释保留正确公式与自检入口)
    - decoder.py: 修文档自相矛盾(旧docstring写'世界右侧'/正文写'物理左侧')
    - gimbal/README: 新增'坐标符号契约'表(世界=右正/IMU=左转正/换算公式/权威自检)
2026-10-14 fix(follow): distance-keep v2 (graduated bbox slow+stop backstop; real-distance when dist_fn wired) + search-back 0.4s confirm; update regression test
2026-10-16 feat(follow,lidar): 底盘转向通道(原地转/掉头搜索) + 雷达避障备好 + 仿真诚实化
    今日两条线合并为一个可回退快照。与既有环境隔离的安全默认值见末尾"隔离"段。
    A. follow 底盘转向通道 (云台冻结期, 2026-10-16)
    - follow_controller: 相 TRACK/TURN/BLIND/SEARCH; 入口 E1 预测式(TTE<0.35s 且 |ω_世界|>40°/s
    连续 2 帧, 自身大幅旋转时不判) + E2 贴边兜底(|θ|≥30° 持续 0.3s); 出口 15° 迟滞 + 0.25s 驻留;
    盲转有界(纯预测 60°/弱线索 150°)防"按陈旧 θ̇ 转过头"; SEARCH 朝出画侧 90° 一档+0.5s 停顿,
    累计 180° 后进等待; 方向反转看门狗(5s>3 次→强制回弧线)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
2026-10-16 feat(owner): passby anti-drift lock-confirm gate — non-contiguous candidates need 3/5 consecutive frames (5 when opposite to exit side), score>=SCORE_MIN+margin; no owner.json/KF/strong-evidence unti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
2026-10-16 fix(hri): HIDE 不再因主人出画中断回 FOLLOW (风险4b) + 发布 HRI 状态供 turn_only 门控
    - 有限 FOV(±32°)下主人出画是 HIDE 期常态; 旧逻辑 owner_lost_abort 后
    HIDE->FOLLOW(扫掠中断) 造成状态抖动并错过 RECEIVE。按 S-W-R 改为
    "停在可被找到处等待", 只有 RECEIVE/YIELD 中丢主才回落 WAIT。
    分支 feat/turn-channel 复现: 原版 baseline FAIL(缺 RECEIVE), 修后 PASS。
    - hri_state 每 0.1s 原子发布 /dev/shm/hri_state.json {state,action,parked};
    - rk_control 跟随环: 停驻域(WAIT/HIDE) 改调 fc.tick(turn_only=True),
    版本不支持时 TypeError 回落 fc.tick() → 主分支零行为变化。
    - 分支诚实 passby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
2026-10-16 fix(hri): RECEIVE 放行"近距站定持物"(修 hide_occupied 永不触发)
    问题: HIDE/WAIT 里 held_go = held and slow, 要求主人 v_sm>=0.06 慢速接近。
    回退停靠点 SPOT_B 离剧本交接点仅~1m、且在车停稳前主人已走完接近段, 抵达时站定
    (v~0) -> 永不 RECEIVE。v7 曾过只是 v_sm 恰好擦过 0.06 阈值(抛硬币)。
    改: held_go = held and (slow or (dist<=near_dist_m 且 static_now))。
    只放宽"近距静止", 远距仍必须 slow; 配合 owner 锁/_dwell_ok/cooldown 防误收。
    验证:
    - Windows 主分支全套 8/8 PASS (baseline/cross2/occlude/bench_block/handoff_cross/
    hide_occupied/phantom_s7/phantom_s8), hide_occupied 稳定 PASS(RECEIVE 2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
2026-10-16 docs(arch): 分层契约图 + 边界表 + 冻结接口（统筹 10-17 00:41 裁决落地）
    四问四层: 云台=读数 / 世界=哪好 / HRI=干嘛 / 运动控制=怎么动; 认主(谁是他)、
    基建(链路活着) 横切。含冻结接口表(owner.json/api:detections/grid.json+sector_scores/
    hri_state.json/imu.json/UART)、两条易混边界(passby/hide_occupied 实例)、
    V1冻结+V2重切云台计划、术语消歧(运动学/方位/距离)、线名↔模块。
2026-10-17 docs(v2): camera case verdicts + odometry/dual-IMU + resolved sim findings
    - CAMERA_SELECTION: 实拍案例判定——IMX307 MIPI ¥83.88 不可用(驱动/1m排线/云台走线
    三硬伤); 微雪 OV2735 USB 96° ¥76.63 可买(核对对角vs水平/格式表/曝光控制); 线走
    桅杆背面落在既有遮罩角内, 零新增雷达遮挡
    - 设计文档 §22: 里程计(码盘+IMU航位推算→幻影的位置连续性过滤; 漂移量级) + 双 IMU 分层
    原则(底盘/云台各配各的参考系, 先测量后闭环; 混帧/混时基/乱信任才是打架来源)
    - §18.2/18.3 更新: hide_occupied 已由上游 CLASS_W person + _pick_owner 冻结 + lock_gate
    修复并回归 PASS; 清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
2026-10-18 feat(manual): IMU heading-hold for teleop forward (DIFF yaw-P, reset on turn/stop) + forward 180->220, follow BASE 130->150
2026-10-18 perf(speed): match follow to manual under cargo-box load — BASE 150->220, MIN 80->120, PIVOT 110->190; manual F/B 220->240, L/R 150->190
2026-10-18 fix(follow): gate bbox near-stop/slowdown to front cone (offset<=100px) — passby no longer stops at ~30deg when person is beside
2026-10-19 fix(follow): 离线审查四修 — 高度门永久冻结 / 退出用冻结KFθ / 入转即翻向 / 近距off-axis无保护
    对 COORDINATION_REVIEW §5 的"实机瓶颈"做离线部分（不涉硬件、全部带回归断言）。
    三个真 bug（都由"
    PIVOT_PWM 110→190 后更快转速"放大暴露）:
    1. 框高突变门会**永久冻结** EMA: H_CHANGE_LIMIT=0.3 的跳变门在高度持续变化时
    (人走近 300→450) 永远满足 → scx/sh 再也不更新, 车保持旧方向。
    → 连续 H_CHANGE_CONFIRM_N=3 拍确认后**重新播种**(单帧异常仍忽略)。
    2. 退出原地转用的是**会冻结的 KF θ**: 174°/s 下卡方门整帧拒绝 → θ 冻在 31°,
    几何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
2026-10-19 docs: 封存 V1 近距安全余量到 V2 (机主裁定) —— V1 只要求能动起来
    - DEFERRED_WORK §3 新增一行: 制动模型推导 NEAR_STOP_M + 载重启动阈值标定(--stall)
    demo 期不做, 解封到 V2 (编码器闭环/雷达 range_m 上线后)。
    - README / DEMO_PLAN 同步该裁定, 避免以后被当漏项。
    - 注: 10-19 已落地的兜底(偏轴速度门 + 正前框高门 + 地面测距)不变, 不再改 V1 速度和阈值。
2026-10-19 docs(deferred): 撤回'主人≥2m外侧绕过' —— 走廊横向余量只有0.8–1.5m, passby 靠机制不靠编排
    2.5m 是纵向跟车距(FOLLOW_KEEP_MIN_M), 不是横向余量; 2.5m 宽走廊两侧墙在 ±1.25m。
    真实 passby: 横向 0.8–1.5m, 头不入画(需≥2.07m)但躯干可见, 腿-only 约 <0.8m。
    → 转向通道保画面 + 弱线索接管腿段; 近距余量仍按裁定封存 V2。
2026-10-19 docs(review): v2 — world solutions 2025-26, real-robot gap corrected to unwired demo chain, 12-day plan
2026-10-20 docs(v2): 修正电池电流规格——持续 ≥5A / 过流保护 ≥10A（§21.11 真实电流预算）
2026-10-20 docs(v2): 航模包/成品包/磷酸铁锂 的技术与安检权衡（§21.12）
2026-10-20 docs(v2): 实拍案例——3C 12V 2.55Ah 成品包合规但动力不足（§21.13）+ 地铁安检口径澄清
2026-10-20 docs(v2): 电池怎么找——BMS/XT60/容量三硬指标 + 搜索词 + 电动工具电池包方案 + 电赛惯例（§21.14）
2026-10-20 docs(v2): 电流需求再校准(巡航1-2.5A)→5100mAh 3C 包为推荐档; 10200mAh 超100Wh 不推荐
2026-10-20 docs(v2): stage-1 分阶段供电——两块便宜包/工具电池顶到赞助到位（§21.16）
2026-10-20 docs(v2): 廉价 DIY 电池组配置评估——3S2P 5000 电机包 + 3S 3000 云台包, BMS/电芯一致性为决定性条件（§21.17）
2026-10-20 docs(v2): stage-1 电源选型与接线落地（§21.10–21.32）
    - 集成 DC-DC 评估(不推荐固定双路板; 3.3V 由 S3 自带)、电池电流真实账(持续 5A/过流 10A)
    - 航模/成品/磷酸铁锂权衡 + 地铁安检口径；3C 2.55Ah 实拍判定(合规但动力不足)
    - 电池找法: BMS/XT60/容量三硬指标、搜索词、电动工具电池包方案、电赛惯例
    - stage-1 分阶段供电、DIY 配置评估(3S2P5000+3S3000)、充电器统一(全 3S)
    - 电压地图、MG996R/MG966R 无回读、DC5521 载流修正、BMS≠接口、剪线改接调查
    - 两包分带(每包2电机)、5A 包可用性、续航账(实际 2–4h)、三包对采购/洞洞板的改动
2026-10-20 docs(hri): 短时遮挡 vs 持续失联分层（DEFERRED_WORK §1.4）+ 重逢边界澄清（RESEARCH_POSITIONING）
    - 短时视觉缺失: 身份连续性/预测只用于认回同一人, 不授权前进; 3帧(反向5帧)确认, 2.4s停车
    - 持续失联: 热点/手环仅为 owner_nearby() 布尔; V2 App 作可选辅助通道(心跳/时间戳/可选位置+误差); V3 才做信念驱动重逢
    - 重逢(After)边界: 仅指主人重新进入视野并通过认主后的基础恢复; 视野外主动找回属 V3/Phase C
2026-10-20 chore(infra): health_check covers hri-state + geometry-parked.timer (Sprint-1 P0)
2026-10-20 feat(motion,infra): T4 passby tooling + atomic frame write + enable TURN_ENABLED; T0b/T4 runbook
    - video_stream_v7 (v7.4): write yolo_frame_a/b atomically (tmp.jpg + rename).
    Old direct cv2.imwrite raced with yolo_daemon/owner_id.read_recent_frame ->
    partial JPEG ('Premature end of JPEG') -> detection/enroll hiccups, which hurt
    T4 bbox continuity. Adds stats.frame_write_fail.
    - passby_record.py / passby_analyze.py: 10Hz recorder (owner.json/detections/imu/
    hri_state) + analyzer (lock rate, longest gap, suspected identity switch,
    rough heading consistency) so the 12 T4 runs are measurable.
    - follow_controller: TURN_ENABLED False -> True for T4 (inert in manual mode;
    revert by sett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
2026-10-20 feat(ui): web test console at /test (T0b pivot + T4 passby record/analyze + health) for cable-free testing
    - rk_control: add GET /test (serves test_panel.html), /passby/start|stop|status|list,
    /healthz; recorder runs in a thread via passby_record.record(); stop runs
    passby_analyze.py and returns its report. Recordings go to ~kickpi/hri_logs.
    - scripts/test_panel.html: standalone mobile page (mode switch, T0b pivot buttons,
    T4 record with live lock-rate, analysis output, health snapshot, optional video).
    - main page: add a '测试台' link.
    - passby_record: expose record(path, stop_event, ...) for embedding.
    - runbook: document the hotspot URL http://192.168.4.1/test.
    Verified on board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
2026-10-20 feat(ui,obs): web log browse/download + retention; follow_status stop telemetry; persist daemon log
    - rk_control: /logs/list, /logs/get (download), /logs/tail; prune passby/hri
    jsonl logs to last 200 files / 30 days on each recording start.
    - follow_status.json (10Hz, atomic): {state, cmd, offset, lost} side-channel from
    the follow loop; /healthz exposes follow + ultrasonic obs. Recorder logs
    follow_cmd; analyzer auto-computes stop episodes (>=0.3s, fail >1.0s) when the
    data is fresh. This automates the T4 'stop <= 1.0s' acceptance.
    - video_stream_v7: daemon diagnostics now persist to ~/hri_logs/yolo_daemon.log
    (was /dev/shm, lost on reboot); skip high-frequency [stage] lines.
    - te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
2026-10-20 feat(ui): web-ify T0/T1/T2/T3/T6/T7/T8 + HRI timeline (统筹 23:58 assignment)
    - T0: /test/t0 (+?dry=1) one-click PING->MOVE F->STOP->MOVE L->STOP; forces manual,
    bounded pulses, auto STOP; UI asks for confirmation.
    - T8: /test/t8 (+?dry=1) F/B/L/R/STOP pulses with send timestamps; physical response
    is visual (no ack). /test/stop aborts; /test/status polls.
    - T1: /test/t1 returns enroll samples (parsed from own journal), owner.json age/bbox,
    template; read-only.
    - T2/T3/T6/T7: scenario selector + label in the recorder; analyzer prints label and
    warns that thresholds are T4-oriented for non-T4 scenes.
    - T9/T10: analyzer prints HRI state/action/parked transition timeline (display only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
2026-10-21 feat(motion): heavy-load speed/torque profile + runtime tuning (/motion/config + panel 7)
    Owner: car got heavier; open-loop PWM base torque/speed insufficient.
    Heavy-load defaults:
    - follow: BASE_SPD 220->245, MIN_SPD 120->155 (inner wheel stalls under load),
    PIVOT_PWM 190->240, YAW_CORR_MAX 12->16, BACK 85->110, SEARCH_BACK 70->95;
    dist_fn forward cap 240->255.
    - rk_control: MANUAL_FWD_SPD 240->255, TURN_DIFF 40->60, ARC 100/90->140/120,
    HRI APPROACH/BACK 80->120, GOTO 90->140, GOTO_TURN 110->220; /turn default 110->170.
    - /motion/config (GET/POST): runtime apply + persist to ~/hri_logs/motion_tune.json,
    loaded on startup. follow_controller reads module globals per tick -> applies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
2026-10-21 fix(follow): full-time IMU yaw-rate loop (was gated to +/-50px deadband) + tests
    Owner: manual forward is straight, but follow weaves/drifts. Root cause confirmed:
    the IMU heading hold lived inside 'if abs_off <= DIR_DEADBAND (50px)', so during
    most of following (person off-center) the arc branch was pure-P with no IMU
    feedback -> wheel mismatch/load bias -> arcs/serpentine; bbox offset mixes person
    motion and chassis heading, so it cannot reject drift alone.
    Fix: continuous yaw-rate cascade for the arc/straight path:
    w_des = 0 at center; proportional to (|offset|-deadband) when off-center
    e = w_des - yaw_rate(IMU); corr = YAW_K*e -> differential
    corr>0 => more CCW => right wheel fast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
2026-10-21 fix(c3-watchdog): event-based logging + absent snapshot; document native-USB replug issue
    - Watchdog: log present/lost transitions; when C3 is fully absent, log once per
    60s (was every 6s) and append an lsusb -t + dmesg snapshot for diagnosis.
    Still cannot reset a device that is not on the bus (documented boundary).
    - README: research note (2026-10-21): the 'must replug' symptom is a known
    ESP32-C3/S3 USB-Serial-JTAG behavior (C3: D+ stays pulled up in light sleep so
    the host may not re-enumerate; S3: DP/DM muxed to JTAG at power-up; ttyACM is
    the MCU so resets always drop the port). Charge-only cables are a separate
    cause. S3 guidance: prefer a USB-UART bridge (ttyUSB) for the c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
2026-10-21 docs(c3-watchdog): record the RK3566 board-level USB enumeration/power history
    Owner pointed to the old pitfall log: the repeated replug is not just the C3/S3
    native USB; the RK board's USB host is a documented weak link.
    - communication/README: RK UART no TX -> CH340 OHCI crash -> CP2102 crash ->
    AP6255 WiFi incompatible -> USB direct works but cold-start often not enumerated.
    - gimbal/README (10-03): 'amplifier = board-level: C3 USB does not re-enumerate
    after power loss'; falsification test: if it still drops after hardware swap,
    the board-level enumeration defect exists independently.
    - EXCHANGE 10-14: C3 (bus5 OTG/DRD) and camera (bus7 host) share USB2 PHY/power.
    - V2 19.5/19.6: c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
2026-10-21 feat(c3-watchdog): replug-free xHCI deep reset when C3 is absent
    Verified on the board: C3 is on xhci-hcd.4.auto (usbdrd/fcc00000.dwc3, bus5,
    OTG/DRD); camera is on xhci-hcd.5.auto (usbhost/fd000000.dwc3, bus7). Unbinding
    bus5 removes the C3 (camera stays); rebinding re-enumerates the C3 within ~1s
    and ttyACM0 returns, camera unaffected (fps 14.4/age 10ms).
    Watchdog now: after C3 has been absent for 30s (cooldown 60s), unbind/bind the
    C3's xHCI controller automatically -> replug-free recovery for the common
    'enumerated lost but device powered' case. Truly powered-off devices still need
    a switchable VBUS/hub (documented).
    Also: event-based present/lost logs, absent log every 60s + lsusb/dme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
2026-10-21 feat(c3-watchdog): optional VBUS power-cycle hook (GPIO / uhubctl / custom cmd)
    Recovery ladder: usbreset (enumerated but broken) -> xHCI unbind/bind (absent but
    powered) -> optional VBUS power cycle (truly powered off). Backends, configured
    via a systemd drop-in:
    - C3_VBUS_GPIO + C3_VBUS_ACTIVE (sysfs GPIO -> MOSFET/load switch)
    - C3_HUB_LOC + C3_HUB_PORT (uhubctl per-port power)
    - C3_VBUS_CMD (custom shell command)
    No config -> skipped (watchdog keeps xHCI deep reset only). Adds
    --selftest-vbus to run the hook once.
    Verified on board: selftest hook ran via a dummy C3_VBUS_CMD; normal restart logs
    'vbus=no' and C3 present; C3/camera unaffected. Not pushed (left to 统筹).
2026-10-21 docs(playbook): 实地试验应急预案 —— 分级降级/故障树/专项镜头/事后归档
    补上 DEMO_PLAN 引用但从未存在的 RECOVERY.md（现指向本文）。面向 demo 前每次实机试验:
    - §0 角色与五条安全红线; §1 60 秒速查(停/切手动/体检); §2 L0-L3 分级
    - §3 诚实交底三条: 转向通道实机默认关 / 停驻转头依赖不存在的 HRI 服务 / 雷达惰性直通
    - §4 每日开工检查单(六服务+相机+检测+热点, 手动四向点动, 标定, 认主)
    - §5 故障树 A链路/B决策/C行为/D安全/E数据, 每行症状-判断-处理-回退
    - §6 专项镜头: passby(横向0.8-1.5m, 默认行为会卡住→预案A/B) / 递物必须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
2026-10-21 docs(v2): 手机相对定位 + 无地图导航（机主原始设想：共享定位找彼此，无 UWB）
    新增 docs/V2_PHONE_RELATIVE_NAV.md，按【锁人】【世界】两线拆分，存 V2:
    - 核心: 分离点=共同原点, p人-p车 = 初始相对向量(视觉) + [Δp人(PDR) - Δp车(IMU)], 不需绝对定位/地图
    - 三类'不在视野': (a)侧后方物理可见→雷达360°转头; (b)被墙挡→移动搜索/等; (c)跨区域→需定位+地图(V3)
    → UWB 只在 (c) 有价值, 而 (c) 不在 V2 范围
    - 锁人线: 手机=软标签(被动上报)/心跳提速/负向身份门/盲区PDR桥接/间歇视觉修正;
    相机模板仍是唯一可放行平移的身份证据
    - 世界线: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
2026-10-21 docs(v2): 重逢树 v2 —— 用 rendezvous search 理论 + HRI 实测参数重写
    三处被文献直接改写:
    1. '原地等'不是默认最优 (Gal 1999: 全程静止永不最优; 仅当'人 guaranteed to return'时理性)
    → 树的第一分叉改为'返回先验'
    2. 有界搜索改为'锚定扩张(doubling, 1→2→4m, 每次回锚点)': 距离未知时 9-competitive
    (Ozsoyeller & Tokekar arXiv:2101.05324)
    3. 离散点模型最优 = '留一方 + 巡游其余' (Alpern & Gal 2003 ch.16) → 新增 B' 必经点巡游分支
    且巡游方应该是车 (人的路径可预测)
    HRI 实测参数(带 N):
    - 跟丢后等待中位数 2.4s(SD 3.79), 84.6% 偏好 5s 而非 10s 播报 → 状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
2026-10-21 fix(turn): proportional slow-down near pivot target; expose MAX_OFFSET
    Owner measured 3-4 deg overshoot on /turn_pivot. Root cause: the 0.1s loop at
    ~174 deg/s moves ~17 deg per tick, so holding full PWM until |err|<TOL always
    carries past the target. Pivot now uses
    spd_eff = clamp(TURN_P_GAIN*|err|, TURN_MIN_SPD, spd)
    with TURN_P_GAIN=8, TURN_MIN_SPD=130, TURN_TOL_DEG 3.0->2.5. DIFF /turn path
    unchanged. Also add MAX_OFFSET to /motion/config (arc large-signal gain tuning).
    All 9 offline regressions green. Not deployed yet (owner is mid-test), not pushed.
2026-10-21 feat(ui): runtime TURN_ENABLED toggle + analyzer startup skip
    - /motion/config accepts TURN_ENABLED (bool); panel 7 gets 'T2 baseline: off'
    / 'T4 passby: on' buttons. Matches FIELD_TEST_PLAN: T2/T3/T6/T7 arc-only,
    T4 passby uses the turn channel. (Requires rk-control restart to go live.)
    - passby_analyze: --skip (default 1.5s) excludes the startup segment; prints both
    raw and steady-state lock rates. Latest T4 run: raw 80.9% -> steady 94.9%,
    max gap 0.30s, 0 switch, stop 0.30s -> all automatic criteria pass.
    - passby_analyze is deployed (no restart needed); toggle panel awaits restart.
    Not pushed (left to 统筹).
2026-10-21 fix(test): T0/T8 real motion requires POST (default dry-run); record heavy-profile ruling
    Per 统筹 13:37 safety note: GET /test/t0|t8 now always dry-run (returns steps,
    no motor command). Real motion must be POST; body defaults to dry=true, the UI
    sends {dry:false} only after its confirm dialog.
    Also record the owner's 2026-10-21 heavy-profile approval in DEFERRED_WORK
    (overrides the 10-19 'no BASE_SPD changes' for speed only; NEAR_STOP_M stays).
    Not deployed yet (needs rk-control restart), not pushed.
2026-10-21 feat(obs): record ultrasonic blocked/cm + follow cmd/val; analyzer OBS summary
    - follow_status.json now includes obs_blocked/obs_cm (from the C3 ultrasonic state).
    - passby_record logs follow_val + obs_blocked/obs_cm.
    - passby_analyze prints ultrasonic blocked % and median cm, so a small-space
    failure can be attributed to identity loss vs obstacle stop vs commanded stop.
    - rk_control change takes effect on the next restart; recorder/analyzer deployed.
    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
2026-10-21 feat(follow): leg-follow prototype (default OFF) per 统筹 ruling A
    Only when LEG_FOLLOW_ENABLED and a recent strong lock (<=3s) exists, and the
    external hard gates pass, the leg-band direction maintains a slow forward arc:
    - controller gates: TTL 3s, direction within +/-25deg of last owner bearing,
    leg-center jump <=120px, leg lost <=0.4s (hold, then STOP), speed 120-140,
    never initiates / no owner.json / no KF / no template update.
    - rk_control._leg_follow_cue hard gates: mode=follow, HRI state=FOLLOW (fresh),
    exactly 1 person, OBS valid and >35cm, dist>=0.7m, leg score>=0.35.
    - Runtime toggle via /motion/config {LEG_FOLLOW_ENABLED:0|1}; panel 7 button.
    Default False; enablement s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
2026-10-21 feat(ui): redesign test panel — sticky status strip + 4 tabs, less clutter
    - Top sticky bar: mode pill + 手动/跟随/急停 + live strip (fps/age/C3/OBS/HRI).
    - Four tabs: 跟随 (T2/T3/T4/T6/T7 recording + video), 标定 (T0/T8/T1 + pivot),
    健康 (health + logs), 调参 (speeds/gains + turn/leg toggles).
    - Advanced/raw JSON/logs/analysis are in <details>; no giant JSON on screen.
    - Video loads only when its <details> is opened (saves bandwidth).
    - T0/T8 POST with legacy GET fallback, so the page works before the next
    rk-control restart.
    - JS syntax checked (node --check). Not deployed (board unreachable / on AP).
2026-10-21 fix(leg-follow): safety gates (0.6m travel cap, single leg-band candidate, area-growth reject) + tests 8/8; docs: V1/V2/V3 owner-line version map
2026-10-21 fix(world,hri): HIDE 落点=远离门 + 生产打分接入 objects + 路中间改连线中点
    - hri_state.pick_safe_spot: 回退 打分->自由(避开门±45°)->背离门(旧版朝门走); 修 dict free_sectors TypeError
    - geometry_map.summary: 增 objects[] (旧版缺失 -> 生产里 person/家电/硬禁区/path 全空转)
    - sector_score: 路中间改距离感知连线中点 (dist_valid 才用, 否则退回角平分线并标注)
    - tests: test_sector_score 24 断言(+T15-T18), 新增 test_pick_safe_spot 6 断言; 14 文件全绿
2026-10-21 fix(hri): pick_safe_spot 兜底彻底不朝门（补 f090e2f 两个残留口）
    世界 f090e2f 把回退从"门优先"改成"自由→背离门"，方向正确；复核发现仍有两个
    会朝门走的边界：
    1) 自由方向全落在门±45°锥内 → 旧兜底 `away or cand` 又退回朝门方向；
    2) 只取"最近门"的反方向 → 双门 0/180 时"背离 A = 朝 B"。
    修法：自由方向无净空时不回退到 cand；背离门改为"对所有门取最大净空"（候选=
    门反方向+8扇区中心），净空必须 >45°，否则返回 None（GOTO_SAFE 无参考→原地不动）。
    测试 test_pick_safe_spot 6→9（+T7 全在门锥/+T8 双门/+T9 门环绕原地不动），9/9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
2026-10-24 docs(review): 全仓审查 2026-10-24 —— 已验证 P0/P1/优化点/矛盾清单 + b8ae790 拉取后复核（已修/未修对照）
2026-10-24 docs(review): 统筹复核 + 白名单裁决 + passby 继续任务（写给审查者，不入 EXCHANGE）
2026-10-24 fix(rk_control): /move 补跟随模式门禁 —— 手动运动端点此前唯一漏闸的通道（白名单#1）
2026-10-24 fix(follow): _low_s 按真实帧间隔累加 —— 复活错锁逃逸判据(持续失配≥3.2s清跟踪器)（白名单#2）
2026-10-24 fix(rk_control): uart_send 失败计数+5s节流告警，/healthz 暴露 uart 统计 —— 死fd不再静默（白名单#3，附glue测试E段）
2026-10-24 fix(world): 超远(ring=3)物体跳过落格，抽出 stamp_objects 纯函数+回归 —— 消 >3m 目标 grid[3] IndexError（白名单#4）
2026-10-24 fix(world): 方位角 EWMA 跨±180缝按最短角差更新 —— 门/物体不再瞬移反方向（白名单#5，附回归）
2026-10-24 chore(docs/deploy): GAZE_ENABLED 表对齐代码现值False · settings.yaml 标失效 · .bak 退出git跟踪 · deploy.sh 补同步 deploy/configs/world（白名单#6）
2026-10-24 docs(review): §9-12 回执 —— 白名单六改清单+回归证据+板端待办；passby 诊断表(F1-F12)/补丁提案(OBS兜底/分析器/因果表)/T4排序与A/B设计
2026-10-24 docs(review): §13 回执 E —— 文档矛盾增量复审：旧21条中4已解决/11仍开放，新发现 N1-N9（速度档过期/TURN口径/看门狗能力表/服务清单三套等）
2026-10-24 test(rk_control): /move 门禁 handler 级回归（白名单#1 补测：follow 拒/manual 放行/模式相关/400 路径不吞）
2026-10-24 docs(review): §14 回执 F —— 补审视觉服务/部署面/测试台：标准档预设过期+重载档YAW_K反值(新P1)、模型在仓库外、geometry定时器=ring修复实战路径；/move门禁测试补齐(14/14)
2026-10-24 docs(review): §15 回执 G —— 多模块仲裁架构评审：现状全景表/三个缝(端点门禁类漏、归因缺口、云台无owner)/雷达接入四规则/优先级梯子
2026-10-24 docs(review): §16 统筹批准执行记录（面板预设/OBS兜底/N1N2N7文档；15/15 回归）
2026-10-24 feat(lidar): 路线2扫描桥入仓 + guard ts双时钟兼容 + X3Pro PC首测回填(附D)
    - world/fusion/ros_scan_bridge.py: ROS2 /scan → lidar_scan.json 契约桥(路线2),
    含左正→右正方位角转换/inf与毫米级噪点过滤/原子写入, PC 科研轨实测 10Hz 稳定
    - lidar_guard.py: ts 双时钟兼容——旧文档示例的 epoch 帧会让 scan_age 恒为 None,
    stale 检测静默失效(实测踩中); epoch 与墙钟对齐判龄, 超前墙钟不判
    - test_lidar_guard.py: T11c/T11d 双时钟断言(56→58)
    - V2_LIDAR_AVOIDANCE.md: §5.1 契约 ts 修订; 附 D 首测回填(10Hz/有效点80-100/
    spike_dense_n=100 边界踩线/腿级点稀疏/转速旋钮 6-7Hz/--record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
2026-10-24 docs(lidar): V2 雷达研究——作用界定/能力边界/边缘落地/感知增量五级阶梯
    - 作用: 四张牌(约束/指向/几何事实/备料)+传感器分权矩阵; 核心原则
    '雷达产生约束与几何事实, 不产生行为; 有指向权无声明权'
    - 边界: 实测三层量化——采样率文档两说(3000/4000)实测2330/s, 角分辨率
    实测1.66°/点(vs假设0.9°), 腿@10Hz 命中4/2/1点@1/2/4m(证实6Hz决议),
    室内有效距离P75=1.35m/max4.61m(8m仅高反表面), 每扇区3.5点(15°是上限)
    - 边缘落地: guard基准0.47ms/帧→A55约2%单核(算力非问题); 真正要管的:
    板上一律SDK直连(ROS只留PC轨, 内存被YOLO挤兑)/带供电hub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
2026-10-24 feat(pc_track): SLAM 沙盒脚手架 + PC 科研轨研究文档
    - docs/PC_SLAM_TRACK.md: roadmap §5 展开——轨道纪律(产品零依赖/数据单向/
    回流白名单)/选型研究(slam_toolbox 正选: 无里程计可用+四模式+posegraph
    续图; cartographer 备选; KISS-ICP 交叉验证; FAST-LIO/gmapping 不适用)/
    X3Pro 实测约束→参数映射表(稀疏1.66°→resolution下限; 无odom→慢走纪律+
    节点调密; 动态行人→复用guard Tracker动点剔除, 两轨首次真交集)/
    数据契约提案(V2b 全速率 JSONL 双时间戳——吸取 guard 时钟 bug 教训;
    方位角左正还原)/实验计划 E1-E5 带判据(首图/尺度真值≤5%/10vs6Hz/
    动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
2026-10-24 feat(pc_track): E1 首跑——管线全通/手持常速跟丢的边界发现 + 8 条工程教训
    E1 结果(149.9s/1785帧全量):
    - ✅ 管线闭环: 录包→mcap抢救→规范bag→回放→扫描匹配→PGM+posegraph 存档
    (中途 USB 掉线/录包强杀截断, 1785 帧用 pip mcap 直读完整 chunk 全量救回)
    - ❌ 地图不达标: 三组配置(X3Pro定制/官方默认/每帧+大窗调参)一致——起步段
    成图, 行走即跟丢(占据 61-75 vs 完整房间~192 格; 自由空间碎 52 孤岛)
    - 排查链全排除: 数据质量✅(桶分析146-174点稳定) / 角标定✅(63种点数对应
    63种 increment, 驱动每帧自适应, 自洽) / DDS✅(localhost 统一后复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
2026-10-25 docs(review): 全仓优化专项审查 2026-10-25 —— 热路径21/算法3/重复8组/死代码6组/卫生6 + 附带正确性5条(SIM_TURN off臂失效等) + 证伪1条；只读未改代码
2026-10-25 docs(review): §9 统筹审查——质量通过；批准正确性小批，性能重构押后
2026-10-25 fix(sim): SIM_TURN=0 真正关掉转向通道 —— 旧代码只设 True 从不设 False, passby A/B off 臂失效成假对照 (优化审查§7.1-①, 统筹批#1)
2026-10-25 fix(rk_control): /turn TOCTOU —— active 检查+置位同入 turn_lock(预占位), worker 初始化挪入 try 并补 y0=None 兜底防预占位卡死; glue 测试新增 G 段(活跃期拒/并发10抢1/IMU拒绝不残留/到位即ok/y0兜底) (优化审查§7.1-⑤, 统筹批#2)
2026-10-25 fix(imu): 重零后弃一拍+重采 t_prev —— calibrate2 阻塞0.8s 期间无采样, 旧代码用过期 dt 积分丢旋转且下一拍 dt≈0.8s 过积分, 50°/s 下航向阶跳数十度 (优化审查§7.1-③, 统筹批#3)
2026-10-25 fix(nan): PAN/TLT 非有限值拒收 —— host json.loads 默认接受 NaN, min/max 的 nan 比较序会把 'PAN nan' 钳到顶死限位(165/180); 新增 _clamp_pose(isfinite) + sim 侧 isfinite 守卫; glue 测试新增 H 段 (优化审查§7.1-④, 统筹批#4; 固件侧 UB duty 押后)
2026-10-25 chore(rk_control): 摘除 BACK_SPD 假调参键 —— follow_controller 里零引用(backing 恒 False 的死分支), /motion/config 却可调可持久化, 现场调了没反应是排障陷阱; 面板预设同步去掉; glue 新增 I 段(get/set/持久化三处无假键·真键不受影响) (优化审查§1-#2, 统筹批#5; follow_con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
2026-10-25 chore(rk_control): uart_reader 删空读双等待 —— termios VTIME=1 已阻塞0.1s, else-sleep(0.05) 徒增 50ms 把 OBS 遥测处理延迟上限拖到 0.15s (优化审查§1-#5, 统筹批#5)
2026-10-25 docs(scripts): 旧代推流脚本加弃用横幅 —— video_stream.py(每帧重载模型+检测键 class/confidence 与 v7 链 c/p 不兼容) / video_stream_fast.py(与 yolo_daemon v3 的 stdout重定向+stderr JSON 协议不兼容, 已不可用); 启动即 stderr 警告, demo 后移 legacy/ 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
2026-10-25 docs(review): §10 回执 H —— 统筹批#1-#5 执行完毕(7 commit: SIM_TURN/turn锁/imu dt/NaN/BACK_SPD/uart双等待/弃用横幅); 离线回归 15/15 PASS(glue 新增 G/H/I 段); 板端待办 5 项; 环境事项: %TEMP%/inspect.py 遮蔽 stdlib
2026-10-25 docs(review): §11 统筹复核——7 条可接受，uart 空读需补 10ms 退避防死 fd 自旋
2026-10-25 fix(rk_control): uart_reader 空读补 10ms 防自旋退避 —— 死fd/EOF 时 os.read 立即返回空而非阻塞0.1s, 纯删 else-sleep 会 100% 自旋(恰是 C3 掉线场景); 延迟上限~110ms 仍优于旧150ms; glue 新增 J1 段(0.25s 迭代数<200 判非忙等) (统筹§11.1 复核必修项)
2026-10-25 fix(rk_control): _turn_start 线程启动失败回滚预占位 —— Thread.start 抛异常时 active 会永久 True → /turn 永久 busy; 补 try/except 清位+result=thread_fail; glue J 段补 J2 (统筹§11.1 极小概率项)
2026-10-25 docs(review): §12 回执 I —— §11 复核两项修正完毕(uart 10ms 防自旋退避 eda8d6c + /turn start 失败回滚 a5c7e0e); glue 新增 J 段两断言; 15 套回归全 PASS; 未推送
2026-10-25 feat(v2): S3 mecanum chassis pre-write — X-config kinematics, sign table, firmware skeleton + 140 offline tests; docs
